trollock/Solar_LoRa_GPS/Hardware/STM32L0/2017-07-13T19-34-48.587Z-Grasshopper.pinmap.jpg

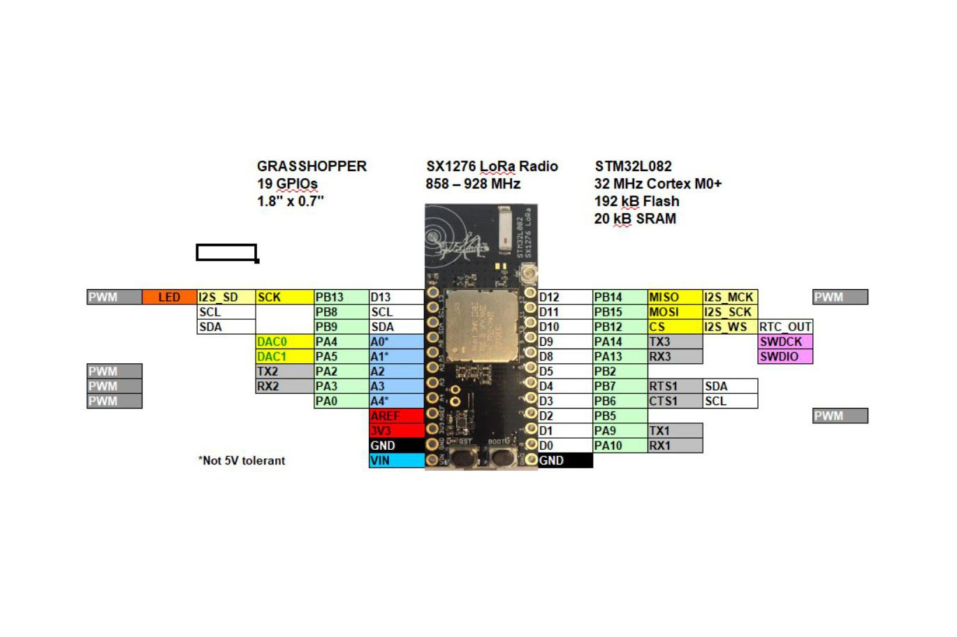
Hardware/STM32L0/2017-07-13T19-34-48.587Z-Grasshopper.pinmap.jpg
