trollock/Solar_LoRa_GPS/Images/IMG_4441.JPG

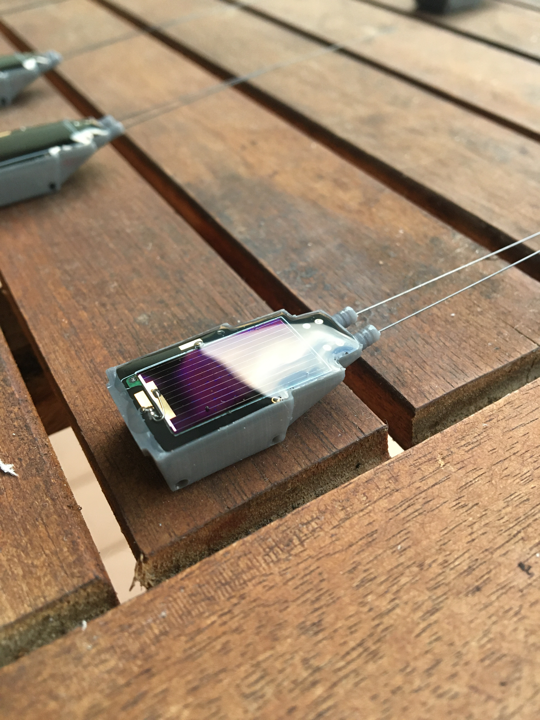
Images/IMG_4441.JPG
