trollock/Solar_LoRa_GPS/README.md

# Solar_LoRa_GPS
files related to the development of the Solar LoRa GPS radiotransceiver including information on the hardware and software
