trollock/Solar_LoRa_GPS/Hardware/duty_cycle_estimation_simple.xlsx

ephemeris update |  | 120
gps fix time |  | 3
current | time on | % on | uA | mA |  | mW power
18 | 7020 | 0.975 | 90.05 | 0.09005 | 2161.2 | 7.13196
2900 | 180 | 0.025
ephemeris update |  | 120
gps fix time |  | 3
current | time on | % on | uA | mA |  | mW power
3 | 7020 | 0.975 | 75.425 | 0.075425 | 1810.2 | 5.97366
2900 | 180 | 0.025
