trollock/Solar_LoRa_GPS/Power_Requirement_Estimates/bq25570SolarAppDesignExample_V1p3.xlsx

User Input
Computed/Fixed
 |  |  | VSTOR nominal | 3.00 | V |  |  |  |  | VBAT_UV < VSTOR nominal <= VBAT_OV
System Loads | VOUT (V) | IOUT (mA) | Est Buck Effcy per datasheet | ISTOR = (VOUTxIOUT) / (VSTORnom x Effcy) (mA) | Mode Duration (how long?) (s) | Mode Period (how often?) (s) | Mode Hours / Day = 24 hours x duration/ period | mAHr / Day = ISTOR X Mode Hrs / Day | mWHr / Day = VSTOR x mAHr / Day
Active Mode 1 - bq25570 VOUT | 3.700 | 29.000 | 0.900 | 39.741
Active Mode 1 - bq25570 VSTOR |  |  |  | 8.000 |  |  |  |  |  | Direct loading on VSTOR
Totals for Active Mode 1 |  |  |  | 47.741 | 8.000 | 3600.000 | 0.053 | 2.546 | 7.639
Active Mode 2 - bq25570 VOUT | 3.700 | 0.000 | 0.850 | 0.000 |  |  |  |  |  | If only one active mode, enter 0 for IOUT.
Active Mode 2 - bq25570 VSTOR |  |  |  | 0.000 |  |  |  |  |  | If only one active mode, enter 0 for ISTOR.
Totals for Active Mode 2 |  |  |  | 0.000 | 0.125 | 600.000 | 0.005 | 0.000 | 0.000
Sleep Mode - bq25570 VSTOR (1.8V rail off) |  |  |  | 0.100 |  |  | 23.942 | 2.394 | 7.182 | Idle mode hours / day = 24 minus active mode hours / day
bq25570 quiescent current + storage element leakage current |  |  |  | 0.001 |  |  | 24.000 | 0.024 | 0.072 | Storage element leaks all the time.
 | Total mAHr / day consumed |  |  |  |  |  |  | 4.964 | mAHr / day
 | Multiply by max consec dark days (e.g. not charging when overcast or raining) |  |  |  |  |  |  | 3.000 | days / week
 | Recommended minimum battery capacity |  |  |  |  |  |  | 14.893 | mAHr
 | -OR-
 | Mininum super capacitor voltage |  |  |  |  |  |  | 2.500 | V | VBAT_UV = 2.0V > Min super capacitor > VSTOR nominal
 | Maximum super capacitor voltage |  |  |  |  |  |  | 4.000 | V | VSTOR nominal < Max super capacitor voltage <= VBAT_OV
 | Recommended minimum super capacitance |  |  |  |  |  |  | 32.994 | F | Min Bat Capacity / 1000 x 3600s/hr x VSTORNOM = 1/2 x CSUPER x (Vmax2 - Vmin2)
 |  | Total mWHr / day consumed |  |  |  |  |  |  | 14.893 | mWHr / day
 |  | Multiply by operating days per week |  |  |  |  |  |  | 7.000 | days / week
 |  | Total mWHr /week required for system operation for the week |  |  |  |  |  |  | 104.251 | mWHr / week
 |  | Divide by charging days per week |  |  |  |  |  |  | 4.000 | days / week | Operating days minus max consecutive dark days
 |  | Total mWHr / day required to be collected by solar panel during charging days |  |  |  |  |  |  | 26.063 | mWHr / day | Total 7-day power must be collected during 5 charging days
 |  | Divide by charging hours / day |  |  |  |  |  |  | 8.000 | hours / day | i.e., includes excess energy for charging the battery
 |  | Instantaneous power required from the solar panel |  |  |  |  |  |  | 3.258 | mW
 |  |  | Divide by low estimate of bq25570 efficiency per datasheet |  |  |  |  |  | 0.800
 |  |  | Minimum input power required for system operation |  |  |  |  |  | 4.072 | mW
 |  |  |  | Divide by panel power per panel datasheet |  |  |  |  | 2.000 | mW/cm2 | Use power from lowest expected light level
 |  |  |  | Minimum solar panel area required |  |  |  |  | 2.036 | cm2
