trollock/Solar_LoRa_GPS/Hardware/ADP_5090_DC_DC_Solar_Controller/MPPT_ADP509X.xlsx

Setting Maximum Power Point Tracking ADP509X
Cell Type | Vmppt | Vin | Open Circuit | Roc1 | Roc2
Default (Alta SJT) | 0.7850220264 | 0.9 | 1.1 | 18 | 4.7
Azurspace 3G28C | 1.617621145 | 1.2 | 1.7 | 18 | 4.7
