trollock/Solar_LoRa_GPS/Hardware/FR4_PCB_Mass_vs_Thickness_Estimates.xlsx

 |  |  |  | FR4 Thickness
Length | Width | Volume | Density | 1.6 | 0.8 | 0.6 | 0.4 | 0.2
 |  |  | g/cc
23 | 36 | 1.3248 | 2 | 2.6496 | 1.3248 | 0.9936 | 0.6624 | 0.3312
16 | 28 |  | 2 | 1.4336 | 0.7168 | 0.5376 | 0.3584 | 0.1792
4 | 8 |  | 2 | 0.1024 | 0.0512 | 0.0384 | 0.0256 | 0.0128
v21_L70
17 | 32 |  | 2 | 1.7408 | 0.8704 | 0.6528 | 0.4352 | 0.2176
14 | 24 |  | 2 | 1.0752 | 0.5376 | 0.4032 | 0.2688 | 0.1344
 |  |  |  |  |  | 0.42 | 0.1664
 |  |  |  |  |  | 0.16
 |  |  |  |  |  | 0.26
