trollock/Solar_LoRa_GPS/API_Integration/Plots/example_1.gif

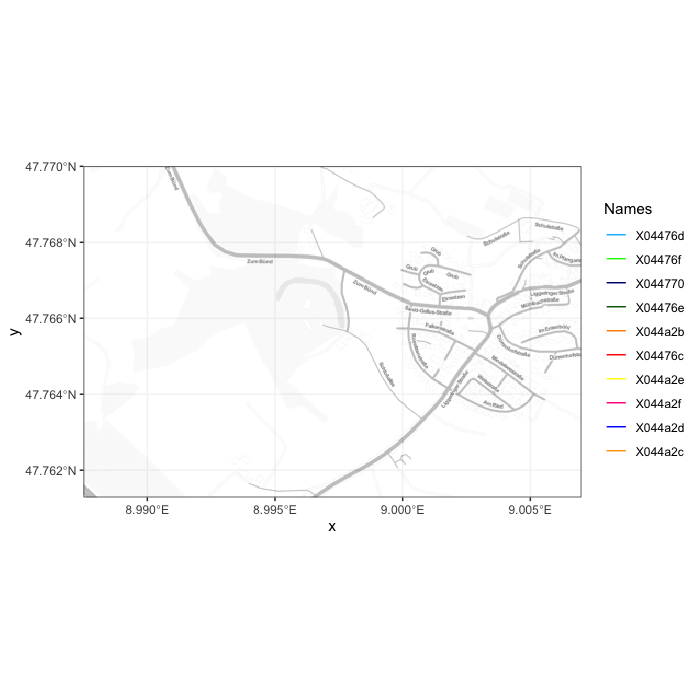
API_Integration/Plots/example_1.gif
