trollock/Solar_LoRa_GPS/API_Integration/Plots/example_2.gif

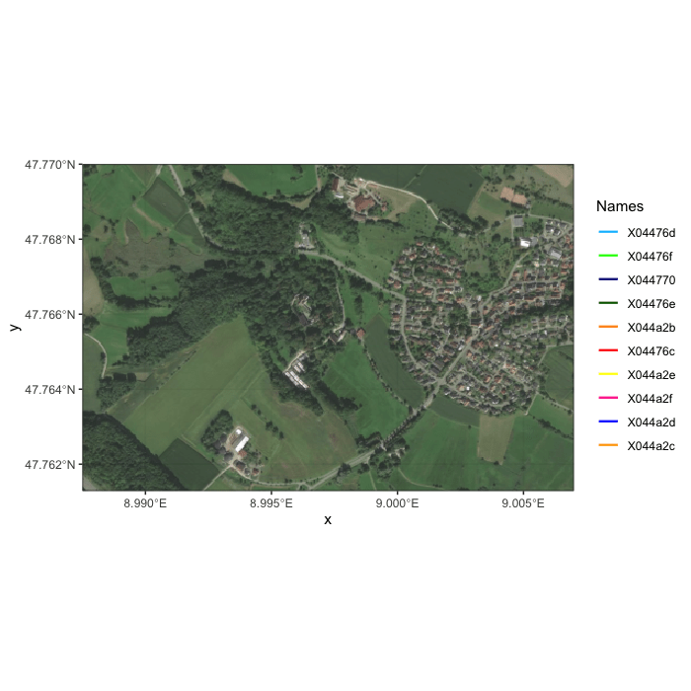
API_Integration/Plots/example_2.gif
