trollock/Solar_LoRa_GPS/API_Integration/Plots/last_10_days.gif

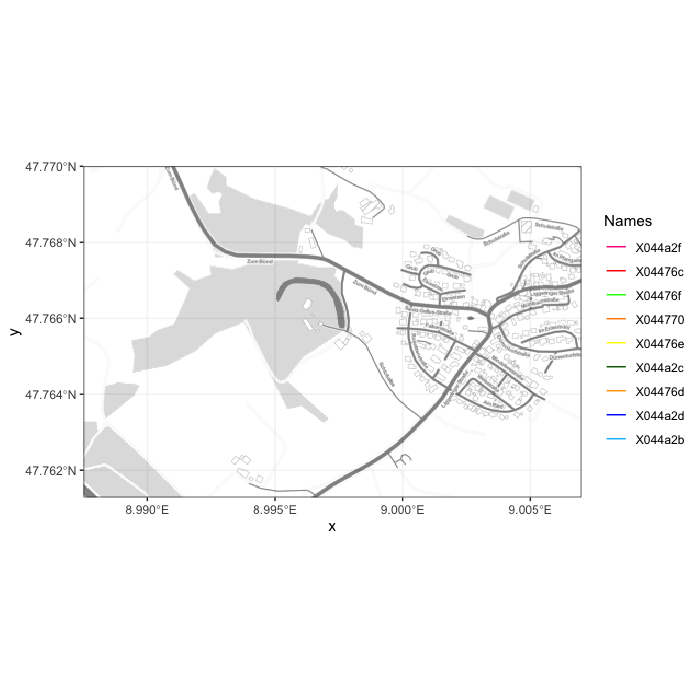
API_Integration/Plots/last_10_days.gif
