trollock/Solar_LoRa_GPS/API_Integration/Screen Shot 2019-12-16 at 12.39.08 PM.png

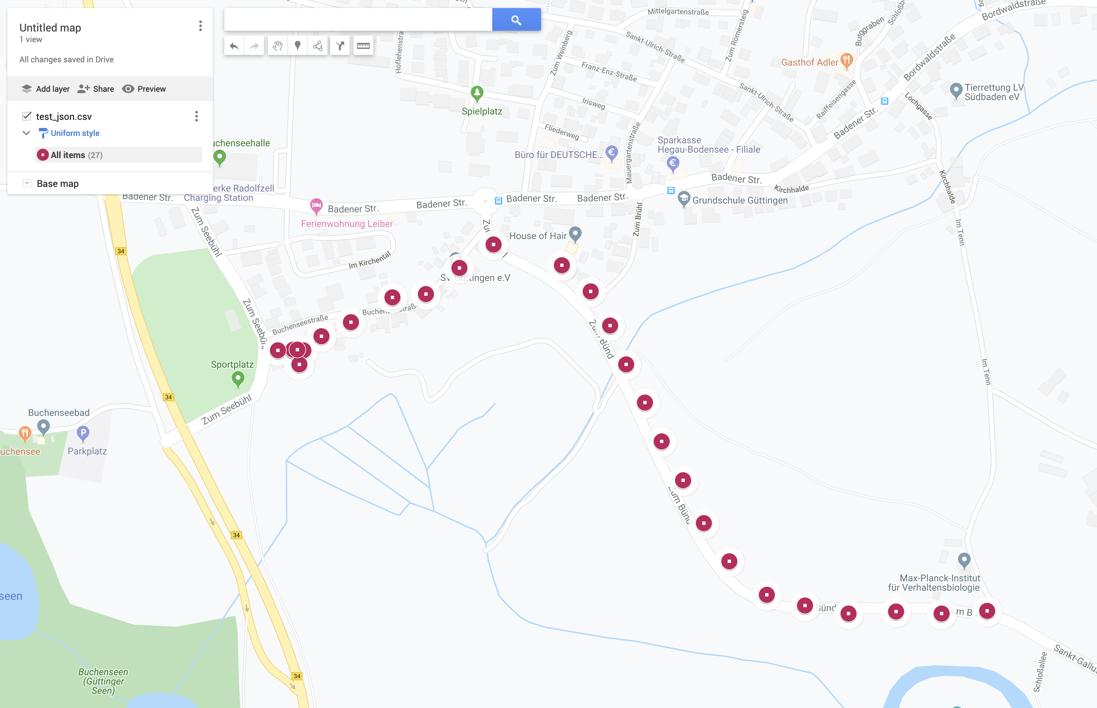
API_Integration/Screen Shot 2019-12-16 at 12.39.08 PM.png
