trollock/Solar_LoRa_GPS/Hardware/STM32L0/2017-09-04T02-27-59.959Z-Grasshopper.sch.jpg

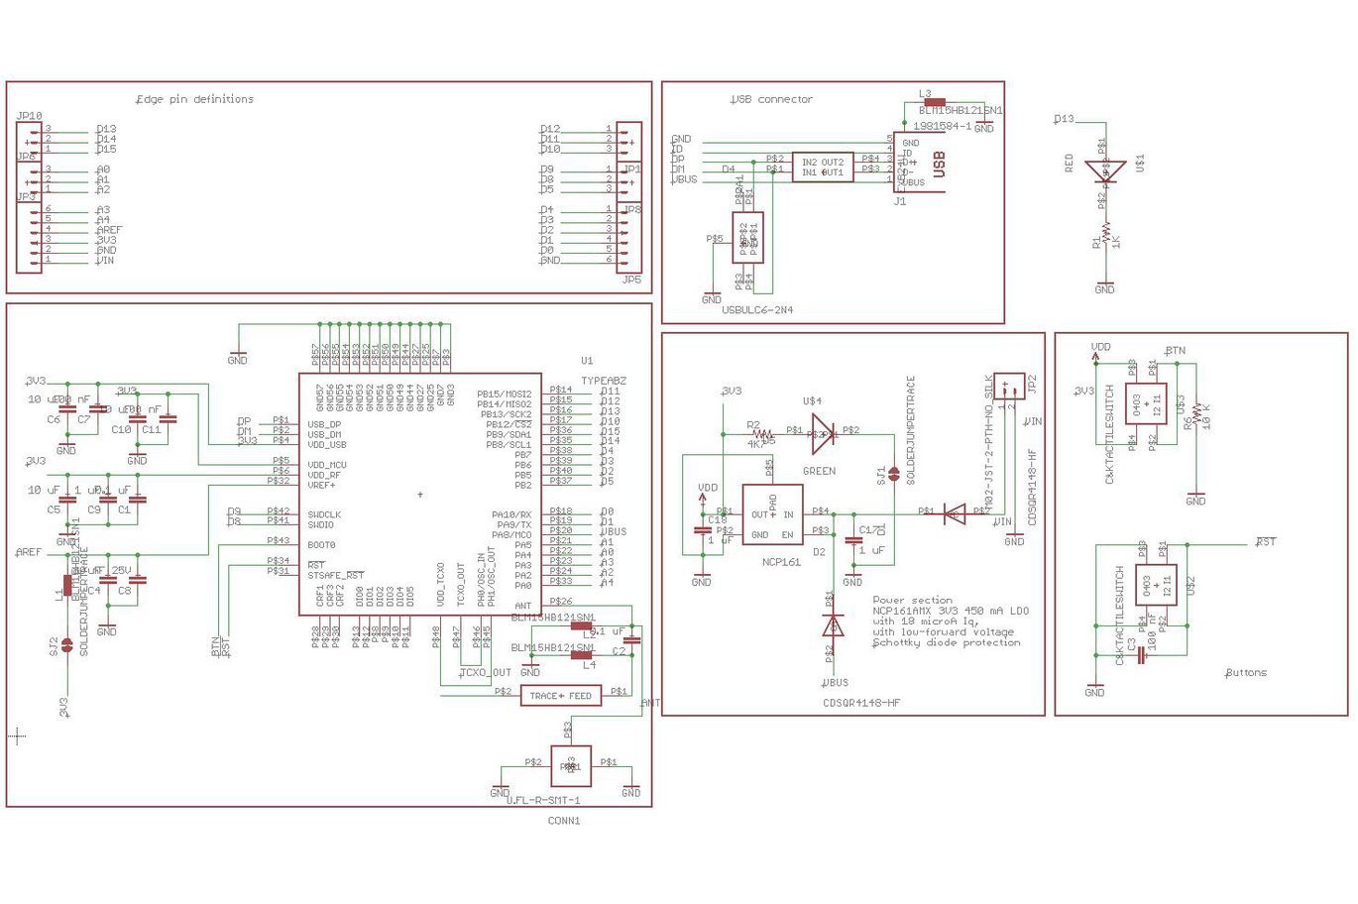
Hardware/STM32L0/2017-09-04T02-27-59.959Z-Grasshopper.sch.jpg
