trollock/Solar_LoRa_GPS/Hardware/STM32L0/2018-12-29T21-33-32.131Z-Gnat.sch.png

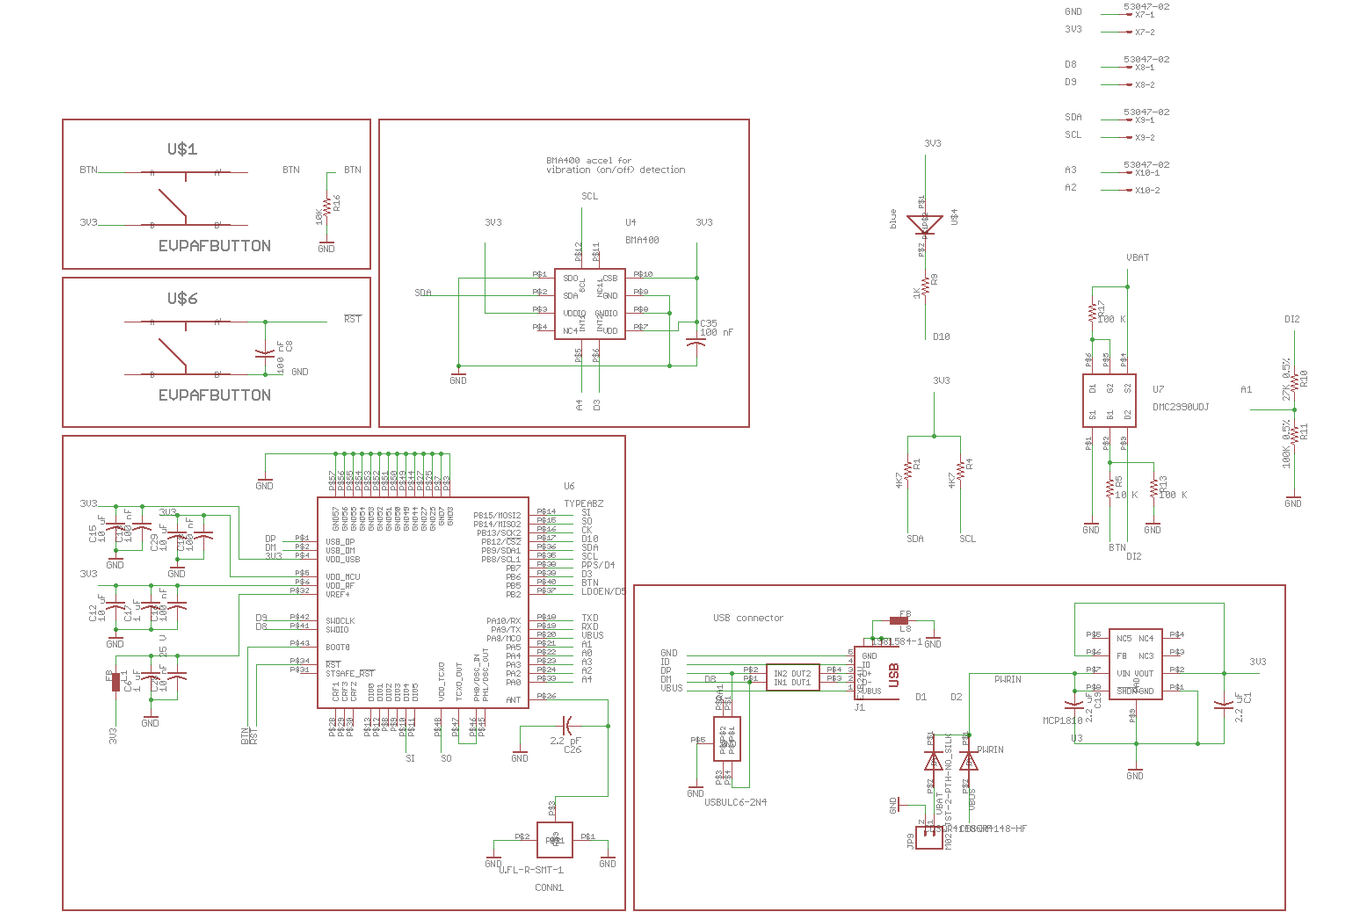
Hardware/STM32L0/2018-12-29T21-33-32.131Z-Gnat.sch.png
