trollock/Solar_LoRa_GPS/Images/Amsel_v5_LoRaWAN_tag.png

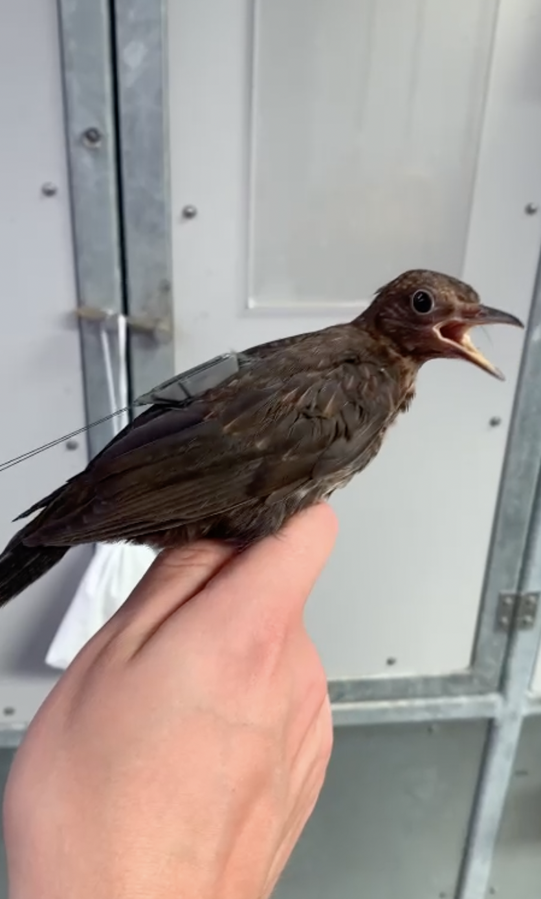
Images/Amsel_v5_LoRaWAN_tag.png
