trollock/Solar_LoRa_GPS/Parts_Lists/Parts_List_v22_July_28.xlsx

Partl | ist
Expor | ted | from GPS_radiologger_v | 22_L70_CMWX.brd at 7/28/21 12 | :17 PM
EAGLE | Ver | sion 9.6.2 Copyright ( | c) 1988-2020 Autodesk, Inc.
Assem | bly | variant:
Part |  | Value | Package | Library | Position (mm) | Orientation
C1 | X | 0.1 uF | C0201 | rcl | (1.41 3.545) | R180
C2 | X | 1 uF | C0201 | rcl | (24.05 2.55) | R90
C4 | X | 10nF | C0201 | rcl | (5.8 2.56) | R180
C7 | X | 0.1 uF | C0201 | rcl | (21.655 2.775) | R0
C9 | X | 1 uF | C0201 | rcl | (1.59738125 13.205) | R270
C10 | X | 0.1 uF | C0201 | rcl | (1.08 13.205) | R270
C13 | X | 47 uF | C0603 | rcl | (14.9 1.81) | R270
C14 | X | 4.7 uF | C0201 | rcl | (2.05 2.31) | R180
C17 | X | 1 uF | 0402-CAP | SparkFun-Capacitors | (19.45 2.5) | R270
C18 | X | 1 uF | 0402-CAP | SparkFun-Capacitors | (16.55 2.5) | R270
IC4 | X | CAT24M01HU5I-GT3 | SON50P300X200X55-9N | CAT24M01HU5I-GT3-CorrectedV2 | (4.048 2.5326) | R270
J1 | DNP |  | 1X01_SMALL | SparkFun-Connectors | (16.25 15.55) | R0
J3 | DNP |  | 1X01_SMALL | SparkFun-Connectors | (16.3 0.8) | R0
J4 | DNP |  | 1X03_1.27MM_NO_SILK | SparkFun-Connectors | (1.25 4.5) | R90
J6 | DNP |  | 1X04_1.27MM_NO_SILK | SparkFun-Connectors | (1.25 8.3) | R90
R1 | X | 4.7 k | R0201 | rcl | (2.05 1.1) | R180
R2 | X | 4.7 k | R0201 | rcl | (2.05 1.75) | R180
R3 | X | 10k | R0201 | rcl | (1.405 2.975) | R0
R6 | X | 10 M | R0201 | rcl | (21.655 2.18) | R180
R7 | X | 4.7 M | R0201 | rcl | (20.905 2.505) | R90
R8 | X | 3M | R0201 | rcl | (5.8 3.95) | R0
R9 | X | 9.1M | R0201 | rcl | (5.8 3.15) | R0
R10 | X | 6.2M | R0201 | rcl | (14.59 3.69) | R0
R11 | X | 1M | R0201 | rcl | (6.05 1) | R90
R12 | X | 3M | R0201 | rcl | (5.8 1.79) | R180
U$1 | X | LPS3015 | LPS_3015 | coilcraft_custom | (12.2 2.285) | R90
U$2 | DNP | NITINOL_ANTENNA_SHORT | ICARUS_NITINOL_ANTENNA_SHORT | Antenna_mounts | (27.8 5.7) | R0
U$3 | DNP | ICARUS_FULL | ICARUS_FULL | TrisolX_Solar_Cells | (14.35 8.2) | MR90
U$4 | DNP | NITINOL_ANTENNA_SHORT | ICARUS_NITINOL_ANTENNA_SHORT | Antenna_mounts | (27.8 10.7) | R180
U$6 | DNP | ICARUS_V4_FOOTPRINT | ICARUS_FULL_FOOTPRINT | TrisolX_Solar_Cells | (14.05 8.2) | MR270
U1 | X | TYPEABZ | TYPEABZ | Kris | (8.236734375 10.15) | R0
U2 | X | L70 | XCVR_L70 | L70 | (20.05 8.9) | R90
U3 | X | TPS22907 | TPS22916 | TPS22916V2 | (20.7 0.45) | R90
U4 | X | SPV1050 | SPV1050 | STM-SPV1050_V2 | (8.02 2.49) | R0
U5 | X | TPS7A03 | NCP161 | Kris | (18 2.6) | R270
U6 | X | TPS22907 | TPS22916 | TPS22916V2 | (23.1 2.5) | R270
