trollock/Solar_LoRa_GPS/Hardware/Component_Masses.xlsx

 | Component | part number | notes | Mass
ICARUS | pcb | n/a | without battery or housing | 2.05
ICARUS | pcb w/ battery | n/a | with 70 mAh battery | 3.7
ICARUS | battery |  |  | 1.65
LoRa | pcb | n/a | 0.4 mm 2-layer | 0.65 | 1.37 | 0.325
 | CCMWX1ZZABZ | CCMWX1ZZABZ | 78 | 0.48 |  | 0.48
 | uBlox GPS | ZOE-M8Q |  | 0.07 |  | 0.07
 | DC-DC | ADP-5090 |  | 0.01 |  | 0.01
 | Solar cell | ??? | 12x21mm | 0.16 |  | 0.16
 |  |  |  | 1.37 |  | 1.045
 | Lithium polymer battery | Italian eBay | 45 mAh | 1.1 |  | 2.47
 |  | Powerstream | GM30101H 14 mAh 140 mA C | 0.54 |  | 1.585
 |  | Powerstream | GM301016 25 mAh | 0.62 |  | 1.665
 |  | Powestream | 8 mAh | 0.33 |  | 1.375
