trollock/Solar_LoRa_GPS/Development Notes/PMIC_database.xlsx

 |  | Cold startup |  | MPPT voltage |  | Quiescent ON | Quiescent SLP | I2C Config. | Max LDO Current | LDO | Package | Package Dim | Passives | Rec. Inductor | Typical Price | Price Unit | Available | Distributor | Quantity | Date
Manufacturer | Device | mV | uW | min (mV) | max (V) | nA | nA | Y/N | mA |  |  | L x W | RCL | uH | € | per
Maxim Integrated | MAX20361 | 225 | 15 | 225 | 2.5 | 360 | 190 | Yes | 90-470 | No | WLP | 1.6 x 1.2mm | 2 C, 1 L | 4.7 | 5,00 € | per 500 | Factory | Maxim | 2070 | 2022-02-11
ePEAs | AEM10900 | 250 | 5 | 115 | 1.5 | 300 | 150 | Yes | n/a | No | WLCSP | 2 x 2mm | 2 C, 1 L | 4.7 | ? | ? | No |  |  | 2022-02-11
ePEAs | AEM10900 | 250 | 5 | 115 | 1.5 | 300 | 150 | Yes | n/a | No | QFN | 4 x 4mm | 2 C, 1 L | 4.7 | 3,87 € | per 25 | Yes | Tekmodul | ? | 2022-02-11
ePEAs | AEM10941 | 380 | 3 | 50 | 5 | ? | ? | No | 80 | Yes | QFN | 5 x 5mm | 5 C, 2 L | 10 | 4,55 € | per 500 | Yes | Mouser | 1697 | 2022-02-11
ePEAs | AEM10300 | 275 | 3 | 100 | 4.5 | ? | 5.9 | No | n/a | No | QFN | 4 x 4mm | 2 C, 1 L | 10 | ? | ? | No |  |  | 2022-02-11
ePEAs | AEM10330 | 275 | 3 | 100 | 4.5 | ? | 875 | No | 60 | Yes | QFN | 5 x 5mm | 3 C, 1 L | 10 | 5,06 € | per 500 | Yes | Tekmodul | ? | 2022-02-11
Analog Devices | ADP5090 | 380 | 16 | 80 | 3.3 | 320 | 260 | No | n/a | No | LFCSP | 3 x 3mm | 9 R, 2 C, 1 L | 22 | 4,63 € | per 500 | Yes | Digikey | 1448 | 2022-02-11
Analog Devices | ADP5091/92 | 380 | 6 | 80 | 3.3 | 510 | 390 | No | n/a | No | LFCSP | 3 x 3mm | 9 R, 2 C, 1 L | 22 | 5,27 € | per 500 | Yes | Digikey | 3042 | 2022-02-11
ST Microelectronics | SPV1050TTR | 550 | 16 | 150 | 4.3 | 1700 | 1 | No | n/a | Yes | QFN | 3 x 3mm | 6 R, 3 C, 1 L | 22 | 2,80 € | per 500 | No |  |  | 2022-02-11
Texas Instruments | BQ25504 | 600 | 15 | 130 | 3 | ? | 330 | No | n/a | No | QFN | 3 x 3mm | 9 R, 3 C, 1 L | 22 | 3,06 € | per 500 | Yes | Mouser | 1862 | 2022-02-11
