trollock/Solar_LoRa_GPS/EAGLE/v23_L70_CMWX/Shipment_to_PCBWay/Shipping_Contents.xlsx

Contents (total components per piece for prototype sample)
Qty | Mechnaical Value | Device | Group | Parts | Value (CHF)
2 | 0.1 uF | C-EUC0201 | 0201 Capacitor | C1, C7 | 0.045
2 | 1 uF | 0402CAP.KW | 0201 Capacitor | C17, C18 | 0.045
2 | 1 uF | C-EUC0201 | 0201 Capacitor | C2, C9 | 0.045
1 | 10k | R-EU_R0201 | 0201 Resistor | R3 | 0.045
1 | 10nF | C-EUC0201 | 0201 Capacitor | C4 | 0.045
1 | 150 K | R-EU_R0201 | 0201 Resistor | R7 | 0.03
1 | 1M | R-EU_R0201 | 0201 Resistor | R11 | 0.03
1 | 300 K | R-EU_R0201 | 0201 Resistor | R6 | 0.03
2 | 3M | R-EU_R0201 | 0201 Resistor | R8, R12 | 0.03
2 | 4.7 k | R-EU_R0201 | 0201 Resistor | R1, R2 | 0.03
1 | 4.7 uF | C-EUC0201 | 0201 Capacitor | C14 | 0.045
1 | 47 uF | C-EUC0603 | 0201 Capacitor | C13 | 0.045
1 | 6.2M | R-EU_R0201 | 0201 Resistor | R10 | 0.03
1 | 9.1M | R-EU_R0201 | 0201 Resistor | R9 | 0.03
1 | CAT24M01HU5I-GT3 | CAT24M01HU5I-GT3 | Transistor Switch | IC4 | 0.09
1 | L70 | L70 | GNSS / GPS Module | U2 | 1.51
1 | LPS3015 | LPS3015 | 22 uH Inductors | U$1 | 0.05
1 | NCP161 | NCP161 | Transistor Switch | U5 | 0.09
1 | SPV1050 | SPV1050 | Transistor Switch | U4 | 0.09
2 | TPS22907YZT | TPS22907YZT | Transistor Switch | U3, U6 | 0.09
1 | TYPEABZ | TYPEABZ | LoRaWAN Radio | U1 | 1.65
 |  |  | Total value per piece |  | 4.97
Sample components for assembly of 100 pieces are included in shipment, total value ~497 CHF (Swiss Francs)
