trollock/Solar_LoRa_GPS/Hardware/Approximate_Costs.xlsx

CMWX_v25
Component | Component | Vendor | Units | Inventory |  | Cost (ea) | Subtotal | Shipping | MWSt | Subtotal | Ordered
CMWX1ZZABZ-078 |  | multiple | 394 | 394 |  | 22.195
 | CMWX1ZZABZ-078 | SensiEdge | 39 |  | USD | 28 | 1092
 | CMWX1ZZABZ-078 | SensiEdge | 80 |  | USD | 28 | 2240
 | CMWX1ZZABZ-078 | Farnell | 200 |  | CHF | 16.39 | 3278 |  | 252.41
 | CMWX1ZZABZ-078 | Farnell | 75 |  | CHF | 16.39 | 1229.25 |  | 94.65 |  |  | 0
LG77LAMD |  | multiple | 224 | 224 |  | 4.415
 | LG77L-A | TekModule.de | 24 |  | EU | 4.86 | 116.64 | 0 | 0
 | LG77L-A | TekModule.de | 200 |  | EU | 3.97 | 794 | 0 | 0
BMP581 |  | Digikey | 0 | 0 | EU | 2.699 | 0 |  | 0 |  | 400
MAX20361 |  |  | 428 | 0 |  | 4.515 |  |  |  |  | 428
 | MAX20361 | Farnell | 328 | 0 | CHF | 4.07 | 1334.96 | 0 |  |  | 328
 | MAX20361 | Digikey | 100 | 0 | USD | 4.96 | 496 | 0 | 38.192 |  | 100
LC709203 |  | Rochester Electronics | 447 | 0 | EU | 0.6249 | 279.3303 |  |  | 319.47 | 447
TPS7A0333PYCHR (https://www.mouser.ch/ProductDetail/Texas-Instruments/TPS7A0333PYCHR?qs=DRkmTr78QASt%252BMCkG4QYQg%3D%3D) |  | Mouser | 400 | 0 | CHF | 0.6 | 240
TPSS22916? |  |  |  | 0 |  |  | 0
CAT24C512C8UTR (https://www.mouser.ch/ProductDetail/863-CAT24C512C8UTR) |  | Mouser | 400 | 0 |  | 0.794 | 317.6
ICARUS v2 |  | MPIAB / CESI | 22 | 0 | EU
GEB 401012 30 mah |  | GEB Battery | 400 | 0 | EU | 0.895 | 358 | 195 | ??? |  | 400
