trollock/Solar_LoRa_GPS/EAGLE/v23_L70_CMWX/v23_Shipley_BOM_PCBWay.xlsx

 |  |  | CMWX LoRaWAN Tag v23 Shipley 100 PCS BOM (Sample Bill of Materials)
Item # | *Designator | *Qty | Manufacturer | *Mfg Part # | Description / Value | *Package/Footprint | Position | Orientation | Type | Your Instructions / Notes
1 | C1 | 1 | Murata | GRT033R60J104KE01D | 0.1 uF | C0201 | (1.455 5.06) | R270 | SMD
2 | C2 | 1 | Murata | GRM033R60J105MEA2D | 1 uF | C0201 | (24.85 2.65) | R270 | SMD
3 | C4 | 1 | Murata | GRM033R71A103KA01D | 10nF | C0201 | (5.8 2.46) | R180 | SMD
4 | C7 | 1 | Murata | GRT033R60J104KE01D | 0.1 uF | C0201 | (20.125 2.345) | R270 | SMD
5 | C9 | 1 | Murata | GRM033R60J105MEA2D | 1 uF | C0201 | (1.49738125 12.455) | R270 | SMD
6 | C13 | 1 | Murata | GRM188R60J476ME01D | 47 uF | C0603 | (14.8 1.71) | R270 | SMD
7 | C14 | 1 | Murata | GRM035R60G475ME15D | 4.7 uF | C0201 | (2.05 2.31) | R180 | SMD
8 | C17 | 1 | Murata | GRT155R61C105KE01J | 1 uF | 0402-CAP | (19.35 2.5) | R270 | SMD
9 | C18 | 1 | Murata | GRT155R61C105KE01J | 1 uF | 0402-CAP | (16.55 2.5) | R270 | SMD
10 | IC4 | 1 | ON Semiconductor | CAT24M01HU5I-GT3 | CAT24M01HU5I-GT3 | SON50P300X200X55-9N | (4.048 2.4326) | R270 | SMD
11 | J1 | 1 | n/a | n/a | 1_PIN | 1X01_SMALL | (16.25 15.55) | R0 | DNP | Do not install
12 | J3 | 1 | n/a | n/a | 1_PIN | 1X01_SMALL | (16.25 0.8) | R0 | DNP | Do not install
13 | R1 | 1 | Vishay-Dale | CRCW02014K70FKED | 4.7 k | R0201 | (2.05 1) | R180 | SMD
14 | R2 | 1 | Vishay-Dale | CRCW02014K70FKED | 4.7 k | R0201 | (2.05 1.7) | R180 | SMD
15 | R3 | 1 | Vishay-Dale | CRCW020110K0FNED | 10k | R0201 | (1.425 6.555) | R90 | SMD
16 | R6 | 1 | Vishay-Dale | CRCW0201300KFNED | 300 K | R0201 | (20.78 2.345) | R90 | DNP | Do not install
17 | R7 | 1 | Vishay-Dale | CRCW0201150KFNED | 150 K | R0201 | (21.445 2.345) | R270 | DNP | Do not install
18 | R8 | 1 | Vishay-Dale | CRCW02013M00FNED | 3M | R0201 | (5.8 3.85) | R0 | SMD
19 | R9 | 1 | Vishay-Dale | CRCW02019M09FNED | 9.1M | R0201 | (5.8 3.05) | R0 | SMD
20 | R10 | 1 | Panasonic | ERJ-1GNJ625C | 6.2M | R0201 | (14.59 3.59) | R0 | SMD
21 | R11 | 1 | Vishay-Dale | CRCW02011M00FNED | 1M | R0201 | (6.05 0.9) | R90 | SMD
22 | R12 | 1 | Vishay-Dale | CRCW02013M00FNED | 3M | R0201 | (5.8 1.64) | R180 | SMD
23 | U$1 | 1 | Coilcraft | LPS3015-223MRC | LPS3015 | LPS_3015 | (12.2 2.185) | R90 | SMD
24 | U$2 | 1 | n/a | n/a | NITINOL_ANTENNA_SHORT | non-standard | (27.8 5.7) | R0 | DNP | Do not install
25 | U$3 | 1 | n/a | n/a | ICARUS_FULL_RAW (CESI) | non-standard | (14.35 8.2) | MR90 | DNP | Do not install
26 | U$4 | 1 | n/a | n/a | NITINOL_ANTENNA_SHORT | non-standard | (27.8 10.7) | R180 | DNP | Do not install
27 | U$5 | 1 | n/a | n/a | CASTELLATED_7_PIN | CASTELLATED_7_PIN | (0.4 3.8) | R0 | DNP | Do not install
28 | U$6 | 1 | n/a | n/a | ICARUS_V4_FOOTPRINT (CESI) | non-standard | (14.05 8.2) | MR270 | DNP | Do not install
29 | U1 | 1 | Murata | CMWX1ZZABZ | Murata CMWX LoRaWAN STM32 based radio | TYPEABZ | (8.236734375 10.15) | R0 | SMD
30 | U2 | 1 | Quectel | L70B-M39 | Low-power GNSS/GPS Receiver | XCVR_L70 | (20.05 8.9) | R90 | SMD
31 | U3 | 1 | Texas Instruments | TPS22907YZTR | TPS22907YZT | YFP0004-DSBGA | (22.25 2.6) | R270 | SMD
32 | U4 | 1 | STMicroelectronics | SPV1050TTR | SPV1050 | SPV1050 | (8.02 2.39) | R0 | SMD
33 | U5 | 1 | Texas Instruments | TPS7A0333DQNR | TPS7A0333DQNR | TPS7A0333DQNR | (17.95 2.6) | R270 | SMD
34 | U6 | 1 | Texas Instruments | TPS22907YZTR / YZTT | TPS22907YZT / YSTT | YFP0004-DSBGA | (23.4 2.6) | R180 | SMD
