trollock/Solar_LoRa_GPS/EAGLE/v22_CMWX_L70/Gerbers/CMWX_V22_BOM.xlsx

 |  |  | Peltier_controller_v2_1 25PCS BOM (Sample Bill of Materials)
Item # | *Designator | *Qty | Manufacturer | *Mfg Part # |  | Description / Value | *Package/Footprint | Type | Your Instructions / Notes
1 | J1, J3 | 2 | N/A | N/A |  | N/A | 1X01_SMALL | N/A | Via Array
2 | J5 | 1 | N/A | N/A |  | N/A | 1X03_1.27MM_NO_SILK | N/A | Via Array
3 | J2 | 1 | N/A | N/A |  | N/A | 1X06_1.27MM | N/A | Via Array
4 | C1, C7, C10 | 3 | Murata | GRT033R60J104KE01D | X | 0.1 uF | C0201 | SMD | Will provide parts
5 | C17, C18 | 2 | Murata | GRT155R61C105KE01J | X | 1 uF | 0402-CAP | SMD | Will provide parts
6 | C2, C9 | 2 | Murata | GRM033R60J105MEA2D | X | 1 uF | C0201 | SMD | Will provide parts
7 | R6 | 1 | Vishay Dale | CRCW020110M0FNED | X | 10 M | R0201 | SMD | Will provide parts
8 | R3 | 1 | Vishay Dale | CRCW020110K0FNED | X | 10k | R0201 | SMD | Will provide parts
9 | C4 | 1 | Murata | GRM033R71A103KA01D | X | 10nF | C0201 | SMD | Will provide parts
10 | R11 | 1 | Vishay Dale | CRCW02011M00FNED | X | 1M | R0201 | SMD | Will provide parts
11 | R8, R12 | 2 | Vishay Dale | CRCW02013M00FNED | X | 3M | R0201 | SMD | Will provide parts
12 | R7 | 1 | Vishay Dale | CRCW02014M70FNED | X | 4.7 M | R0201 | SMD | Will provide parts
13 | R1, R2 | 2 | Vishay Dale | CRCW02014K70FKED | X | 4.7 k | R0201 | SMD | Will provide parts
14 | C14 | 1 | Murata | GRM035R60G475ME15D | X | 4.7 uF | C0201 | SMD | Will provide parts
15 | C13 | 1 | Murata | GRM188R60J476ME01D | X | 47 uF | C0603 | SMD | Will provide parts
16 | R10 | 1 | Panasonic | ERJ-1GNJ625C | X | 6.2M | R0201 | SMD | Will provide parts
17 | R9 | 1 | Vishay Dale | CRCW02019M09FNED | X | 9.1M | R0201 | SMD | Will provide parts
18 | IC4 | 1 | ON Semiconductor | CAT24M01HU5I-GT3 | X | CAT24M01HU5I-GT3 | SON50P300X200X55-9N | SMD | Will provide parts
19 | D2 | 1 | Comchip | CDSQR4148-HF | X | CDSQR4148-HF | CDSQR4148-HF | SMD | Will provide parts
20 | U$3 | 1 | CESI | N/A |  | ICARUS_FULL | ICARUS_FULL | N/A | DO NOT INSTALL
21 | U$6 | 1 | CESI | N/A |  | ICARUS_V4_FOOTPRINT | ICARUS_FULL_FOOTPRINT | N/A | DO NOT INSTALL
22 | U2 | 1 | Quectel | L70-M39 |  | L70 | XCVR_L70 | SMD | Will provide parts
23 | U$1 | 1 | Coilcraft | LPS3015-222MRB |  | LPS3015 | LPS_3015 | SMD | Will provide parts
23 | U5 | 1 | Texas Instruments | TPS7A03 | X | TPS7A03 | NCP161 | SMD | Will provide parts
24 | U$2, U$4 | 2 | N/A | N/A |  | NITINOL_ANTENNA_SHORT | ICARUS_NITINOL_ANTENNA_SHORT | N/A | DO NOT INSTALL
25 | U4 | 1 | STMicroelectronics | SPV1050TTR | X | SPV1050 | SPV1050 | SMD | Will provide parts
26 | U6 | 1 | Texas Instruments | TPS22907YZTR | X | 296-39359-1-ND | TPS22916 | SMD | Will provide parts
27 | U1 | 1 | Murata | N/A |  | TYPEABZ | TYPEABZ | SMD | Will provide parts
