trollock/Solar_LoRa_GPS/EAGLE/v27_LG77L_CMWX/BOM/v27_Shipley_BOM_PCBWay.xlsx

Item # | *Designator | *Qty | Chk | Sent | Qty | Manufacturer | Part # | Manufacture Part # | Vendor | Description / Value | *Package/Footprint | Position X | Position Y | Orientation | Type | Notes
1 | ANT_GPS | 1 |  |  |  | N/A | NITINOL_ANTENNA_SHORT | N/A |  | NITINOL_ANTENNA_SHORT | N/A | 22.45 | 7.96 | 180 | DNP | Do not install
2 | ANT_LORA | 1 |  |  |  | N/A | NITINOL_ANTENNA_SHORT | N/A |  | NITINOL_ANTENNA_SHORT | N/A | 22.45 | 5.21 | 0 | DNP | Do not install
3 | C3 | 1 | X | X | 30 | Generic | 10 uF | GRM188R6YA106MA73J (https://www.mouser.ch/ProductDetail/Murata-Electronics/GRM188R6YA106MA73J?qs=5aG0NVq1C4xLSwNPdfnaYg%3D%3D) | Mouser | 10 uF | 0603 | 22.71 | 2.63 | 270 | SMD
4 | C4 | 1 | X | X | 30 | Generic | 1 uF | GRM155R61E105MA12D (https://www.mouser.ch/ProductDetail/Murata-Electronics/GRM155R61E105MA12D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) | Mouser | 1 uF | 0402 | 19.37 | 3.85 | 270 | SMD
5 | C5 | 1 | X | X | 30 | Generic | 1 uF | GRM155R61E105MA12D | Mouser | 1 uF | 0402 | 18.39 | 3.85 | 270 | SMD
6 | C6 | 1 | X | X | 30 | Generic | 0.1 uF | GRM152R61A104KE19D (https://www.mouser.ch/ProductDetail/Murata-Electronics/GRM152R61A104KE19D?qs=IPQhFcwEUOjgOs7G%2Fz457g%3D%3D) | Mouser | 0.1 uF | 0402 | 17.18 | 4.5 | 270 | SMD
7 | C7 | 1 | X | X | 30 | Generic | 1 uF | GRM033R61C105ME15D (https://www.mouser.ch/ProductDetail/Murata-Electronics/GRM033R61C105ME15D?qs=u16ybLDytRZR0II5ummfwQ%3D%3D) | Mouser | 1 uF | 0201 | 22.7 | 9.24 | 0 | SMD
8 | C8 | 1 | X | X | 30 | Generic | 1 uF | GRM155R61E105MA12D | Mouser | 1 uF | 0402 | 15.98 | 4.5 | 90 | SMD
9 | L1 | 1 | X | X | 30 | Generic | IND_2016 | DFE201612E-4R7M=P2 (http://d.digikey.com/dc/mn-w0iJh4uEE_bUitNCuXoeYCNqWjdFJOsEcI8P3zDcZzOqW_iasKJiGfNmrrTll8T7knO_YFXMTrQ88nCrHN4RU2joFqNz155VCzsN_fPqf-AcK-Sq-HRaRQFTFBI-JVvVK6R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) | Mouser | IND_2016 | 2016 | 20.97 | 2.63 | 90 | SMD
10 | R1 | 1 | X | X | 30 | Generic | 4.7 k | ERA-1AEB472C (https://www.mouser.ch/ProductDetail/Panasonic/ERA-1AEB472C) | Mouser | 4.7 k | 0201 | 22.68 | 10.35 | 180 | SMD
11 | R2 | 1 | X | X | 30 | Generic | 4.7 k | ERA-1AEB472C (https://www.mouser.ch/ProductDetail/Panasonic/ERA-1AEB472C) | Mouser | 4.7 k | 0201 | 22.7 | 10.98 | 180 | SMD
12 | R3 | 1 | X | X | 30 | Generic | 10k | ERA-1AEB103C (https://www.mouser.ch/ProductDetail/Panasonic/ERA-1AEB103C) | Mouser | 10k | 0201 | 22.69 | 9.8 | 180 | SMD
13 | U1 | 1 |  | X | 25 | Murata | TYPEABZ | CMWX1ZZABZ-078 |  | TYPEABZ | TYPEABZ | 6.74 | 7.8 | 0 | SMD
14 | U2 | 1 | X | X | 25 | Quectel | LG77 | LG77LICMD (https://www.mouser.ch/ProductDetail/Quectel/LG77LICMD?qs=iLbezkQI%252Bsh18CGKAByfRA%3D%3D) | Mouser | LG77 | L70 | 16.77 | 10.14 | 180 | SMD
15 | U3 | 1 | X | X | 30 | Bosch Sensortec | BMP581 | BMP581 (https://www.mouser.ch/ProductDetail/Bosch-Sensortec/BMP581?qs=Li%252BoUPsLEntPL9tlFmcgXg%3D%3D) | Mouser | BMP581 | 2x2mm LGA | 21.72 | 12.6 | 180 | SMD
16 | U4 | 1 | X | X | 30 | Texas Instruments | TPS7A03-DSBGA | TPS7A0333PYCHR (https://www.mouser.ch/ProductDetail/Texas-Instruments/TPS7A0333PYCHR?qs=DRkmTr78QASt%252BMCkG4QYQg%3D%3D) | Mouser | TPS7A03-DSBGA | DSBGA(4) | 14.25 | 2 | 90 | SMD
17 | U5 | 1 | X | X | 25 | ON Seminconductor | MAX17048 | MAX17048G+T10 (https://www.mouser.ch/ProductDetail/Maxim-Integrated/MAX17048G%2bT10?qs=D7PJwyCwLAoGnnn8jEPRBQ%3D%3D) | Mouser | MAX17048 | WSON | 16.59 | 2.54 | 0 | SMD
18 | U6 | 1 | X | X | 30 | Texas Instruments | TPS22902YFPR | TPS22902YFPR (https://www.mouser.ch/ProductDetail/Texas-Instruments/TPS22902YFPR?qs=drm0CCHqiV6zET1B8r6XMg%3D%3D) | Mouser | TPS22902YFPR | DSBGA(4) | 14.25 | 3.4 | 90 | SMD
19 | U7 | 1 | X | X | 30 | ON Seminconductor | CAT24_WLCSP8 | CAT24C512C8UTR (https://www.mouser.ch/ProductDetail/onsemi/CAT24C512C8UTR?qs=PqoDHHvF648jdbo5mulY3g%3D%3D) | Mouser | CAT24_WLCSP8 | WLCSP | 21.39 | 10.35 | 270 | SMD
20 | U8 | 1 |  | X | 25 | Maxim Integrated | MAX20361 | MAX20361 |  | MAX20361 | DSBGA(12) | 18.87 | 2.2 | 180 | SMD
