trollock/Solar_LoRa_GPS/EAGLE/v19_LoRa_only/CAMOutputs/Assembly/Parts_Cost.xlsx

 |  |  |  |  |  | cost
C1 | 24.74 | 15.26 | 0 | 0.1 uF | C0201 | 0.25
C10 | 14.65 | 10.73 | 0 | 0.1 uF | C0201 | 0.25
C13 | 6.88 | 11.69 | 90 | 47 uF | C0805K | 0.25
C14 | 13.72 | 8.29 | 0 | 4.7 uF | C0201 | 0.25
C2 | 16.8 | 2.5 | 90 | 1 uF | C0201 | 0.25
C4 | 13.77 | 10.74 | 0 | 10nF | C0201 | 0.25
C5 | 6.13 | 2.44 | 90 | 4.7 uF | C0201 | 0.25
C6 | 9.73 | 3.62 | 270 | 0.1 uF | C0201 | 0.25
C7 | 8.13 | 12.13 | 270 | 0.1 uF | C0201 | 0.25
C9 | 14.65 | 9.95 | 0 | 1 uF | C0201 | 0.25
IC4 | 12.32 | 2.4 | 0 | CAT24M01HU5I-GT3 | SON50P300X200X55-9N | 1.74
L2 | 8.06 | 2.43 | 0 | 2.2uH | 806 | 0.25
R1 | 15.6 | 1.35 | 0 | 4.7 k | R0201 | 0.25
R10 | 10.26 | 12.33 | 180 | 6.2M | R0201 | 0.25
R11 | 11.39 | 13 | 180 | 1M | R0201 | 0.25
R12 | 12.9 | 12.19 | 180 | 3M | R0201 | 0.25
R2 | 15.6 | 2.05 | 0 | 4.7 k | R0201 | 0.25
R3 | 15.51 | 15.28 | 0 | 10k | R0201 | 0.25
R6 | 8.73 | 12.13 | 90 | 10 M | R0201 | 0.25
R7 | 8.76 | 13.16 | 90 | 4.7 M | R0201 | 0.25
R8 | 13.74 | 9.31 | 0 | 3M | R0201 | 0.25
R9 | 13.75 | 9.96 | 180 | 9.1M | R0201 | 0.25
U$1 | 13.03 | 5.87 | 180 | LPS3015 | LPS_3015 | 0.25
U$2 | 31.21 | 6.66 | 0 | NITINOL_ANTENNA_SHORT | ICARUS_NITINOL_ANTENNA_SHORT | 0.25
U1 | 21.39 | 9.05 | 0 | TYPEABZ | TYPEABZ | 12.07
U2 | 6.84 | 5.85 | 90 | UBLOX_ZOE_M8-0-10 | UBLOX_ZOE_M8-0-10 | 24.58
U4 | 11.34 | 10.28 | 180 | SPV1050 | SPV1050 | 2.57
U6 | 17.64 | 1.95 | 90 | TPS22916 | TPS22916 | 0.48
Y1 | 10.21 | 6.21 | 90 | 32.768kHz | CRYSTAL-SMD-3.2X1.5MM
Y2 | 1.25 | 8.25 | 270 | GPS_CHIP_ANTENNAW3011 | W3011 | 1.3
 |  |  |  |  |  | 48.49
