trollock/Solar_LoRa_GPS/Hardware/MAX20361/MAX20361_Inductor_Comparisons.xlsx

Inductors for the MAX201361
Recommended
Manufacturer | Part Number | Inductance | V | I | Isat | DCR | Resonance | Dimensions
Murata | DFE201612E-4R7M=P2 | 4.7 | 20 | 1.2 | 1.8 | 0.252 | 1 MHz | 2 x 1.6 x 2
Murata | DFE252010F-4R7M=P2 | 4.7 | 20 | 1.4 | 1.9 | 0.24 | 1 MHz | 2.5 x 2 x 1
Wurth | 744043004 | 4.7 |  | 1.55 | 1.7 | 0.05 | 60 MHz | 4.8 x 4.8 x 3
Wurth | 744031150 | 15 |  | 0.45 | 0.62 | 0.255 | 30 MHz | 3.8 x 3.8 x 1.8
Wurth | 7447779122 | 22 | 120 | 1.41 | 1.7 | 0.09 | 17 MHz | 7.3 x 7.3 x 4.5
Coildcraft | XFL2010-223MR | 22 |  | 0.16 | 0.31 | 1.3 |  | 2.0 x 1.0
Coilcraft | LPS3015-223MR | 22 |  | 0.42 | 0.5 | 0.83 |  | 3.13 x 3.13 x 1.5
Coilcraft | LPS3030-223 | 22 |  | 0.42 | 0.48 | 0.31 |  | 3.15 x 3.15 x 3
Murata | LQH44PN220MPR# (https://www.murata.com/en-global/products/productdetail?partno=LQH44PN220MPR%23) | 22 |  | 0.9 | 1.05 | 0.348 |  | 4 x 4 x 1.65
Wurth | 744031220 | 22 |  | 0.36 | 0.51 | 0.41 |  | 3.8 x 3.8 x 1.8
Wurth | 744025220 | 22 |  | 0.5 | 0.75 | 0.525 |  | 2.8 x 2.8 x 2.8
Wurth | 744043220 | 22 |  | 0.7 | 0.925 | 0.16 |  | 4.8 x 4.8
