trollock/Solar_LoRa_GPS/Housings/v19_LoRa_only/version_1_open_bottom.stl

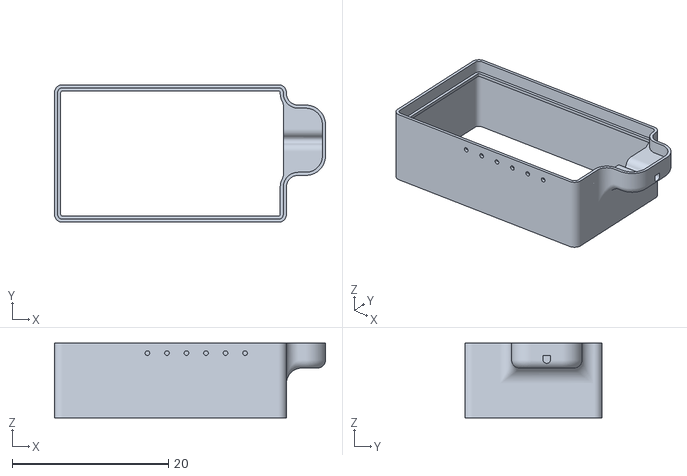
[picture p13: CAD file, 2020-12-24]
Housings/v19_LoRa_only/version_1_open_bottom.stl
34.7 x 17.6 x 9.60
