trollock/Solar_LoRa_GPS/Housings/v19_LoRa_only/version_1_programmer.stl

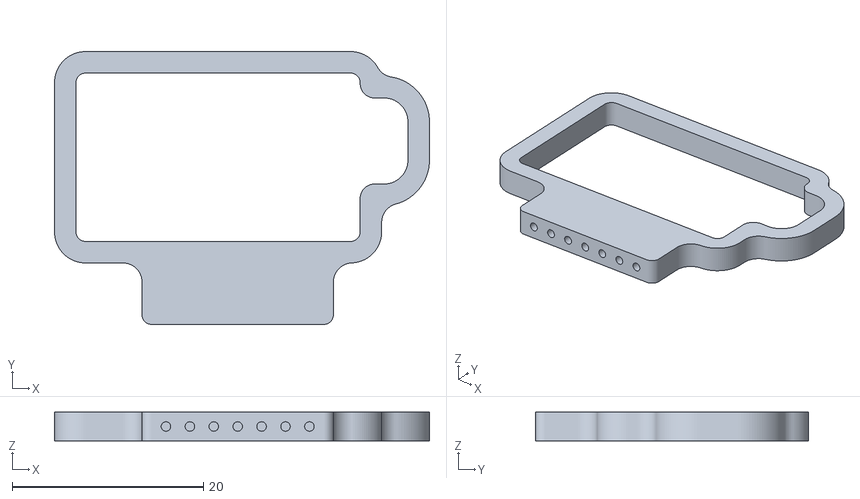
[picture p14: CAD file, 2020-12-24]
Housings/v19_LoRa_only/version_1_programmer.stl
39.2 x 28.5 x 3.00
