trollock/Solar_LoRa_GPS/(list of files, cad)

Other CAD files:
Hardware/TrisolX/TrisolX_cell.dwg
Housings/v19_LoRa_only/version_1 3.dwg
EAGLE/v27_LG77L_CMWX/GPS_radiologger_v24_L70_CMWX_MAX v2.f3z
Housings/v19_LoRa_only/version_1.dwg
