trollock/Solar_LoRa_GPS/Development Notes/GPS_QC_Jan_26_2021/GPS_test.txt

[
  {
    "device_id": "murata_test_module",
    "hdop": 2.39,
    "latitude": 47.7705015,
    "longitude": 8.9855949,
    "raw": "BVsXzRx5MzcA7wg=",
    "siv": 8,
    "time": "2021-01-25T08:23:02.060769232Z"
  },
  {
    "device_id": "murata_test_module",
    "hdop": 2.63,
    "latitude": 47.7705198,
    "longitude": 8.9855832,
    "raw": "BVsXWBx5M+4BBwc=",
    "siv": 7,
    "time": "2021-01-25T08:28:07.073191192Z"
  },
  {
    "device_id": "murata_test_module",
    "hdop": 2.56,
    "latitude": 47.7705274,
    "longitude": 8.9856088,
    "raw": "BVsYWBx5NDoBAAc=",
    "siv": 7,
    "time": "2021-01-25T08:33:12.086063853Z"
  },
  {
    "device_id": "murata_test_module",
    "hdop": 3.59,
    "latitude": 47.7704342,
    "longitude": 8.9855854,
    "raw": "BVsXbhx5MJYBZwc=",
    "siv": 7,
    "time": "2021-01-25T08:38:17.070773911Z"
  },
  {
    "device_id": "murata_test_module",
    "hdop": 2.65,
    "latitude": 47.7704691,
    "longitude": 8.9855918,
    "raw": "BVsXrhx5MfMBCQc=",
    "siv": 7,
    "time": "2021-01-25T08:43:22.068250174Z"
  },
  {
    "device_id": "murata_test_module",
    "hdop": 3.17,
    "latitude": 47.7704375,
    "longitude": 8.9856408,
    "raw": "BVsZmBx5MLcBPQc=",
    "siv": 7,
    "time": "2021-01-25T08:48:27.041974848Z"
  },
  {
    "device_id": "murata_test_module",
    "hdop": 4.62,
    "latitude": 47.7703273,
    "longitude": 8.9857387,
    "raw": "BVsdaxx5LGkBzgY=",
    "siv": 6,
    "time": "2021-01-25T08:53:32.049269046Z"
  },
  {
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
    "longitude": 8.9856252,
    "raw": "BVsY/Bx5MYYA3gk=",
    "siv": 9,
    "time": "2021-01-26T05:38:16.047244029Z"
  },
  {
    "device_id": "murata_test_module",
    "hdop": 2.28,
    "latitude": 47.7704348,
    "longitude": 8.9856179,
    "raw": "BVsYsxx5MJwA5Ak=",
    "siv": 9,
    "time": "2021-01-26T05:43:21.010497574Z"
  },
  {
    "device_id": "murata_test_module",
    "hdop": 3.15,
    "latitude": 47.7704699,
    "longitude": 8.9856161,
    "raw": "BVsYoRx5MfsBOwc=",
    "siv": 7,
    "time": "2021-01-26T05:48:26.091151164Z"
  },
  {
    "device_id": "murata_test_module",
    "hdop": 3.12,
    "latitude": 47.7704146,
    "longitude": 8.9856289,
    "raw": "BVsZIRx5L9IBOAc=",
    "siv": 7,
    "time": "2021-01-26T05:53:31.062152738Z"
  },
  {
    "device_id": "murata_test_module",
    "hdop": 1.97,
    "latitude": 47.7705068,
    "longitude": 8.9856193,
    "raw": "BVsYwRx5M2wAxQk=",
    "siv": 9,
    "time": "2021-01-26T05:58:36.025330966Z"
  },
  {
    "device_id": "murata_test_module",
    "hdop": 2.99,
    "latitude": 47.7703814,
    "longitude": 8.9856387,
    "raw": "BVsZgxx5LoYBKwY=",
    "siv": 6,
    "time": "2021-01-26T06:03:41.013134444Z"
  },
  {
    "device_id": "murata_test_module",
    "hdop": 2.22,
    "latitude": 47.7704939,
    "longitude": 8.9855948,
    "raw": "BVsXzBx5MusA3gg=",
    "siv": 8,
    "time": "2021-01-26T06:08:46.01630458Z"
  }
]
