trollock/Solar_LoRa_GPS/RF_Range_Test_Data/fifth_test.txt

SparkFun Ublox Example
Lat: 0 Long: 0 Alt: 0 (mm) SIV: 0 Timestamp: 2015:10:18:0:0:5
Lat: 0 Long: 0 Alt: 0 (mm) SIV: 0 Timestamp: 2015:10:18:0:0:7
Lat: 0 Long: 0 Alt: 0 (mm) SIV: 0 Timestamp: 2015:10:19:13:33:14
Lat: 0 Long: 0 Alt: 0 (mm) SIV: 0 Timestamp: 2015:10:19:13:33:17
Lat: 0 Long: 0 Alt: 0 (mm) SIV: 0 Timestamp: 2015:10:19:13:33:18
Lat: 0 Long: 0 Alt: 0 (mm) SIV: 0 Timestamp: 2019:7:1:13:33:21
Lat: 0 Long: 0 Alt: 0 (mm) SIV: 0 Timestamp: 2019:7:1:13:33:22
Lat: 0 Long: 0 Alt: 0 (mm) SIV: 0 Timestamp: 2019:7:1:13:33:25
Lat: 0 Long: 0 Alt: 0 (mm) SIV: 0 Timestamp: 2019:7:1:13:33:26
Lat: 0 Long: 0 Alt: 0 (mm) SIV: 0 Timestamp: 2019:7:1:13:33:29
Lat: 0 Long: 0 Alt: 0 (mm) SIV: 0 Timestamp: 2019:7:1:13:33:30
Lat: 0 Long: 0 Alt: 0 (mm) SIV: 0 Timestamp: 2019:7:1:13:33:33
Lat: 0 Long: 0 Alt: 0 (mm) SIV: 0 Timestamp: 2019:7:1:13:33:34
Lat: 0 Long: 0 Alt: 0 (mm) SIV: 0 Timestamp: 2019:7:1:13:33:37
Lat: 0 Long: 0 Alt: 0 (mm) SIV: 0 Timestamp: 2019:7:1:13:33:38
Lat: 0 Long: 0 Alt: 0 (mm) SIV: 0 Timestamp: 2019:7:1:13:33:39
Lat: 0 Long: 0 Alt: 0 (mm) SIV: 0 Timestamp: 2019:7:1:13:33:41
Lat: 0 Long: 0 Alt: 0 (mm) SIV: 0 Timestamp: 2019:7:1:13:33:43
Lat: 0 Long: 0 Alt: 0 (mm) SIV: 0 Timestamp: 2019:7:1:13:33:45
Lat: 0 Long: 0 Alt: 0 (mm) SIV: 0 Timestamp: 2019:7:1:13:33:47
Lat: 0 Long: 0 Alt: 0 (mm) SIV: 0 Timestamp: 2019:7:1:13:33:49
Lat: 0 Long: 0 Alt: 0 (mm) SIV: 0 Timestamp: 2019:7:1:13:33:51
Lat: 0 Long: 0 Alt: 0 (mm) SIV: 0 Timestamp: 2019:7:1:13:33:53
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
Lat: 477708857 Long: 89851446 Alt: 514556 (mm) SIV: 6 Timestamp: 2019:7:1:14:54:1
Lat: 477709061 Long: 89851074 Alt: 514439 (mm) SIV: 6 Timestamp: 2019:7:1:14:54:3
Lat: 477709073 Long: 89851062 Alt: 514702 (mm) SIV: 6 Timestamp: 2019:7:1:14:54:5
Lat: 477709060 Long: 89851028 Alt: 515008 (mm) SIV: 6 Timestamp: 2019:7:1:14:54:7
Lat: 477708880 Long: 89851262 Alt: 514569 (mm) SIV: 6 Timestamp: 2019:7:1:14:54:9
Lat: 477708667 Long: 89851603 Alt: 514489 (mm) SIV: 6 Timestamp: 2019:7:1:14:54:11
Lat: 477708599 Long: 89851639 Alt: 513646 (mm) SIV: 6 Timestamp: 2019:7:1:14:54:13
Lat: 477708609 Long: 89851730 Alt: 513289 (mm) SIV: 6 Timestamp: 2019:7:1:14:54:15
Lat: 477708473 Long: 89851815 Alt: 513419 (mm) SIV: 6 Timestamp: 2019:7:1:14:54:17
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
