trollock/Solar_LoRa_GPS/RF_Range_Test_Data/fist_test.txt

Latitude (deg): 47.770420
Longitude (deg): 8.985527
Latitude (deg): 47.770420
Longitude (deg): 8.985527
Latitude (deg): 47.770420
Longitude (deg): 8.985527
Latitude (deg): 47.770420
Longitude (deg): 8.985527
Latitude (deg): 47.770424
Longitude (deg): 8.985530
Latitude (deg): 47.770424
Longitude (deg): 8.985530
Latitude (deg): 47.770424
Longitude (deg): 8.985530
Latitude (deg): 47.770424
Longitude (deg): 8.985530
Latitude (deg): 47.770441
Longitude (deg): 8.985546
Latitude (deg): 47.770441
Longitude (deg): 8.985546
Latitude (deg): 47.770441
Longitude (deg): 8.985546
Latitude (deg): 47.770455
Longitude (deg): 8.985540
Latitude (deg): 47.770455
Longitude (deg): 8.985540
Latitude (deg): 47.770455
Longitude (deg): 8.985540
Latitude (deg): 47.770455
Longitude (deg): 8.985540
Latitude (deg): 47.770456
Longitude (deg): 8.985558
Latitude (deg): 47.770456
Longitude (deg): 8.985558
Latitude (deg): 47.770456
Longitude (deg): 8.985558
Latitude (deg): 47.770456
Longitude (deg): 8.985558
Latitude (deg): 47.770455
Longitude (deg): 8.985575
Latitude (deg): 47.770455
Longitude (deg): 8.985575
Latitude (deg): 47.770455
Longitude (deg): 8.985575
Latitude (deg): 47.770455
Longitude (deg): 8.985575
Latitude (deg): 47.770461
Longitude (deg): 8.985599
Latitude (deg): 47.770461
Longitude (deg): 8.985599
Latitude (deg): 47.770461
Longitude (deg): 8.985599
Latitude (deg): 47.770461
Longitude (deg): 8.985599
Latitude (deg): 47.770463
Longitude (deg): 8.985624
Latitude (deg): 47.770463
Longitude (deg): 8.985624
Latitude (deg): 47.770463
Longitude (deg): 8.985624
Latitude (deg): 47.770467
Longitude (deg): 8.985656
Latitude (deg): 47.770467
Longitude (deg): 8.985656
Latitude (deg): 47.770467
Longitude (deg): 8.985656
Latitude (deg): 47.770467
Longitude (deg): 8.985656
Latitude (deg): 47.770468
Longitude (deg): 8.985681
Latitude (deg): 47.770468
Longitude (deg): 8.985681
Latitude (deg): 47.770468
Longitude (deg): 8.985681
Latitude (deg): 47.770468
Longitude (deg): 8.985681
Latitude (deg): 47.770474
Longitude (deg): 8.985700
Latitude (deg): 47.770474
Longitude (deg): 8.985700
Latitude (deg): 47.770474
Longitude (deg): 8.985700
Latitude (deg): 47.770474
Longitude (deg): 8.985700
Latitude (deg): 47.770454
Longitude (deg): 8.985725
Latitude (deg): 47.770454
Longitude (deg): 8.985725
Latitude (deg): 47.770454
Longitude (deg): 8.985725
Latitude (deg): 47.770443
Longitude (deg): 8.985743
Latitude (deg): 47.770443
Longitude (deg): 8.985743
Latitude (deg): 47.770443
Longitude (deg): 8.985743
Latitude (deg): 47.770443
Longitude (deg): 8.985743
Latitude (deg): 47.770432
Longitude (deg): 8.985762
Latitude (deg): 47.770432
Longitude (deg): 8.985762
Latitude (deg): 47.770432
Longitude (deg): 8.985762
Latitude (deg): 47.770432
Longitude (deg): 8.985762
Latitude (deg): 47.770431
Longitude (deg): 8.985767
Latitude (deg): 47.770431
Longitude (deg): 8.985767
