trollock/Solar_LoRa_GPS/RF_Range_Test_Data/fourth_test.txt

SparkFun Ublox Example
Lat: 477707787 Long: 89853921 Alt: 475872 (mm) SIV: 0 Timestamp: 2019:7:1:10:20:52
Lat: 477707787 Long: 89853921 Alt: 475872 (mm) SIV: 0 Timestamp: 2019:7:1:10:20:53
Lat: 477707787 Long: 89853921 Alt: 475872 (mm) SIV: 0 Timestamp: 2019:7:1:10:20:54
Lat: 477707787 Long: 89853921 Alt: 475872 (mm) SIV: 0 Timestamp: 2019:7:1:10:20:55
Lat: 477707787 Long: 89853921 Alt: 475872 (mm) SIV: 0 Timestamp: 2019:7:1:10:20:56
Lat: 477707787 Long: 89853921 Alt: 475872 (mm) SIV: 0 Timestamp: 2019:7:1:10:20:57
Lat: 477707787 Long: 89853921 Alt: 475872 (mm) SIV: 0 Timestamp: 2019:7:1:10:20:58
Lat: 477707787 Long: 89853921 Alt: 475872 (mm) SIV: 0 Timestamp: 2019:7:1:10:20:59
Lat: 477707787 Long: 89853921 Alt: 475872 (mm) SIV: 0 Timestamp: 2019:7:1:10:21:0
Lat: 477707787 Long: 89853921 Alt: 475872 (mm) SIV: 0 Timestamp: 2019:7:1:10:21:1
Lat: 477707787 Long: 89853921 Alt: 475872 (mm) SIV: 0 Timestamp: 2019:7:1:10:21:2
Lat: 477707787 Long: 89853921 Alt: 475872 (mm) SIV: 0 Timestamp: 2019:7:1:10:21:3
Lat: 477707787 Long: 89853921 Alt: 475872 (mm) SIV: 0 Timestamp: 2019:7:1:10:21:4
Lat: 477707787 Long: 89853921 Alt: 475872 (mm) SIV: 0 Timestamp: 2019:7:1:10:21:5
Lat: 477707787 Long: 89853921 Alt: 475872 (mm) SIV: 0 Timestamp: 2019:7:1:10:21:6
Lat: 477707787 Long: 89853921 Alt: 475872 (mm) SIV: 0 Timestamp: 2019:7:1:10:21:7
Lat: 477707787 Long: 89853921 Alt: 475872 (mm) SIV: 0 Timestamp: 2019:7:1:10:21:8
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
Lat: 477703703 Long: 89854033 Alt: 437842 (mm) SIV: 5 Timestamp: 2019:7:1:10:29:13
Lat: 477703454 Long: 89853796 Alt: 438883 (mm) SIV: 5 Timestamp: 2019:7:1:10:29:14
Lat: 477703491 Long: 89853797 Alt: 439193 (mm) SIV: 5 Timestamp: 2019:7:1:10:29:15
Lat: 477703486 Long: 89853874 Alt: 439705 (mm) SIV: 5 Timestamp: 2019:7:1:10:29:16
Lat: 477703306 Long: 89853868 Alt: 439950 (mm) SIV: 5 Timestamp: 2019:7:1:10:29:17
Lat: 477703225 Long: 89853887 Alt: 440137 (mm) SIV: 5 Timestamp: 2019:7:1:10:29:18
Lat: 477703163 Long: 89853920 Alt: 441175 (mm) SIV: 5 Timestamp: 2019:7:1:10:29:19
Lat: 477703183 Long: 89853947 Alt: 441807 (mm) SIV: 5 Timestamp: 2019:7:1:10:29:20
Lat: 477703136 Long: 89853948 Alt: 442567 (mm) SIV: 5 Timestamp: 2019:7:1:10:29:21
Lat: 477703018 Long: 89853869 Alt: 443156 (mm) SIV: 5 Timestamp: 2019:7:1:10:29:22
Lat: 477702987 Long: 89853826 Alt: 443018 (mm) SIV: 5 Timestamp: 2019:7:1:10:29:23
Lat: 477702970 Long: 89853870 Alt: 443021 (mm) SIV: 5 Timestamp: 2019:7:1:10:29:24
Lat: 477703084 Long: 89853893 Alt: 442604 (mm) SIV: 6 Timestamp: 2019:7:1:10:29:25
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
