trollock/Solar_LoRa_GPS/Development Notes/Initial_CC1350_Launchpad_Energia_changes.docx

Modifications to Energia Files to compile 433 MhZ CC1350 Launchpad

Initialize the RF switch in the Board.h and Board_init.h files located at

- ‎Macintosh_HD/Users/ryanshipley/Library/Energia15/packages/energia/hardware/cc13xx/4.9.1/variants/LAUNCHXL_CC1350

CC1350 (http://www.ti.com/product/CC1350)_LAUNCHXL_DIO1_RFSW | PIN_GPIO_OUTPUT_EN | PIN_GPIO_HIGH | PIN_PUSHPULL | PIN_DRVSTR_MAX, /* RF SW Switch defaults to sub-1GHz path*/
CC1350 (http://www.ti.com/product/CC1350)_LAUNCHXL_DIO30_SWPWR | PIN_GPIO_OUTPUT_EN | PIN_GPIO_HIGH | PIN_PUSHPULL | PIN_DRVSTR_MAX, /* External RF Switch is powered on by default */

by adding the following to the Boards_init.c file (in green)

const PIN_Config BoardGpioInitTable[] = {

Board_RLED | PIN_GPIO_OUTPUT_EN | PIN_GPIO_LOW | PIN_PUSHPULL | PIN_DRVSTR_MAX, /* LED initially off */

Board_GLED | PIN_GPIO_OUTPUT_EN | PIN_GPIO_LOW | PIN_PUSHPULL | PIN_DRVSTR_MAX, /* LED initially off */

Board_BTN1 | PIN_INPUT_EN | PIN_PULLUP | PIN_IRQ_BOTHEDGES | PIN_HYSTERESIS, /* Button is active low */

Board_BTN2 | PIN_INPUT_EN | PIN_PULLUP | PIN_IRQ_BOTHEDGES | PIN_HYSTERESIS, /* Button is active low */

Board_UART_RX | PIN_INPUT_EN | PIN_PULLDOWN, /* UART RX via debugger back channel */

Board_UART_TX | PIN_GPIO_OUTPUT_EN | PIN_GPIO_HIGH | PIN_PUSHPULL, /* UART TX via debugger back channel */

Board_SPI0_MOSI | PIN_INPUT_EN | PIN_PULLDOWN, /* SPI master out - slave in */

Board_SPI0_MISO | PIN_INPUT_EN | PIN_PULLDOWN, /* SPI master in - slave out */

Board_SPI0_CLK | PIN_INPUT_EN | PIN_PULLDOWN,

CC1350_LAUNCHXL_DIO1_ANALOG | PIN_GPIO_OUTPUT_EN | PIN_GPIO_HIGH | PIN_PUSHPULL | PIN_DRVSTR_MAX, /* RF SW Switch defaults to sub-1GHz path*/

CC1350_LAUNCHXL_DIO30_ANALOG | PIN_GPIO_OUTPUT_EN | PIN_GPIO_HIGH | PIN_PUSHPULL | PIN_DRVSTR_MAX, /* External RF Switch is powered on by default */ /* SPI clock */

PIN_TERMINATE

}

and the following to the Board.h file under the pin mapping –

/* Radio Switch Pins */

#define CC1350_LAUNCHXL_DIO1_ANALOG IOID_1

I also modified the EasyLink files in the ‘EasyLink’ library for 433 MhZ.

Describe those changes here.

Also need to add

CCFG_FORCE_VDDR_HH = 1 in the ccfg.c file.

to program for 14 dB output power
