trollock/Solar_LoRa_GPS/Hardware/MCUs/Atmel_SAMD21G18E/SparkFun_Qwiic_Micro-SAMD21_Schematic.pdf

## ATSAMD21E18A-U ¹²³⁴

# SHIELD*10 1234567 12

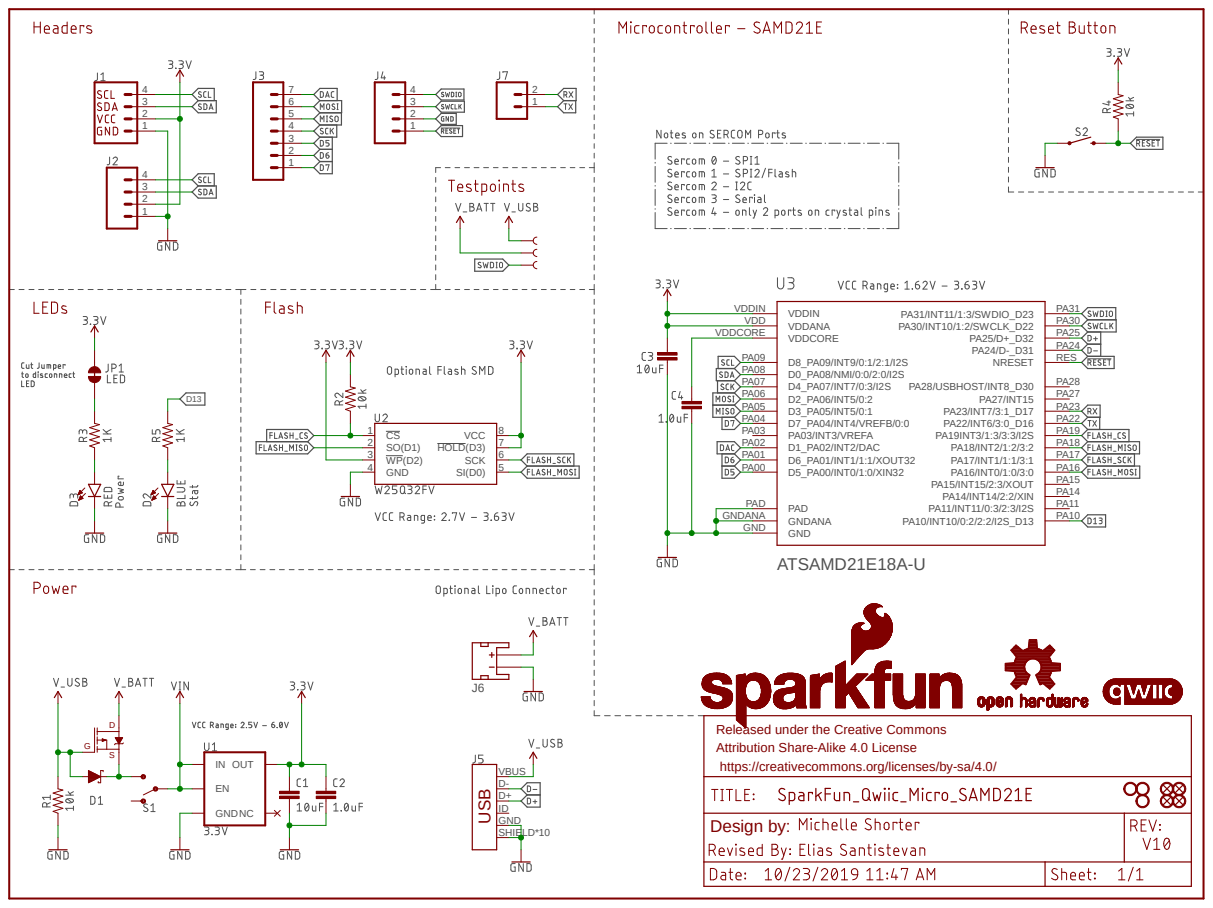
[picture p15: page 1]
D+D- VBUS GND; INGNDOUT EN; HOLD(D3) 7 WP(D2) 3 GND 4; SCK 6 SI(D0) 5 SO(D1) 2; VCC 8 1234; D5_PA00/INT0/1:0/XIN32 PA00; D6_PA01/INT1/1:1/XOUT32 PA01; D1_PA02/INT2/DAC PA02; PA03/INT3/VREFA PA03; D7_PA04/INT4/VREFB/0:0 PA04; D3_PA05/INT5/0:1 PA05; D2_PA06/INT5/0:2 PA06; D4_PA07/INT7/0:3/I2S PA07; D0_PA08/NMI/0:0/2:0/I2S PA08; D8_PA09/INT9/0:1/2:1/I2S PA09; NRESET; RES GNDANA GNDANA; GND GND; VDDANA VDD; VDDIN VDDIN; VDDCORE VDDCORE; PA10/INT10/0:2/2:2/I2S_D13; PA10 PA11/INT11/0:3/2:3/I2S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

Design by: DS G

Released under the Creative Commons
Attribution Share-Alike 4.0 License
https://creativecommons.org/licenses/by-sa/4.0/
