trollock/Solar_LoRa_GPS/Hardware/MCUs/Texas_Instruments_cc1310/swrc320a/LAUNCHXL-CC1350_1_3_Assy.pdf

## ART FILM - assembly_top

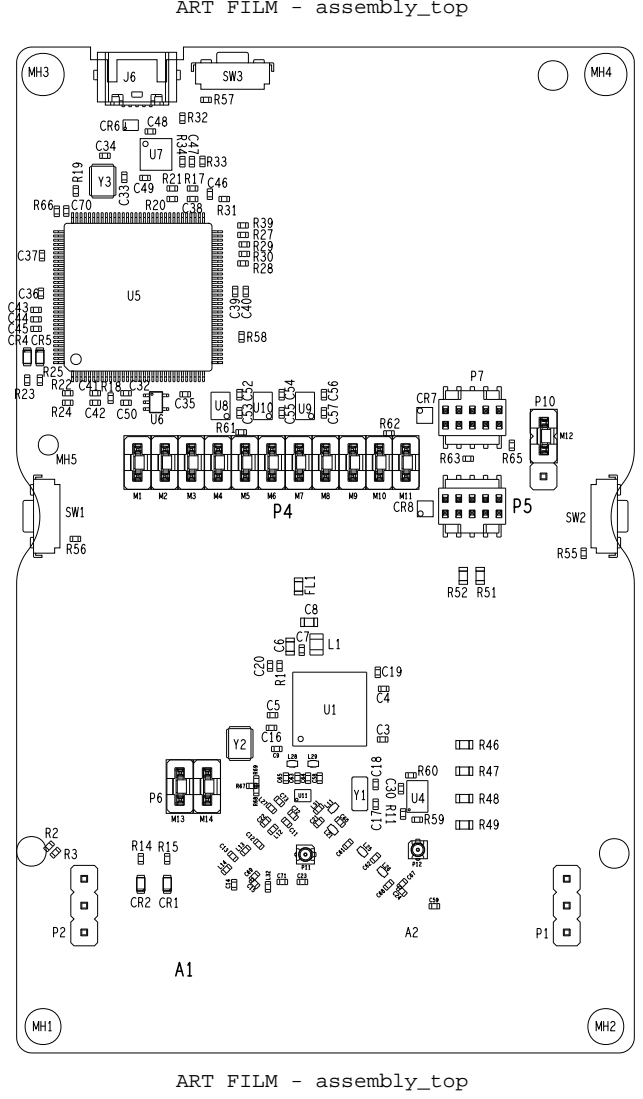
[picture p16: page 1]

## ART FILM - assembly_bottom_mirrored

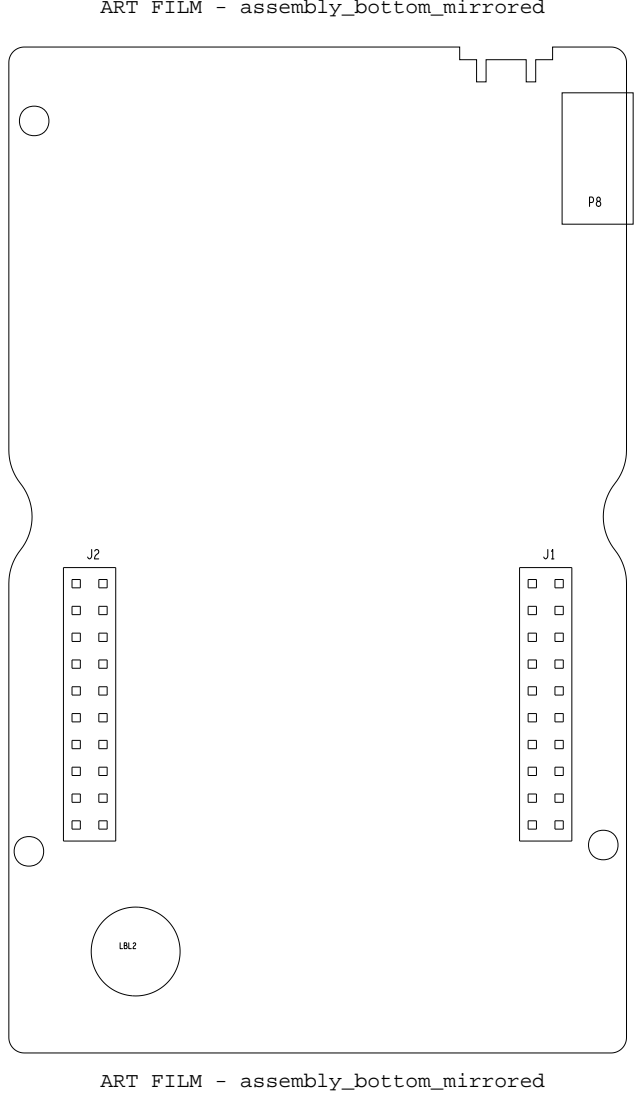
[picture p17: page 2]
ART FILM - assembly_bottom_mirrored; LBL2
