trollock/Solar_LoRa_GPS/Hardware/MCUs/Texas_Instruments_cc1310/swrc320a/PCB/LAUNCHXL-CC1350_1_3_Mech.pdf

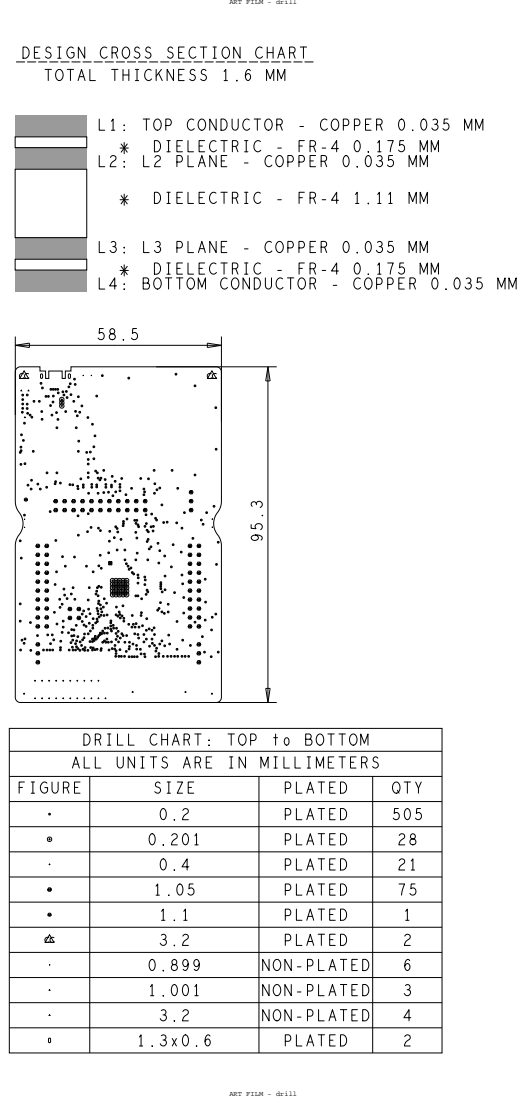
[picture p18: page 1]
QTY; PLATED; NON-PLATED; SIZE; ALL UNITS ARE IN MILLIMETERS; DRILL CHART: TOP to BOTTOM; FIGURE

ART FILM - drill

___________________________ DESIGN CROSS SECTION CHART
TOTAL THICKNESS 1.6 MM
L1: TOP CONDUCTOR - COPPER 0.035 MM
* DIELECTRIC - FR-4 0.175 MM
L2: L2 PLANE - COPPER 0.035 MM
* DIELECTRIC - FR-4 1.11 MM
L3: L3 PLANE - COPPER 0.035 MM
L4: BOTTOM CONDUCTOR - COPPER 0.035 MM
