trollock/Solar_LoRa_GPS/Hardware/RF/Semtech_SX1276/inair9_r1_sch.pdf

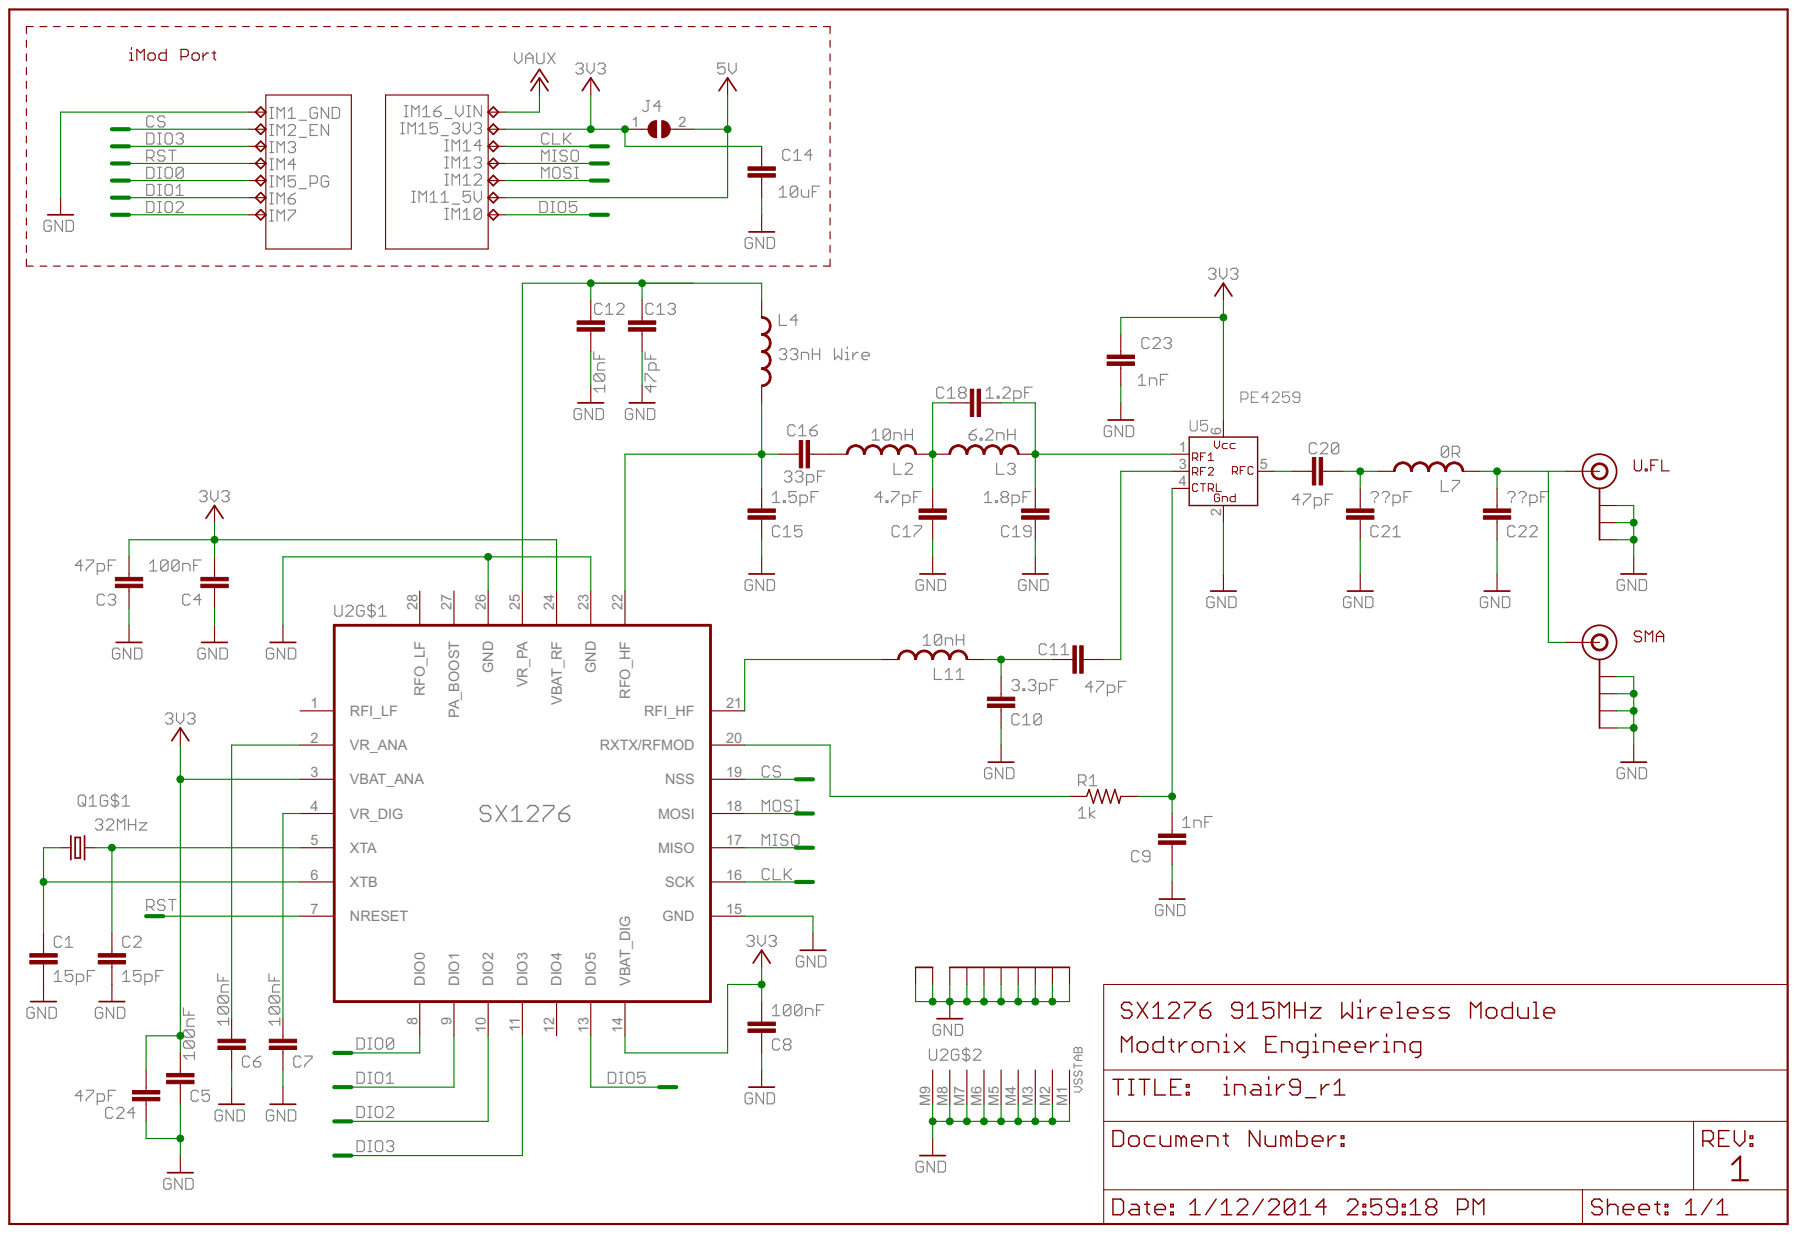
[picture p19: page 1]
