trollock/Solar_LoRa_GPS/(list of files, drawings)

Other design files:
Hardware/MCUs/Texas_Instruments_cc1310/swrc320a/Cadence/LAUNCHXL-CC1350.DSN
Hardware/MCUs/Texas_Instruments_cc1310/swrc320a/Cadence/launchxl-cc1350.opj
