trollock/Solar_LoRa_GPS/EAGLE/v24_2_CMWX_L70_MAX/GPS_radiologger_v24_L70_CMWX_MAX.brd

## EAGLE design EAGLE/v24_2_CMWX_L70_MAX/GPS_radiologger_v24_L70_CMWX_MAX.brd (2023-01-23)

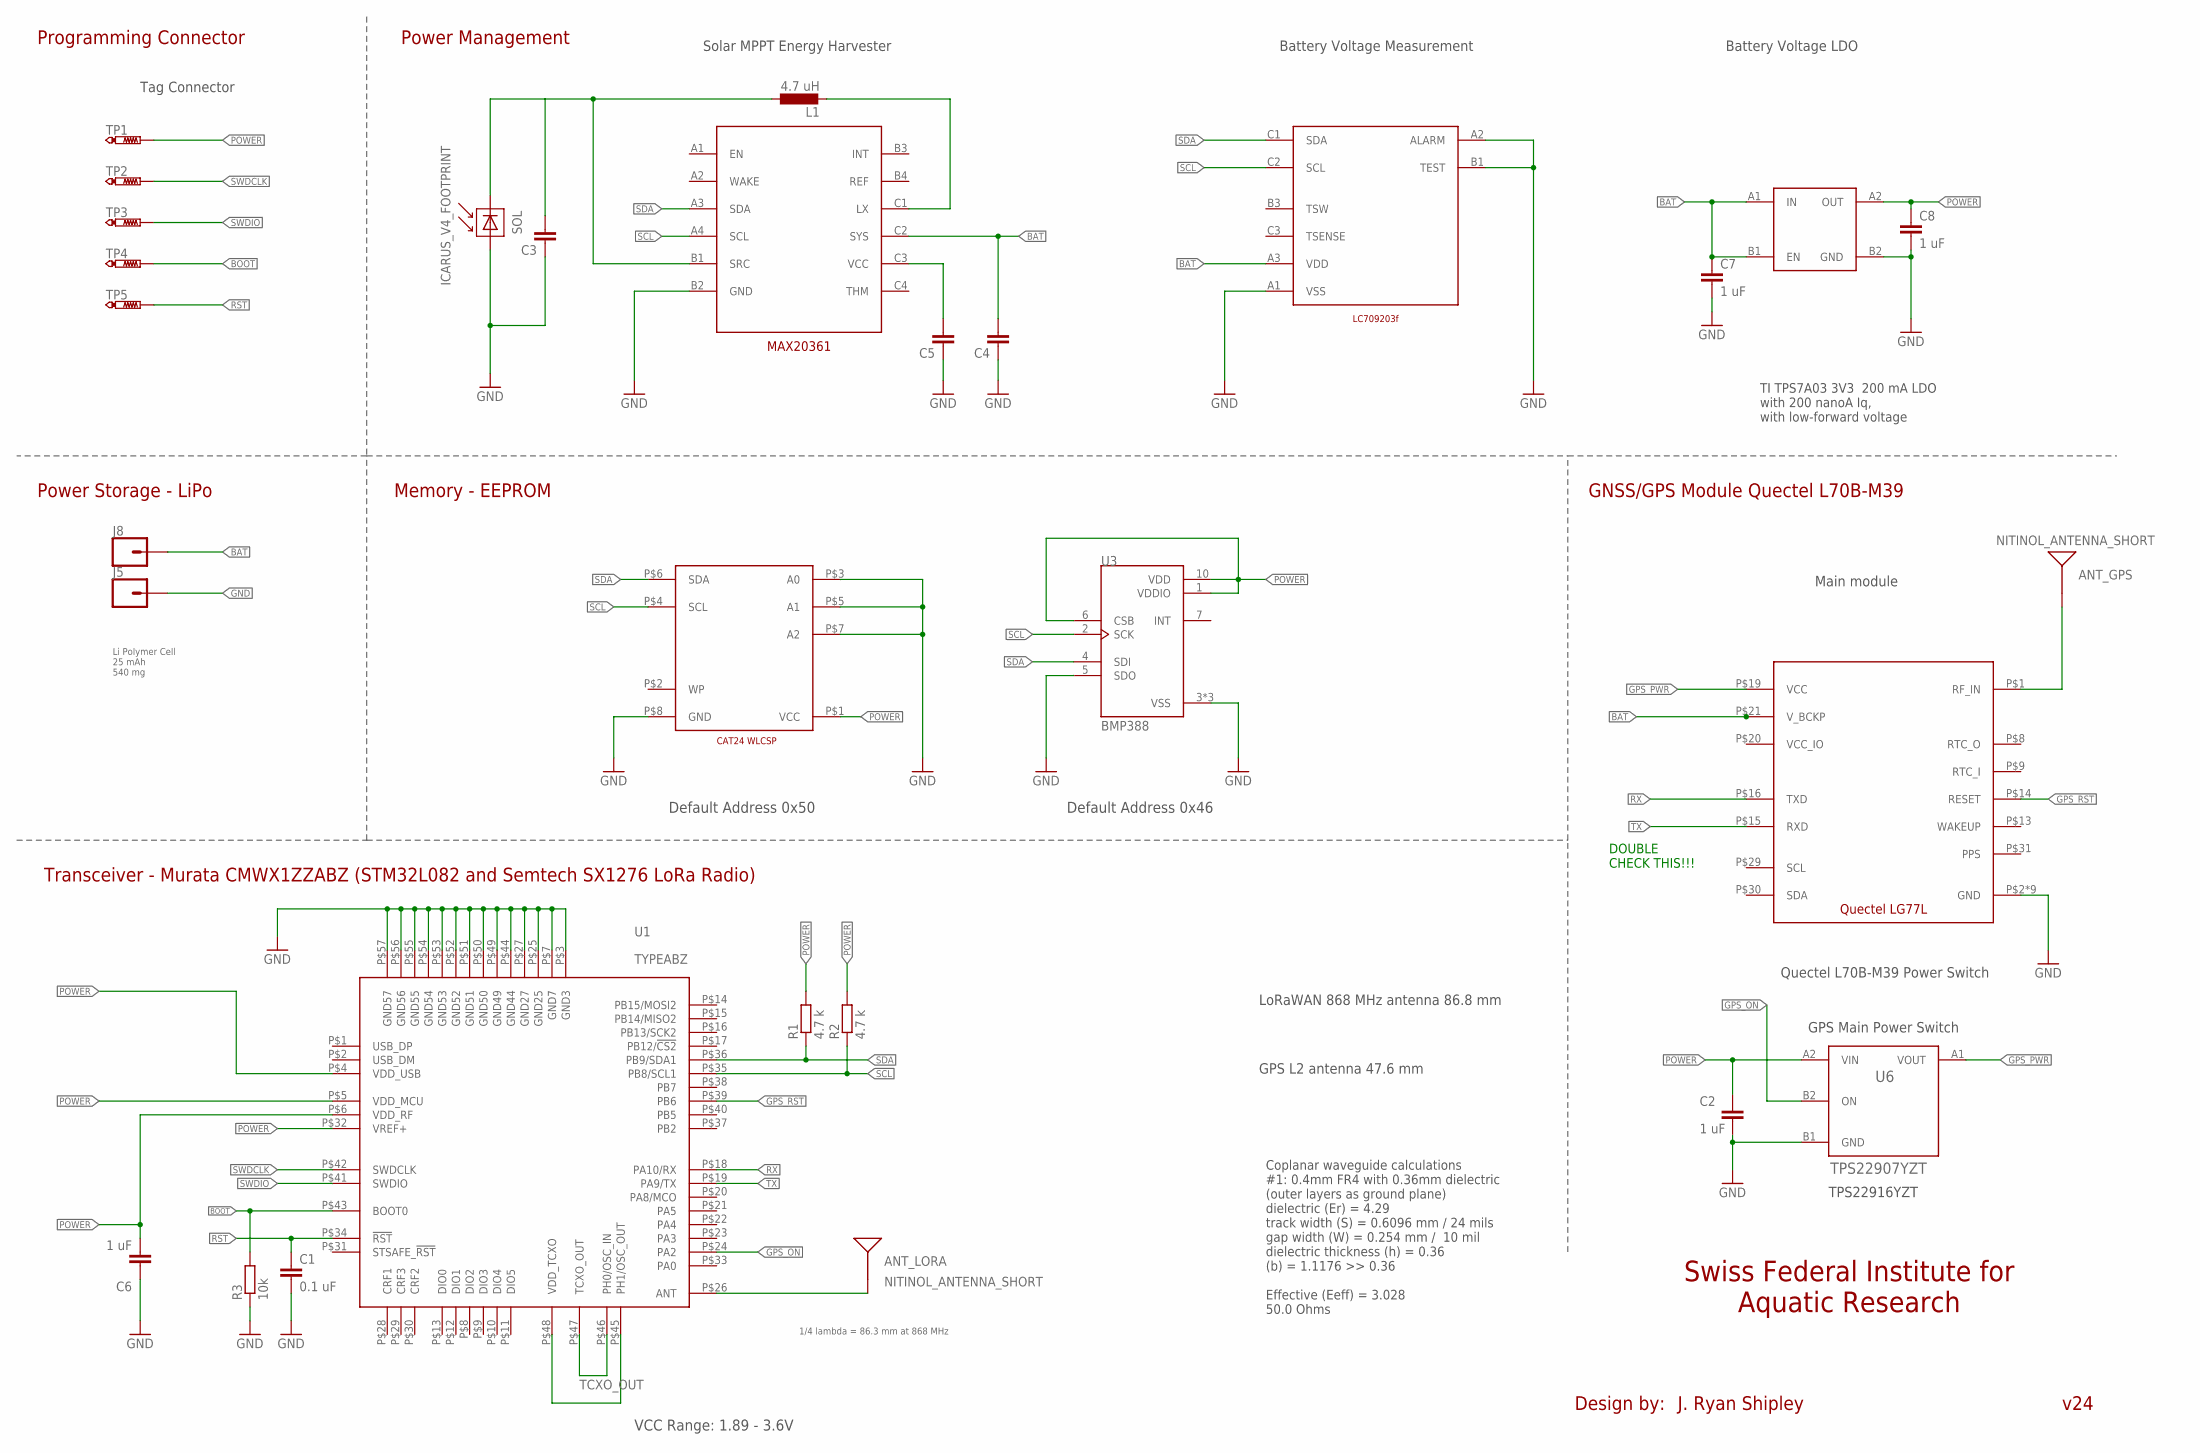
[picture p20: schematic GPS_radiologger_v24_L70_CMWX_MAX.sch]

Parts:
ANT_GPS: NITINOL_ANTENNA_SHORT; ICARUS_NITINOL_ANTENNA_SHORT
ANT_LORA: NITINOL_ANTENNA_SHORT; ICARUS_NITINOL_ANTENNA_SHORT
C1: 0.1 uF; C0201
C2, C6: 1 uF; C0201
C3: 10UF; 0603-TIGHT
C4, C5: 1.0UF; 0402-TIGHTER
C7, C8: 1 uF; 0402-CAP
J5, J8: CONN_01PTH_NO_SILK_SMALL; 1X01_SMALL
L1: 4.7 uH; INDC2016X120L
R1, R2: 4.7 k; R0201
R3: 10k; R0201
SOL: ICARUS_V4_FOOTPRINT; ICARUS_FULL_FOOTPRINT
TP1, TP2, TP3, TP4, TP5: PTR1TP08SQ; TP08SQ
U1: TYPEABZ
U3: BMP388; PQFN50P200X200X80-10N
U4: TPS7A03-DSBGA; BGA4N35P2X2_70X70X40N
U5: LC709203F; BGA9N50P3X3_160X175X50N
U6: TPS22907YZT; YFP0004-DSBGA
U7: CAT24_WLCSP8; WLCSP8
U8: MAX20361; BGA12N40P4X3_123X163X64N
U$1: LG77L

Connections:
BAT: C4.P$2 (2), C7.1, J8.P$1, U4.A1 (IN), U4.B1 (EN), U5.A3 (VDD), U8.C2 (SYS), U$1.P$21 (V_BCKP)
BOOT: R3.2, TP4.TP, U1.P$43 (BOOT0)
GND: C1.2, C2.2, C3.P$1 (1), C4.P$1 (1), C5.P$1 (1), C6.1, C7.2, C8.2, J5.P$1, R3.1, SOL.P$2 (MINUS), U1.P$3 (GND3), U1.P$7 (GND7), U1.P$25 (GND25), U1.P$27 (GND27), U1.P$44 (GND44), U1.P$49 (GND49), U1.P$50 (GND50), U1.P$51 (GND51), U1.P$52 (GND52), U1.P$53 (GND53), U1.P$54 (GND54), U1.P$55 (GND55), U1.P$56 (GND56), U1.P$57 (GND57), U3.3 (VSS), U3.5 (SDO), U3.8 (VSS), U3.9 (VSS), U4.B2 (GND), U5.A1 (VSS), U5.A2 (ALARM), U5.B1 (TEST), U6.B1 (GND), U7.P$3 (A0), U7.P$5 (A1), U7.P$7 (A2), U7.P$8 (GND), U8.B2 (GND), U$1.P$2 (GND), U$1.P$18 (GND), U$1.P$37 (GND), U$1.P$38 (GND), U$1.P$39 (GND), U$1.P$40 (GND), U$1.P$41 (GND), U$1.P$42 (GND), U$1.P$43 (GND)
GPS_ON: U1.P$24 (PA2), U6.B2 (ON)
GPS_PWR: U6.A1 (VOUT), U$1.P$19 (VCC)
GPS_RST: U1.P$39 (PB6), U$1.P$14 (RESET)
unnamed: U1.P$45 (PH1/OSC_OUT), U1.P$48 (VDD_TCXO)
unnamed: ANT_GPS.1, ANT_GPS.2, ANT_GPS.3, U$1.P$1 (RF_IN)
unnamed: L1.2, U8.C1 (LX)
unnamed: C5.P$2 (2), U8.C3 (VCC)
unnamed: ANT_LORA.1, ANT_LORA.2, ANT_LORA.3, U1.P$26 (ANT)
unnamed: C3.P$2 (2), L1.1, SOL.P$1 (PLUS), U8.B1 (SRC)
POWER: C2.1, C6.2, C8.1, R1.2, R2.2, TP1.TP, U1.P$4 (VDD_USB), U1.P$5 (VDD_MCU), U1.P$6 (VDD_RF), U1.P$32 (VREF+), U3.1 (VDDIO), U3.6 (CSB), U3.10 (VDD), U4.A2 (OUT), U6.A2 (VIN), U7.P$1 (VCC)
RST: C1.1, TP5.TP, U1.P$34 (!RST)
RX: U1.P$18 (PA10/RX), U$1.P$16 (TXD)
SCL: R2.1, U1.P$35 (PB8/SCL1), U3.2 (SCK), U5.C2 (SCL), U7.P$4 (SCL), U8.A4 (SCL)
SDA: R1.1, U1.P$36 (PB9/SDA1), U3.4 (SDI), U5.C1 (SDA), U7.P$6 (SDA), U8.A3 (SDA)
SWDCLK: TP2.TP, U1.P$42 (SWDCLK)
SWDIO: TP3.TP, U1.P$41 (SWDIO)
TCXO_OUT: U1.P$46 (PH0/OSC_IN), U1.P$47 (TCXO_OUT)
TX: U1.P$19 (PA9/TX), U$1.P$15 (RXD)

Notes on the sheet:
GNSS/GPS Module Quectel L70B-M39
VCC Range: 1.89 - 3.6V
Swiss Federal Institute for Aquatic Research
Transceiver - Murata CMWX1ZZABZ (STM32L082 and Semtech SX1276 LoRa Radio)
Programming Connector
Power Storage - LiPo
Design by:
J. Ryan Shipley
v24
Li Polymer Cell 25 mAh 540 mg
Power Management
Solar MPPT Energy Harvester
Memory - EEPROM
Main module
Coplanar waveguide calculations #1: 0.4mm FR4 with 0.36mm dielectric (outer layers as ground plane) dielectric (Er) = 4.29 track width (S) = 0.6096 mm / 24 mils gap width (W) = 0.254 mm / 10 mil dielectric thickness (h) = 0.36 (b) = 1.1176 >> 0.36 Effective (Eeff) = 3.028 50.0 Ohms
Tag Connector
Default Address 0x50
1/4 lambda = 86.3 mm at 868 MHz
GPS Main Power Switch
TI TPS7A03 3V3 200 mA LDO with 200 nanoA Iq, with low-forward voltage
Quectel L70B-M39 Power Switch
Battery Voltage Measurement
Battery Voltage LDO
Default Address 0x46
TPS22916YZT
GPS L2 antenna 47.6 mm
LoRaWAN 868 MHz antenna 86.8 mm
DOUBLE CHECK THIS!!!

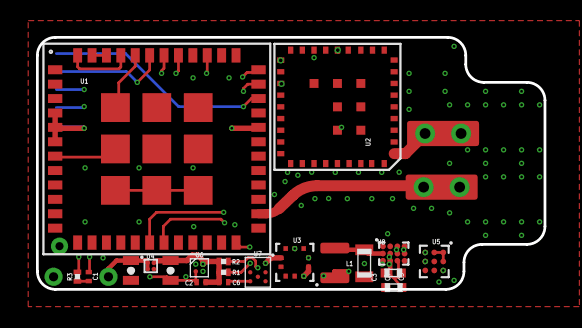
[picture p21: board GPS_radiologger_v24_L70_CMWX_MAX.brd from above]

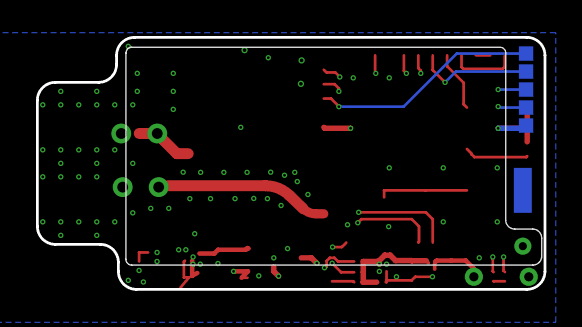
[picture p22: board GPS_radiologger_v24_L70_CMWX_MAX.brd from below]

Board: 4 copper layers, 28.2 x 14.0 mm, 30 parts (7 on the bottom side), 21 nets.
