trollock/Solar_LoRa_GPS/EAGLE/v20_CAM_M8Q/GPS_radiologger_v20_CAM_M8Q_Programmer.brd

## EAGLE design EAGLE/v20_CAM_M8Q/GPS_radiologger_v20_CAM_M8Q_Programmer.brd (2023-01-23)

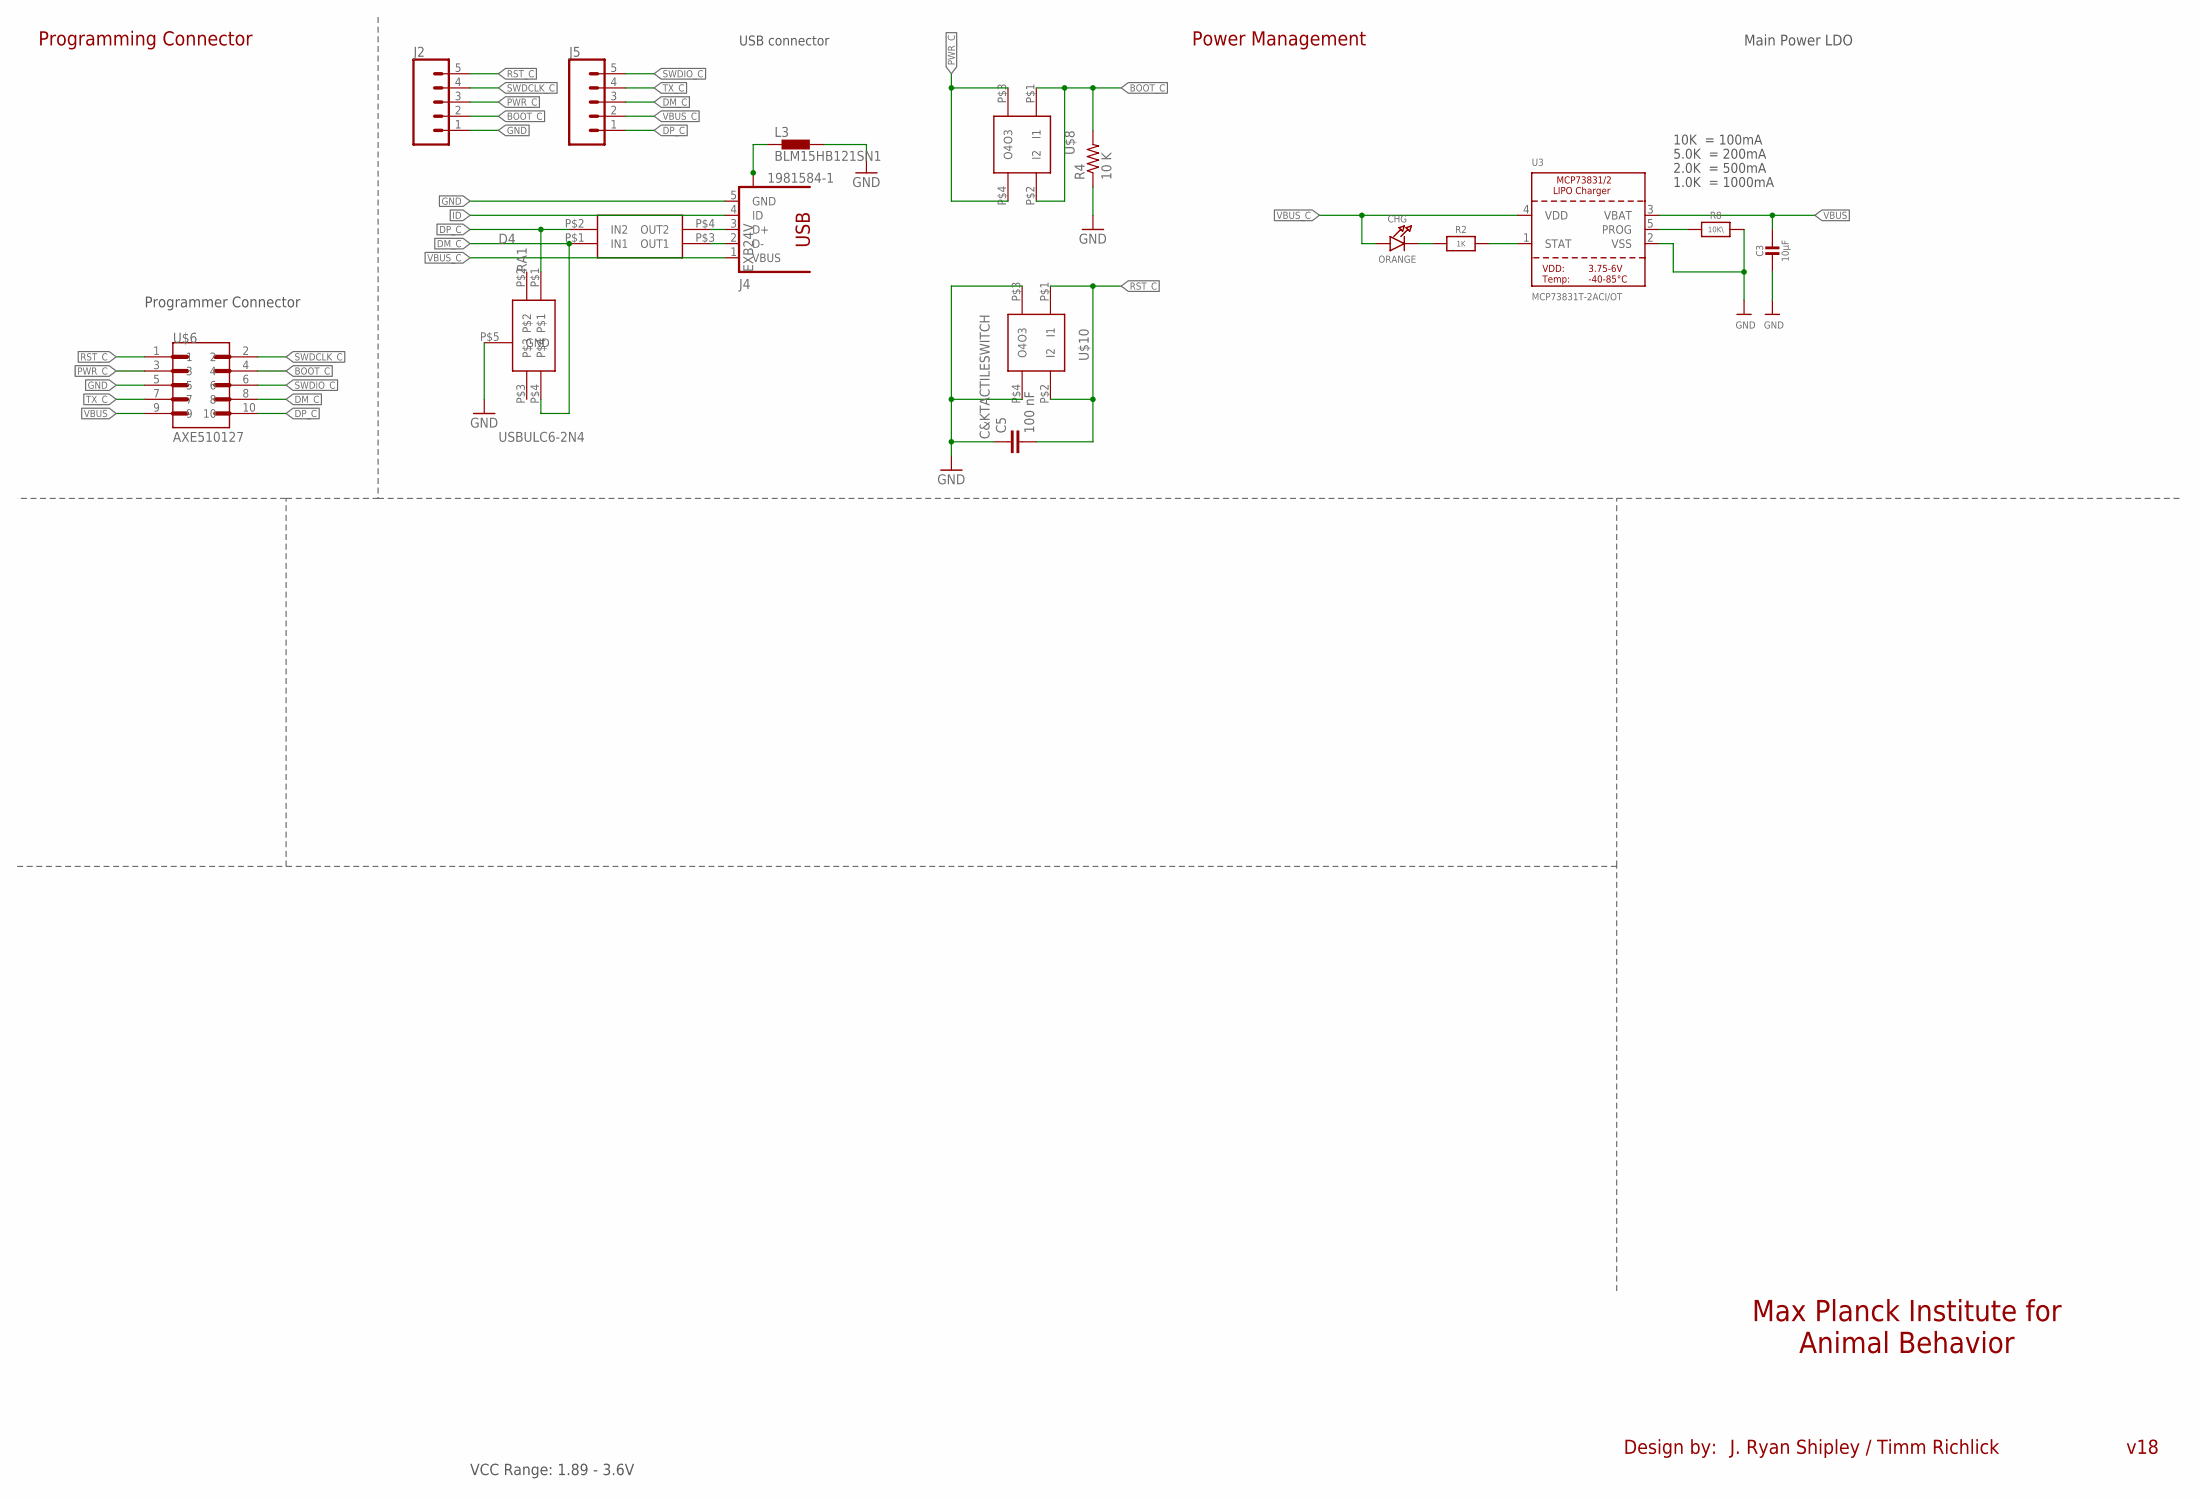
[picture p23: schematic GPS_radiologger_v20_CAM_M8Q_Programmer.sch]

Parts:
C3: 10µF; 0805-NO
C5: 100 nF; 0402-CAP
CHG: ORANGE; CHIPLED_0805_NOOUTLINE
D4: USBULC6-2N4
J2, J5: CONN_05; 1X05
J4: 1981584-1; MPN ZX62-AB-5PA(11)
L3: BLM15HB121SN1; 0402
R2: 1K; 0603-NO
R4: 10 K; 0402-RES
R8: 10K\; 0603-NO
RA1: EXB24V
U3: MCP73831T-2ACI/OT; SOT23-5
U$6: AXE510127
U$8, U$10: C&KTACTILESWITCH

Connections:
BOOT_C: J2.2, R4.2, U$6.4, U$8.P$1 (I1), U$8.P$2 (I2)
DM_C: D4.P$4, J5.3, RA1.P$1 (IN1), U$6.8
DP_C: D4.P$1, J5.1, RA1.P$2 (IN2), U$6.10
GND: C3.2, C5.1, D4.P$5 (GND), J2.1, J4.5 (GND), L3.2, R4.1, R8.2, U3.2 (VSS), U$6.5, U$10.P$3 (O3), U$10.P$4 (O4)
ID: J4.4 (ID)
unnamed: CHG.C, R2.1
unnamed: R2.2, U3.1 (STAT)
unnamed: R8.1, U3.5 (PROG)
unnamed: J4.3 (D+), RA1.P$4 (OUT2)
unnamed: J4.2 (D-), RA1.P$3 (OUT1)
PWR_C: J2.3, U$6.3, U$8.P$3 (O3), U$8.P$4 (O4)
RST_C: C5.2, J2.5, U$6.1, U$10.P$1 (I1), U$10.P$2 (I2)
SWDCLK_C: J2.4, U$6.2
SWDIO_C: J5.5, U$6.6
TX_C: J5.4, U$6.7
USB_SHIELD: J4.S1, J4.S2, J4.S3, J4.S4, L3.1
VBUS: C3.1, U3.3 (VBAT), U$6.9
VBUS_C: CHG.A, J4.1 (VBUS), J5.2, U3.4 (VDD)

Notes on the sheet:
VCC Range: 1.89 - 3.6V
Max Planck Institute for Animal Behavior
Programming Connector
Design by:
J. Ryan Shipley / Timm Richlick
v18
Power Management
Main Power LDO
USB connector
Programmer Connector
10K = 100mA
5.0K = 200mA
2.0K = 500mA
1.0K = 1000mA

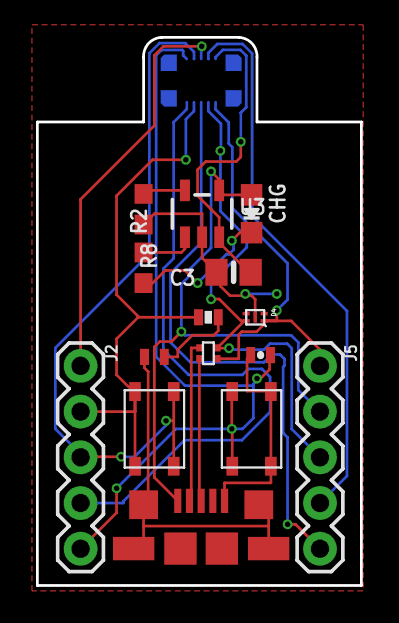
[picture p24: board GPS_radiologger_v20_CAM_M8Q_Programmer.brd from above]

Board: 2 copper layers, 18.0 x 30.4 mm, 16 parts (1 on the bottom side), 17 nets.
