trollock/Solar_LoRa_GPS/EAGLE/v21_L70_CMWX/cat24.brd

## EAGLE design EAGLE/v21_L70_CMWX/cat24.brd (2023-01-23, an earlier design)

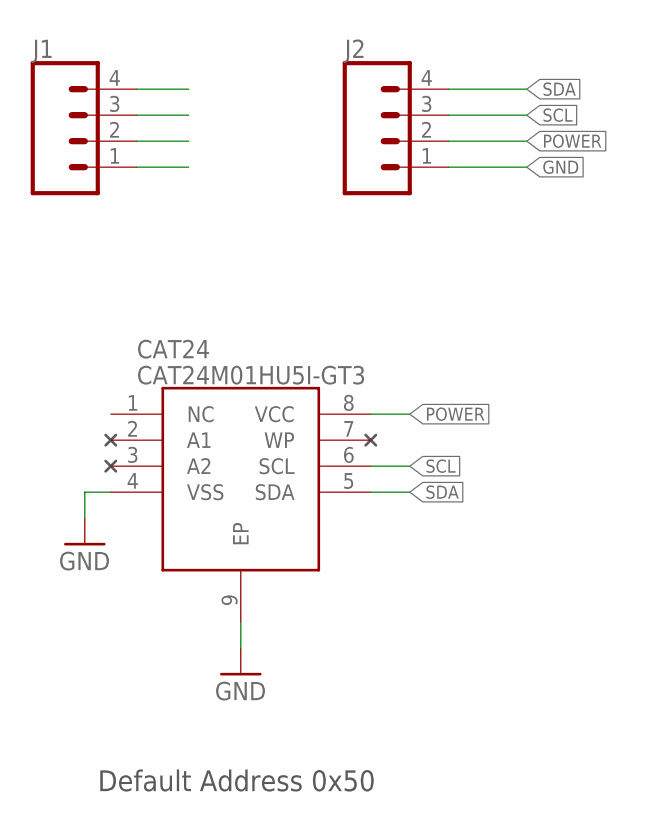
[picture p25: schematic cat24.sch]

Parts:
CAT24: CAT24M01HU5I-GT3; SON50P300X200X55-9N
J1, J2: CONN_041X04_NO_SILK; 1X04_NO_SILK

Connections:
GND: CAT24.4 (VSS), CAT24.9 (EP), J2.1
POWER: CAT24.8 (VCC), J2.2
SCL: CAT24.6 (SCL), J2.3
SDA: CAT24.5 (SDA), J2.4

Notes on the sheet:
Default Address 0x50

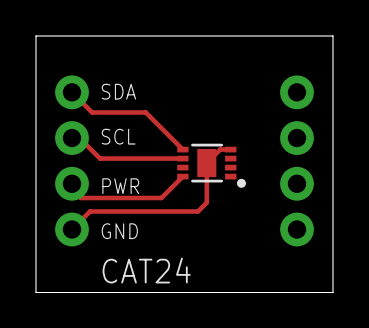
[picture p26: board cat24.brd from above]

Board: 2 copper layers, 16.5 x 14.2 mm, 3 parts (0 on the bottom side), 4 nets.
