trollock/Solar_LoRa_GPS/EAGLE/v25_LG77L_CMWX/GPS_radiologger_v25_LG77L_CMWX.brd

## EAGLE design EAGLE/v25_LG77L_CMWX/GPS_radiologger_v25_LG77L_CMWX.brd (2023-01-23, an earlier design)

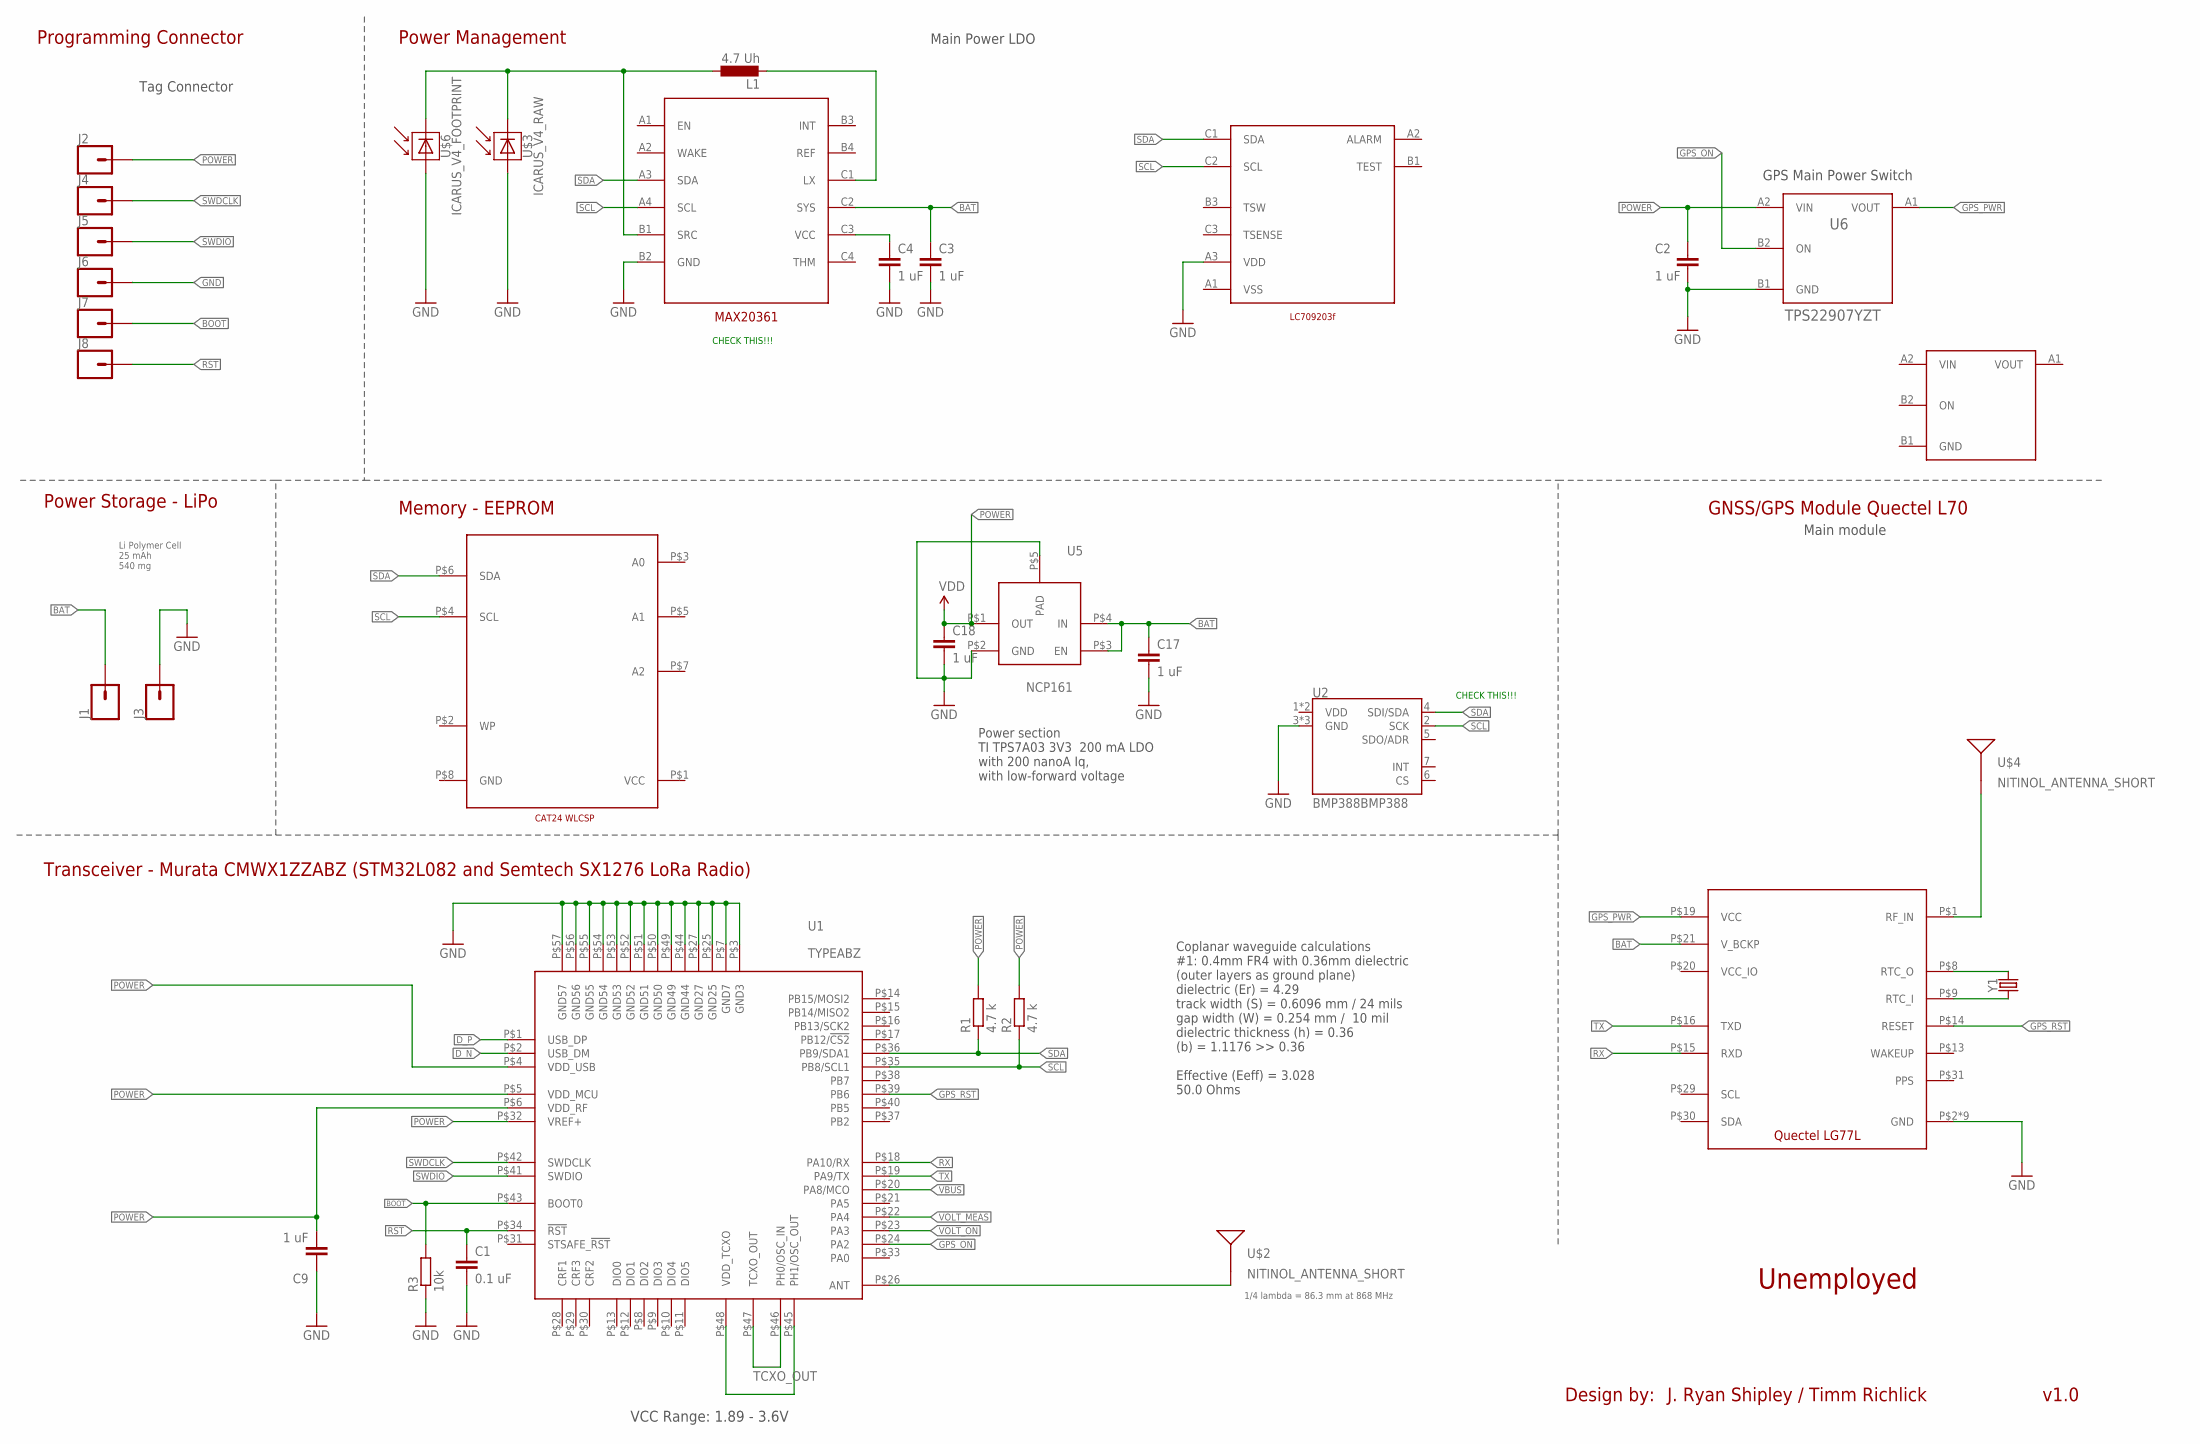
[picture p27: schematic GPS_radiologger_v25_LG77L_CMWX.sch]

Parts:
C1: 0.1 uF; C0201
C2, C3, C4, C9: 1 uF; C0201
C17, C18: 1 uF; 0402-CAP
J1, J2, J3, J4, J5, J6, J7, J8: CONN_01PTH_NO_SILK_SMALL; 1X01_SMALL
L1: 4.7 Uh; L2012C
R1, R2: 4.7 k; R0201
R3: 10k; R0201
U1: TYPEABZ
U2: BMP388BMP388; LGA-10(2X2)
U5: NCP161
U6: TPS22907YZT; YFP0004-DSBGA
U$1: MAX20361; BGA12N40P4X3_123X163X64N
U$2, U$4: NITINOL_ANTENNA_SHORT; ICARUS_NITINOL_ANTENNA_SHORT
U$3: ICARUS_V4_RAW; ICARUS_FULL_TOP
U$5: CAT24_WLCSP8; WLCSP8
U$6: ICARUS_V4_FOOTPRINT; ICARUS_FULL_FOOTPRINT
U$7: LG77L
U$8: LC709203F; BGA9N50P3X3_160X175X50N
U$9: TPS22916CL; YFP0004-DSBGA
Y1: CRYSTAL-32.768KHZ; CRYSTAL-SMD-1.0X1.2MM

Connections:
BAT: C3.1, C17.1, J1.P$1, U5.P$3 (EN), U5.P$4 (IN), U$1.C2 (SYS), U$7.P$21 (V_BCKP)
BOOT: J7.P$1, R3.2, U1.P$43 (BOOT0)
D_N: U1.P$2 (USB_DM)
D_P: U1.P$1 (USB_DP)
GND: C1.2, C2.2, C3.2, C4.2, C9.1, C17.2, C18.2, J3.P$1, J6.P$1, R3.1, U1.P$3 (GND3), U1.P$7 (GND7), U1.P$25 (GND25), U1.P$27 (GND27), U1.P$44 (GND44), U1.P$49 (GND49), U1.P$50 (GND50), U1.P$51 (GND51), U1.P$52 (GND52), U1.P$53 (GND53), U1.P$54 (GND54), U1.P$55 (GND55), U1.P$56 (GND56), U1.P$57 (GND57), U2.3 (GND), U2.8 (GND), U2.9 (GND), U5.P$2 (GND), U5.P$5 (PAD), U6.B1 (GND), U$1.B2 (GND), U$3.P$2 (MINUS), U$6.P$2 (MINUS), U$7.P$2 (GND), U$7.P$18 (GND), U$7.P$37 (GND), U$7.P$38 (GND), U$7.P$39 (GND), U$7.P$40 (GND), U$7.P$41 (GND), U$7.P$42 (GND), U$7.P$43 (GND), U$8.A3 (VDD)
GPS_ON: U1.P$24 (PA2), U6.B2 (ON)
GPS_PWR: U6.A1 (VOUT), U$7.P$19 (VCC)
GPS_RST: U1.P$39 (PB6), U$7.P$14 (RESET)
unnamed: U1.P$45 (PH1/OSC_OUT), U1.P$48 (VDD_TCXO)
unnamed: U$4.1, U$4.2, U$4.3, U$7.P$1 (RF_IN)
unnamed: U$7.P$8 (RTC_O), Y1.P$2 (2)
unnamed: U$7.P$9 (RTC_I), Y1.P$1 (1)
unnamed: L1.2, U$1.C1 (LX)
unnamed: C4.1, U$1.C3 (VCC)
unnamed: U1.P$26 (ANT), U$2.1, U$2.2, U$2.3
POWER: C2.1, C9.2, C18.1, J2.P$1, R1.2, R2.2, U1.P$4 (VDD_USB), U1.P$5 (VDD_MCU), U1.P$6 (VDD_RF), U1.P$32 (VREF+), U5.P$1 (OUT), U6.A2 (VIN)
RST: C1.1, J8.P$1, U1.P$34 (!RST)
RX: U1.P$18 (PA10/RX), U$7.P$15 (RXD)
SCL: R2.1, U1.P$35 (PB8/SCL1), U2.2 (SCK), U$1.A4 (SCL), U$5.P$4 (SCL), U$8.C2 (SCL)
SDA: R1.1, U1.P$36 (PB9/SDA1), U2.4 (SDI/SDA), U$1.A3 (SDA), U$5.P$6 (SDA), U$8.C1 (SDA)
SOL_IN: L1.1, U$1.B1 (SRC), U$3.P$1 (PLUS), U$6.P$1 (PLUS)
SWDCLK: J4.P$1, U1.P$42 (SWDCLK)
SWDIO: J5.P$1, U1.P$41 (SWDIO)
TCXO_OUT: U1.P$46 (PH0/OSC_IN), U1.P$47 (TCXO_OUT)
TX: U1.P$19 (PA9/TX), U$7.P$16 (TXD)
VBUS: U1.P$20 (PA8/MCO)
VOLT_MEAS: U1.P$22 (PA4)
VOLT_ON: U1.P$23 (PA3)

Notes on the sheet:
GNSS/GPS Module Quectel L70
VCC Range: 1.89 - 3.6V
Unemployed
Transceiver - Murata CMWX1ZZABZ (STM32L082 and Semtech SX1276 LoRa Radio)
Programming Connector
Power Storage - LiPo
Design by:
J. Ryan Shipley / Timm Richlick
v1.0
Li Polymer Cell 25 mAh 540 mg
Power Management
Main Power LDO
Memory - EEPROM
Main module
Coplanar waveguide calculations #1: 0.4mm FR4 with 0.36mm dielectric (outer layers as ground plane) dielectric (Er) = 4.29 track width (S) = 0.6096 mm / 24 mils gap width (W) = 0.254 mm / 10 mil dielectric thickness (h) = 0.36 (b) = 1.1176 >> 0.36 Effective (Eeff) = 3.028 50.0 Ohms
Tag Connector
1/4 lambda = 86.3 mm at 868 MHz
GPS Main Power Switch
Power section TI TPS7A03 3V3 200 mA LDO with 200 nanoA Iq, with low-forward voltage
CHECK THIS!!!

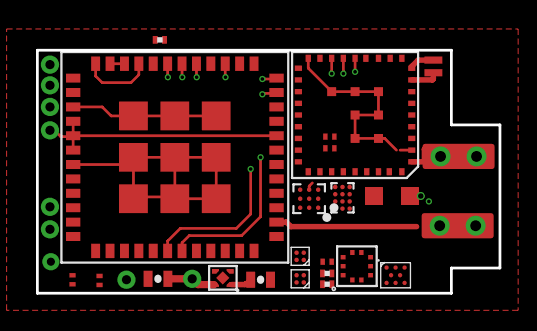
[picture p28: board GPS_radiologger_v25_LG77L_CMWX.brd from above]

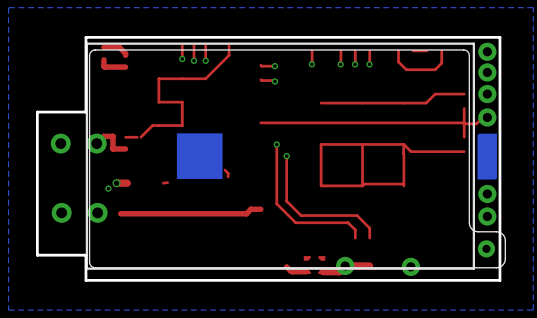
[picture p29: board GPS_radiologger_v25_LG77L_CMWX.brd from below]

Board: 4 copper layers, 25.7 x 13.5 mm, 33 parts (3 on the bottom side), 23 nets.
