trollock/Solar_LoRa_GPS/EAGLE/v21_L70_CMWX/GPS_radiologger_v21_L70_CMWX.brd

## EAGLE design EAGLE/v21_L70_CMWX/GPS_radiologger_v21_L70_CMWX.brd (2023-01-23, an earlier design)

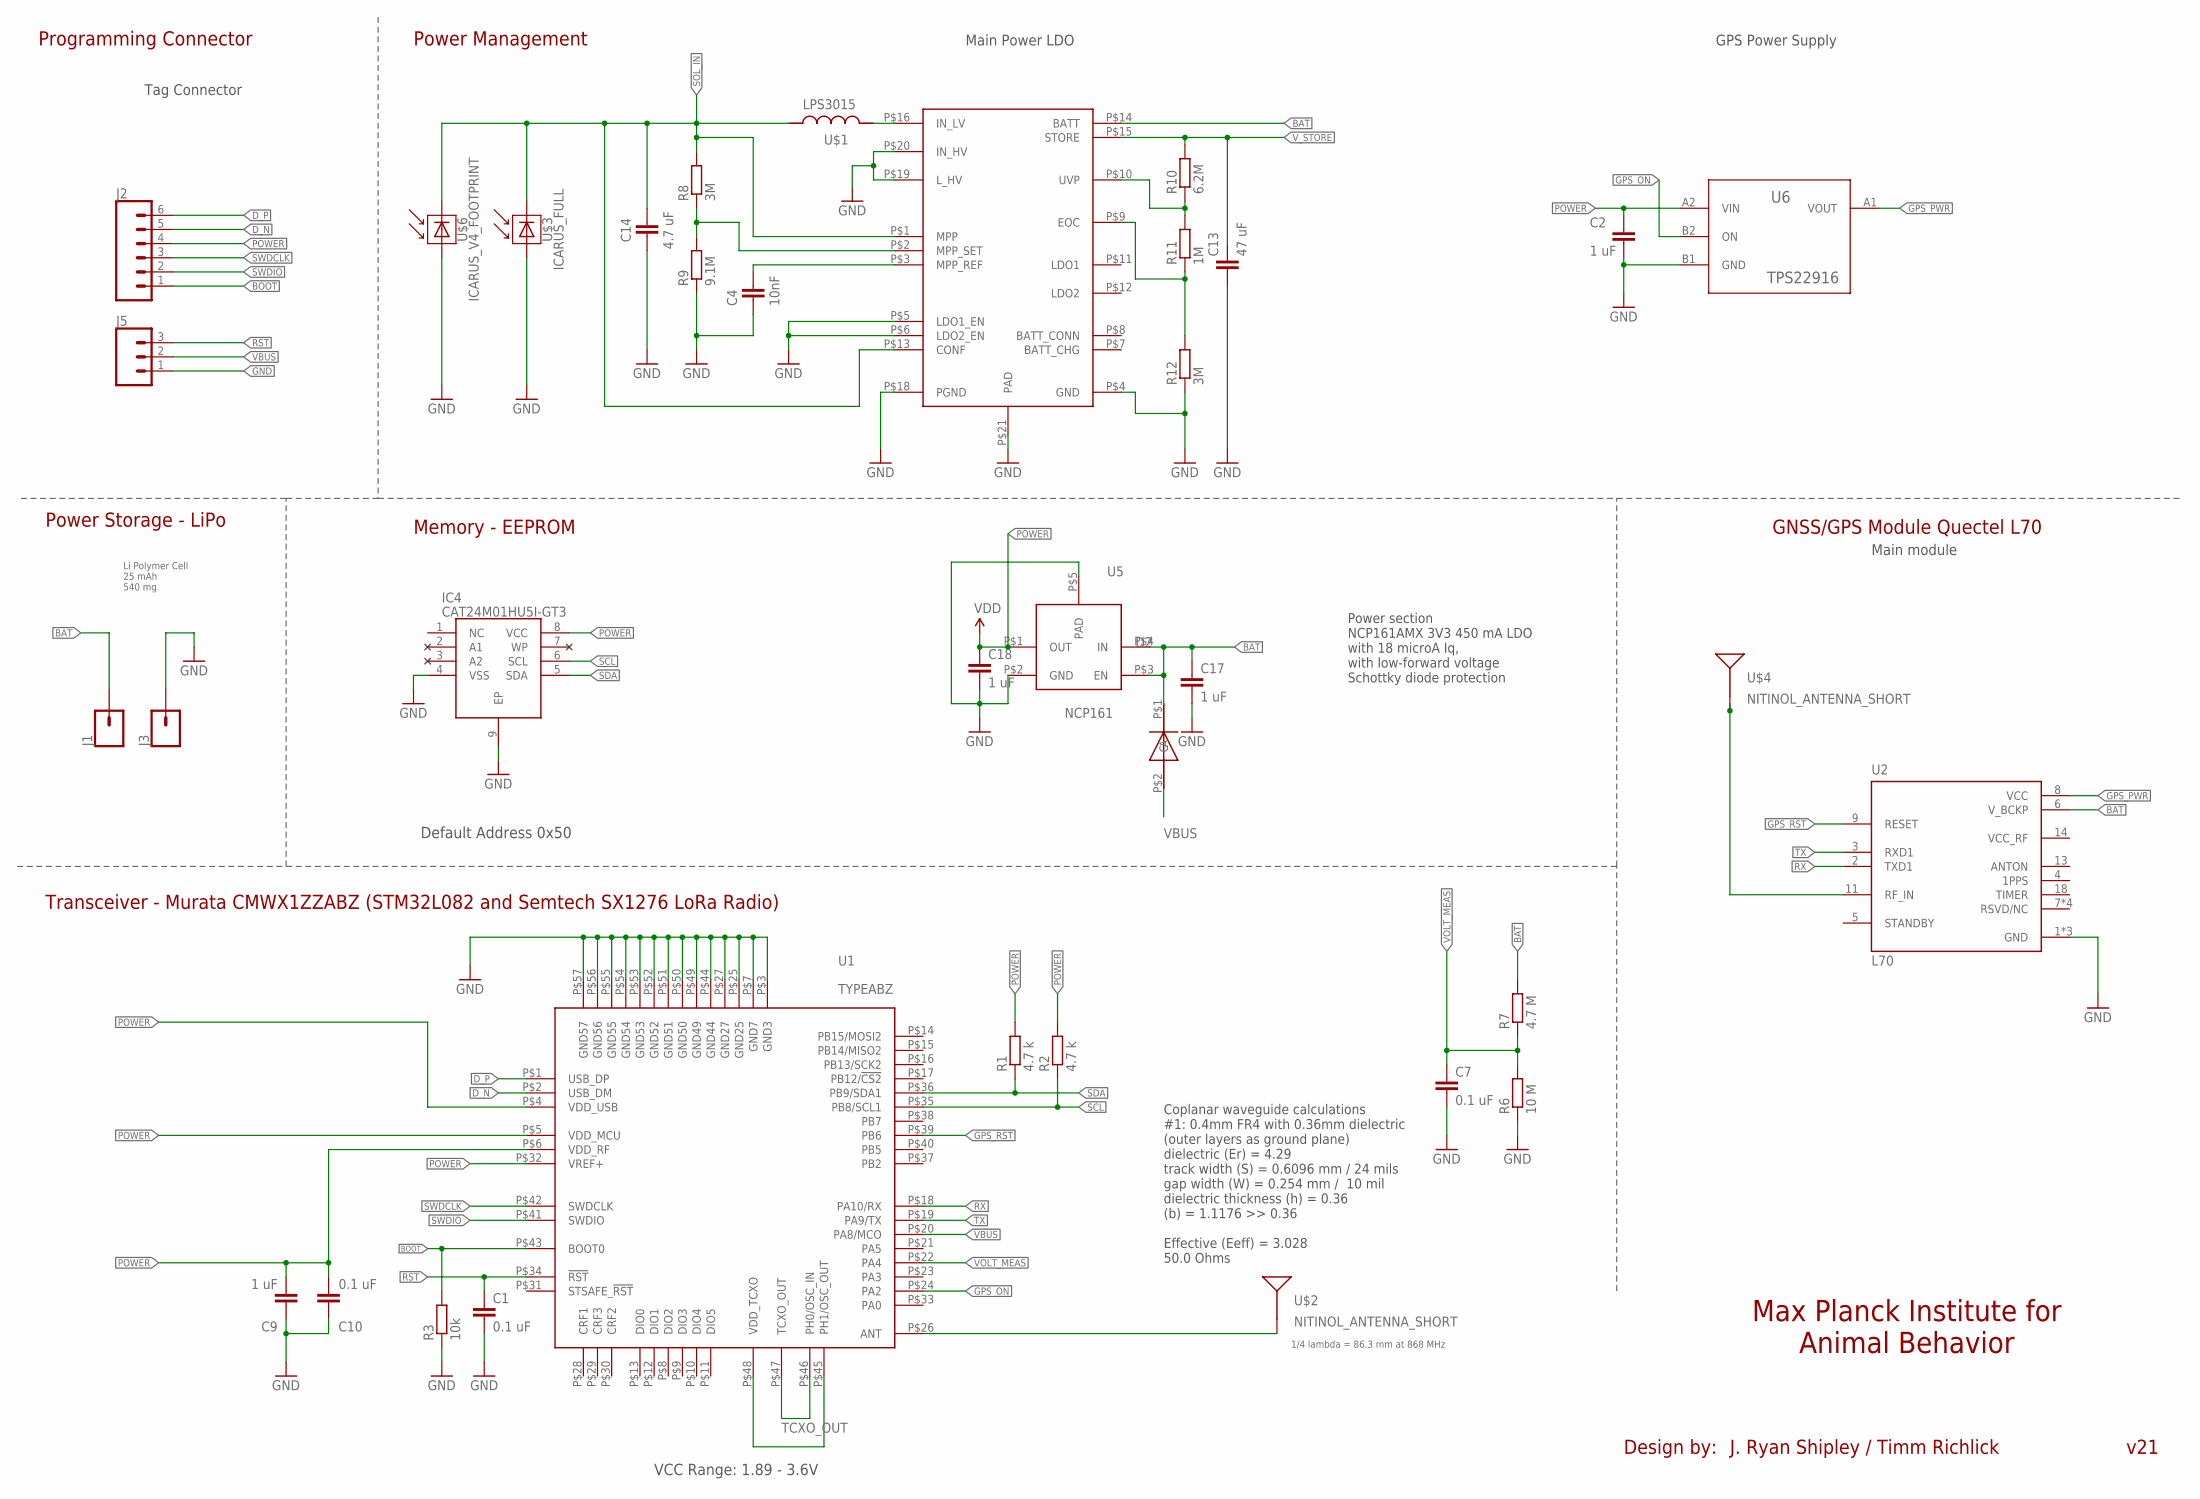
[picture p30: schematic GPS_radiologger_v21_L70_CMWX.sch]

Parts:
C1, C7, C10: 0.1 uF; C0201
C2, C9: 1 uF; C0201
C4: 10nF; C0201
C13: 47 uF; C0603
C14: 4.7 uF; C0201
C17, C18: 1 uF; 0402-CAP
D2: CDSQR4148-HF
IC4: CAT24M01HU5I-GT3; SON50P300X200X55-9N
J1, J3: CONN_01PTH_NO_SILK_SMALL; 1X01_SMALL
J2: CONN_061.27MM; 1X06_1.27MM
J5: CONN_031X03_1.27_NO_SILK; 1X03_1.27MM_NO_SILK
R1, R2: 4.7 k; R0201
R3: 10k; R0201
R6: 10 M; R0201
R7: 4.7 M; R0201
R8, R12: 3M; R0201
R9: 9.1M; R0201
R10: 6.2M; R0201
R11: 1M; R0201
U1: TYPEABZ
U2: L70; XCVR_L70
U4: SPV1050
U5: NCP161
U6: TPS22916
U$1: LPS3015; LPS_3015
U$2, U$4: NITINOL_ANTENNA_SHORT; ICARUS_NITINOL_ANTENNA_SHORT
U$3: ICARUS_FULL
U$6: ICARUS_V4_FOOTPRINT; ICARUS_FULL_FOOTPRINT

Connections:
BAT: C17.1, D2.P$1 (C), J1.P$1, R7.2, U2.6 (V_BCKP), U4.P$14 (BATT), U5.P$3 (EN), U5.P$4 (IN)
BOOT: J2.1, R3.2, U1.P$43 (BOOT0)
D_N: J2.5, U1.P$2 (USB_DM)
D_P: J2.6, U1.P$1 (USB_DP)
GND: C1.2, C2.2, C4.2, C7.2, C9.1, C10.1, C13.2, C14.2, C17.2, C18.2, IC4.4 (VSS), IC4.9 (EP), J3.P$1, J5.1, R3.1, R6.1, R9.1, R12.1, U1.P$3 (GND3), U1.P$7 (GND7), U1.P$25 (GND25), U1.P$27 (GND27), U1.P$44 (GND44), U1.P$49 (GND49), U1.P$50 (GND50), U1.P$51 (GND51), U1.P$52 (GND52), U1.P$53 (GND53), U1.P$54 (GND54), U1.P$55 (GND55), U1.P$56 (GND56), U1.P$57 (GND57), U2.1 (GND), U2.10 (GND), U2.12 (GND), U4.P$4 (GND), U4.P$5 (LDO1_EN), U4.P$6 (LDO2_EN), U4.P$18 (PGND), U4.P$19 (L_HV), U4.P$20 (IN_HV), U4.P$21 (PAD), U5.P$2 (GND), U5.P$5 (PAD), U6.B1 (GND), U$3.P$2 (MINUS), U$6.P$3 (MINUS)
GPS_ON: U1.P$24 (PA2), U6.B2 (ON)
GPS_PWR: U2.8 (VCC), U6.A1 (VOUT)
GPS_RST: U1.P$39 (PB6), U2.9 (RESET)
unnamed: U1.P$45 (PH1/OSC_OUT), U1.P$48 (VDD_TCXO)
unnamed: U2.11 (RF_IN), U$4.1, U$4.2, U$4.3
unnamed: U4.P$16 (IN_LV), U$1.P$2 (2)
unnamed: R8.1, R9.2, U4.P$2 (MPP_SET)
unnamed: R10.1, R11.2, U4.P$10 (UVP)
unnamed: R11.1, R12.2, U4.P$9 (EOC)
unnamed: U1.P$26 (ANT), U$2.1, U$2.2, U$2.3
unnamed: C4.1, U4.P$3 (MPP_REF)
POWER: C2.1, C9.2, C10.2, C18.1, IC4.8 (VCC), J2.4, R1.2, R2.2, U1.P$4 (VDD_USB), U1.P$5 (VDD_MCU), U1.P$6 (VDD_RF), U1.P$32 (VREF+), U5.P$1 (OUT), U6.A2 (VIN)
RST: C1.1, J5.3, U1.P$34 (!RST)
RX: U1.P$18 (PA10/RX), U2.2 (TXD1)
SCL: IC4.6 (SCL), R2.1, U1.P$35 (PB8/SCL1)
SDA: IC4.5 (SDA), R1.1, U1.P$36 (PB9/SDA1)
SOL_IN: C14.1, R8.2, U4.P$1 (MPP), U4.P$13 (CONF), U$1.P$1 (1), U$3.P$1 (PLUS), U$6.P$1 (PLUS)
SWDCLK: J2.3, U1.P$42 (SWDCLK)
SWDIO: J2.2, U1.P$41 (SWDIO)
TCXO_OUT: U1.P$46 (PH0/OSC_IN), U1.P$47 (TCXO_OUT)
TX: U1.P$19 (PA9/TX), U2.3 (RXD1)
VBUS: D2.P$2 (A), J5.2, U1.P$20 (PA8/MCO)
VOLT_MEAS: C7.1, R6.2, R7.1, U1.P$22 (PA4)
V_STORE: C13.1, R10.2, U4.P$15 (STORE)

Notes on the sheet:
GNSS/GPS Module Quectel L70
VCC Range: 1.89 - 3.6V
Max Planck Institute for Animal Behavior
Transceiver - Murata CMWX1ZZABZ (STM32L082 and Semtech SX1276 LoRa Radio)
Programming Connector
Power Storage - LiPo
Design by:
J. Ryan Shipley / Timm Richlick
v21
Li Polymer Cell 25 mAh 540 mg
Power Management
Main Power LDO
Memory - EEPROM
Main module
Coplanar waveguide calculations #1: 0.4mm FR4 with 0.36mm dielectric (outer layers as ground plane) dielectric (Er) = 4.29 track width (S) = 0.6096 mm / 24 mils gap width (W) = 0.254 mm / 10 mil dielectric thickness (h) = 0.36 (b) = 1.1176 >> 0.36 Effective (Eeff) = 3.028 50.0 Ohms
Tag Connector
Default Address 0x50
1/4 lambda = 86.3 mm at 868 MHz
GPS Power Supply
Power section NCP161AMX 3V3 450 mA LDO with 18 microA Iq, with low-forward voltage Schottky diode protection

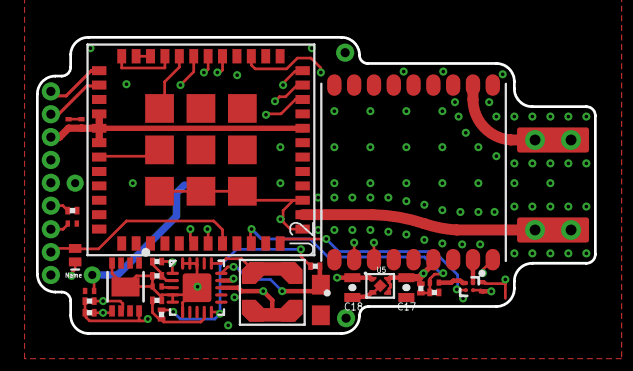
[picture p31: board GPS_radiologger_v21_L70_CMWX.brd from above]

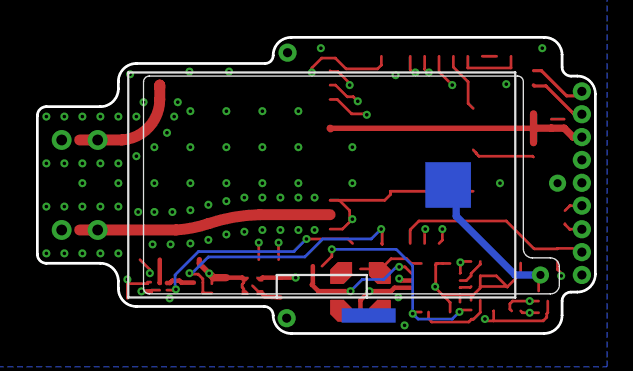
[picture p32: board GPS_radiologger_v21_L70_CMWX.brd from below]

Board: 4 copper layers, 31.0 x 16.4 mm, 36 parts (2 on the bottom side), 29 nets.
