trollock/Solar_LoRa_GPS/EAGLE/v20_CAM_M8Q/GPS_radiologger_v20_CAM_M8Q.brd

## EAGLE design EAGLE/v20_CAM_M8Q/GPS_radiologger_v20_CAM_M8Q.brd (2023-01-23)

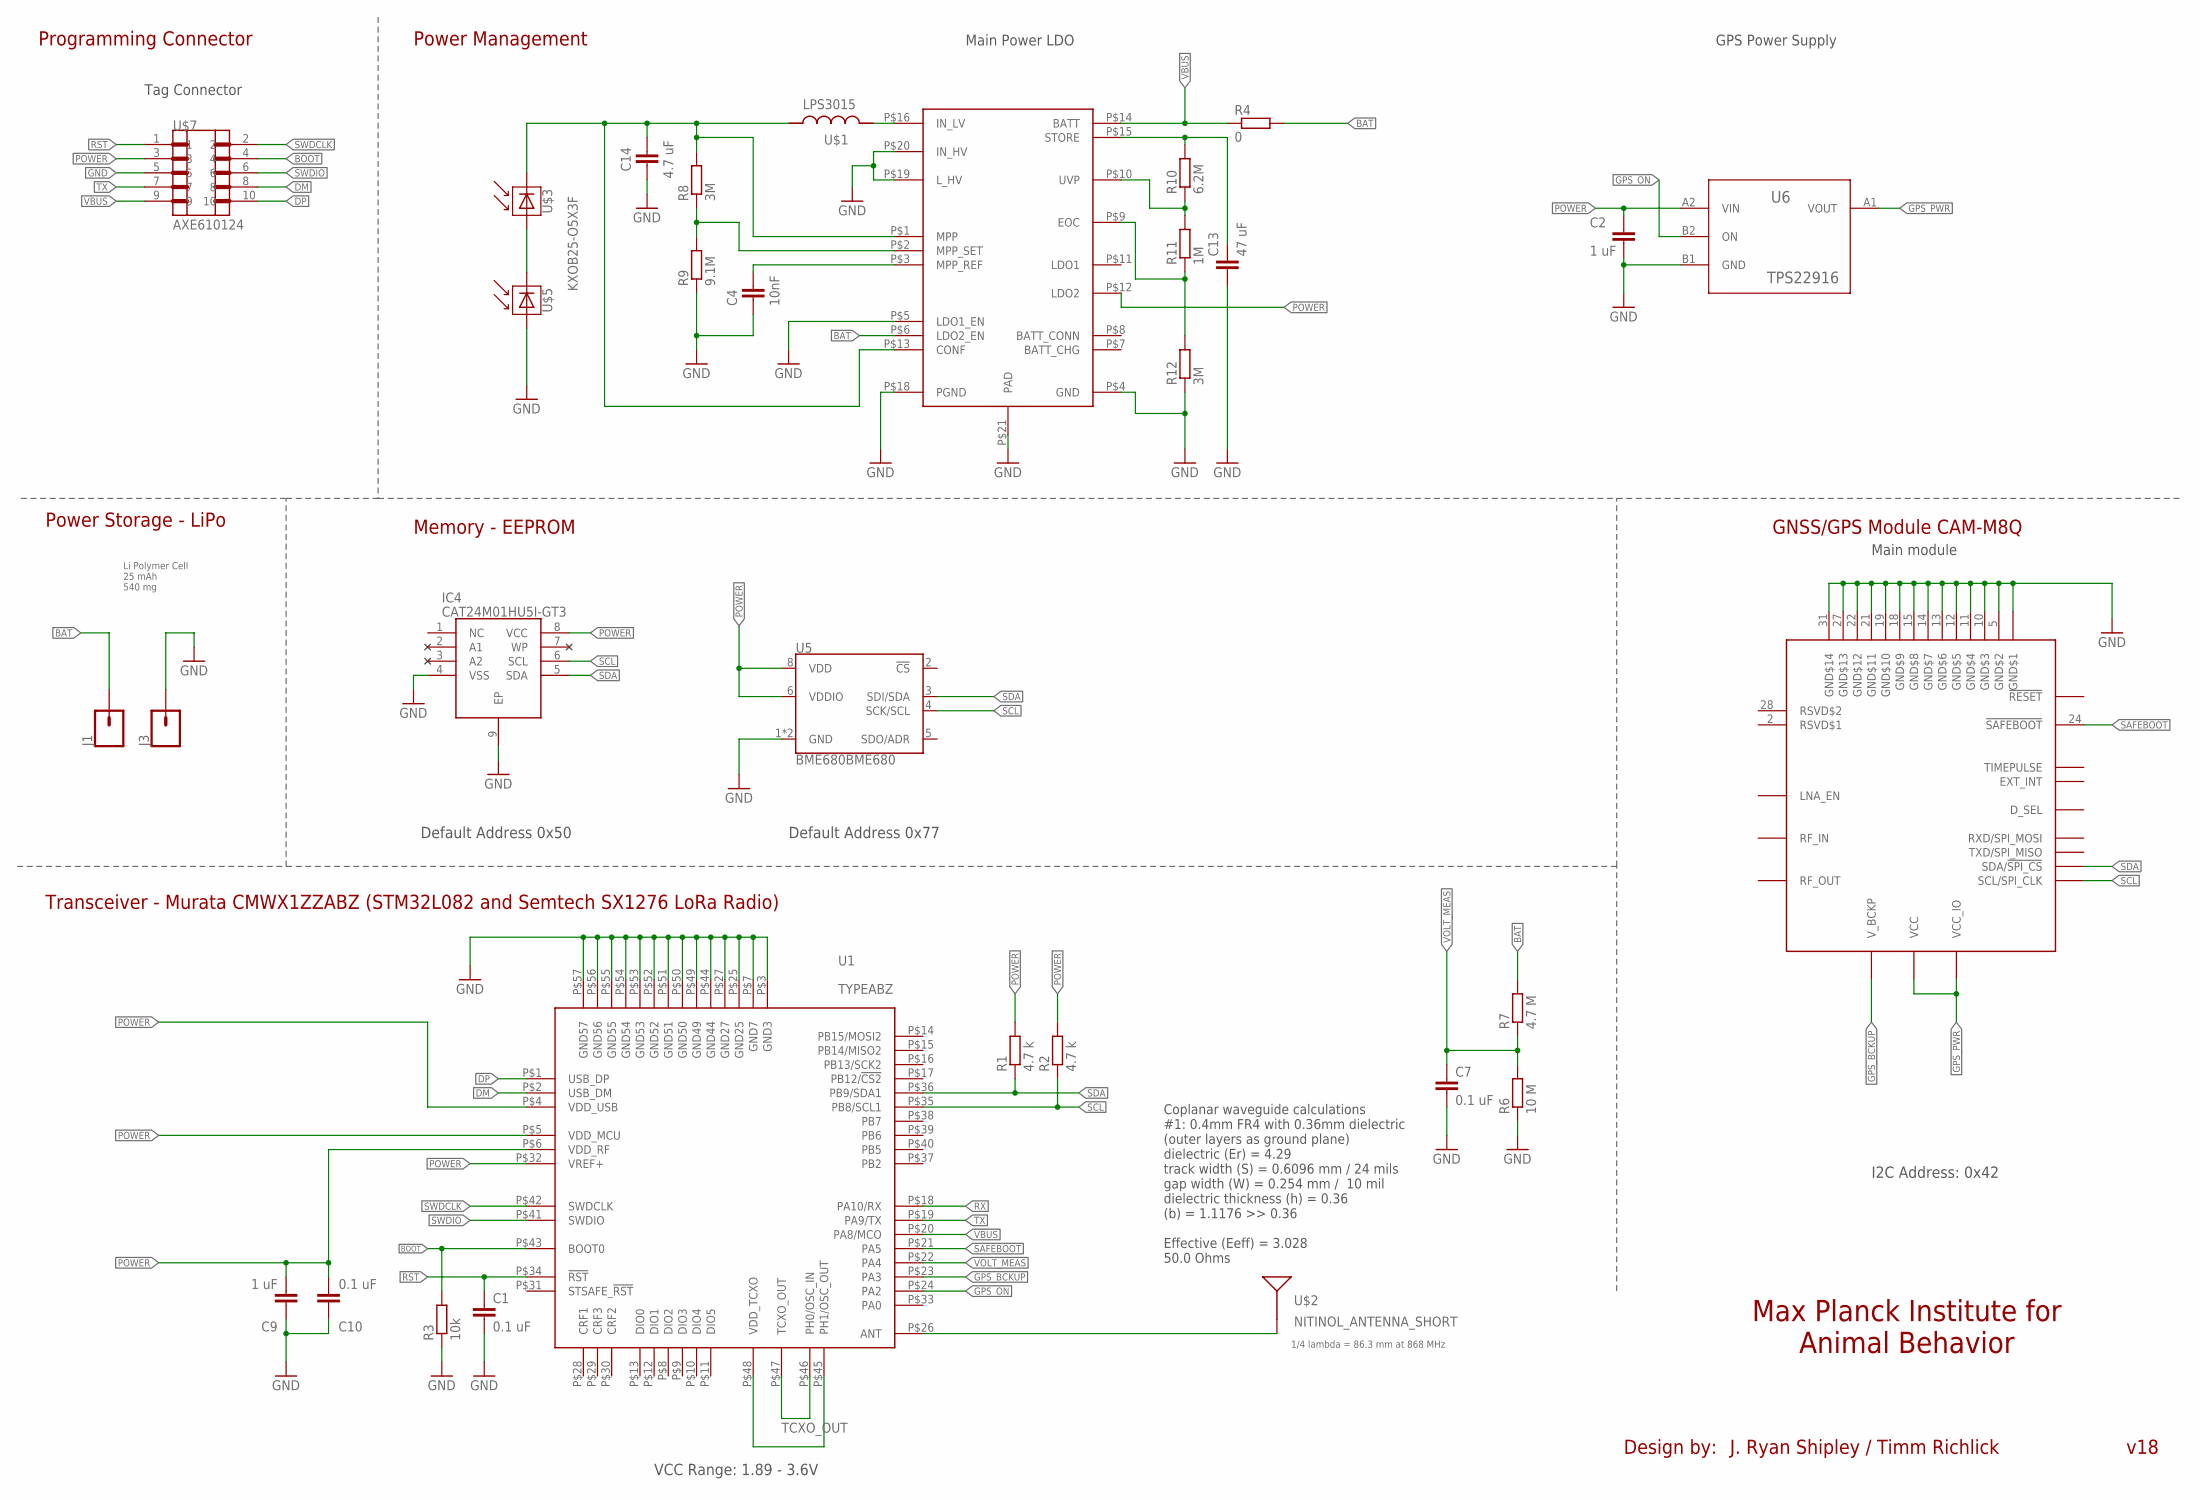
[picture p33: schematic GPS_radiologger_v20_CAM_M8Q.sch]

Parts:
C1, C7, C10: 0.1 uF; C0201
C2, C9: 1 uF; C0201
C4: 10nF; C0201
C13: 47 uF; C0805K
C14: 4.7 uF; C0201
IC4: CAT24M01HU5I-GT3; SON50P300X200X55-9N
J1, J3: CONN_01PTH_NO_SILK_YES_STOP; 1X01_NO_SILK
R1, R2: 4.7 k; R0201
R3: 10k; R0201
R4: 0; R0201
R6: 10 M; R0201
R7: 4.7 M; R0201
R8, R12: 3M; R0201
R9: 9.1M; R0201
R10: 6.2M; R0201
R11: 1M; R0201
U1: TYPEABZ
U4: SPV1050
U5: BME680BME680; LGA3.0X3.0
U6: TPS22916
U$1: LPS3015; LPS_3015
U$2: NITINOL_ANTENNA_SHORT; ICARUS_NITINOL_ANTENNA_SHORT
U$3, U$5: KXOB25-O5X3F; KXOB25-05X3F
U$4: CAM-M8
U$7: AXE610124

Connections:
BAT: J1.1, R4.2, R7.2, U4.P$6 (LDO2_EN)
BOOT: R3.2, U1.P$43 (BOOT0), U$7.4
DM: U1.P$2 (USB_DM), U$7.8
DP: U1.P$1 (USB_DP), U$7.10
GND: C1.2, C2.2, C4.2, C7.2, C9.1, C10.1, C13.2, C14.2, IC4.4 (VSS), IC4.9 (EP), J3.1, R3.1, R6.1, R9.1, R12.1, U1.P$3 (GND3), U1.P$7 (GND7), U1.P$25 (GND25), U1.P$27 (GND27), U1.P$44 (GND44), U1.P$49 (GND49), U1.P$50 (GND50), U1.P$51 (GND51), U1.P$52 (GND52), U1.P$53 (GND53), U1.P$54 (GND54), U1.P$55 (GND55), U1.P$56 (GND56), U1.P$57 (GND57), U4.P$4 (GND), U4.P$5 (LDO1_EN), U4.P$18 (PGND), U4.P$19 (L_HV), U4.P$20 (IN_HV), U4.P$21 (PAD), U5.1 (GND), U5.7 (GND), U6.B1 (GND), U$4.4 (GND$1), U$4.5 (GND$2), U$4.10 (GND$3), U$4.11 (GND$4), U$4.12 (GND$5), U$4.13 (GND$6), U$4.14 (GND$7), U$4.15 (GND$8), U$4.18 (GND$9), U$4.19 (GND$10), U$4.21 (GND$11), U$4.22 (GND$12), U$4.27 (GND$13), U$4.31 (GND$14), U$5.P$2 (MINUS), U$7.5
GPS_BCKUP: U1.P$23 (PA3), U$4.8 (V_BCKP)
GPS_ON: U1.P$24 (PA2), U6.B2 (ON)
GPS_PWR: U6.A1 (VOUT), U$4.1 (VCC_IO), U$4.9 (VCC)
unnamed: U1.P$45 (PH1/OSC_OUT), U1.P$48 (VDD_TCXO)
unnamed: U$3.P$2 (MINUS), U$5.P$1 (PLUS)
unnamed: U4.P$16 (IN_LV), U$1.P$2 (2)
unnamed: R8.1, R9.2, U4.P$2 (MPP_SET)
unnamed: C14.1, R8.2, U4.P$1 (MPP), U4.P$13 (CONF), U$1.P$1 (1), U$3.P$1 (PLUS)
unnamed: R10.1, R11.2, U4.P$10 (UVP)
unnamed: R11.1, R12.2, U4.P$9 (EOC)
unnamed: U1.P$26 (ANT), U$2.1, U$2.2, U$2.3
unnamed: C13.1, R10.2, U4.P$15 (STORE)
unnamed: C4.1, U4.P$3 (MPP_REF)
POWER: C2.1, C9.2, C10.2, IC4.8 (VCC), R1.2, R2.2, U1.P$4 (VDD_USB), U1.P$5 (VDD_MCU), U1.P$6 (VDD_RF), U1.P$32 (VREF+), U4.P$12 (LDO2), U5.6 (VDDIO), U5.8 (VDD), U6.A2 (VIN), U$7.3
RST: C1.1, U1.P$34 (!RST), U$7.1
RX: U1.P$18 (PA10/RX)
SAFEBOOT: U1.P$21 (PA5), U$4.24 (!SAFEBOOT)
SCL: IC4.6 (SCL), R2.1, U1.P$35 (PB8/SCL1), U5.4 (SCK/SCL), U$4.6 (SCL/SPI_CLK)
SDA: IC4.5 (SDA), R1.1, U1.P$36 (PB9/SDA1), U5.3 (SDI/SDA), U$4.3 (SDA/!SPI_CS)
SWDCLK: U1.P$42 (SWDCLK), U$7.2
SWDIO: U1.P$41 (SWDIO), U$7.6
TCXO_OUT: U1.P$46 (PH0/OSC_IN), U1.P$47 (TCXO_OUT)
TX: U1.P$19 (PA9/TX), U$7.7
VBUS: R4.1, U1.P$20 (PA8/MCO), U4.P$14 (BATT), U$7.9
VOLT_MEAS: C7.1, R6.2, R7.1, U1.P$22 (PA4)

Notes on the sheet:
GNSS/GPS Module CAM-M8Q
VCC Range: 1.89 - 3.6V
Max Planck Institute for Animal Behavior
Transceiver - Murata CMWX1ZZABZ (STM32L082 and Semtech SX1276 LoRa Radio)
Programming Connector
Power Storage - LiPo
Design by:
J. Ryan Shipley / Timm Richlick
v18
Li Polymer Cell 25 mAh 540 mg
Power Management
Main Power LDO
Memory - EEPROM
Main module
Coplanar waveguide calculations #1: 0.4mm FR4 with 0.36mm dielectric (outer layers as ground plane) dielectric (Er) = 4.29 track width (S) = 0.6096 mm / 24 mils gap width (W) = 0.254 mm / 10 mil dielectric thickness (h) = 0.36 (b) = 1.1176 >> 0.36 Effective (Eeff) = 3.028 50.0 Ohms
Tag Connector
Default Address 0x50
1/4 lambda = 86.3 mm at 868 MHz
GPS Power Supply
I2C Address: 0x42
Default Address 0x77

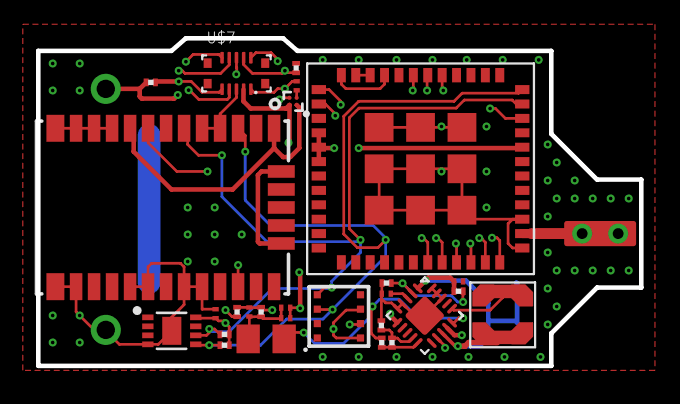
[picture p34: board GPS_radiologger_v20_CAM_M8Q.brd from above]

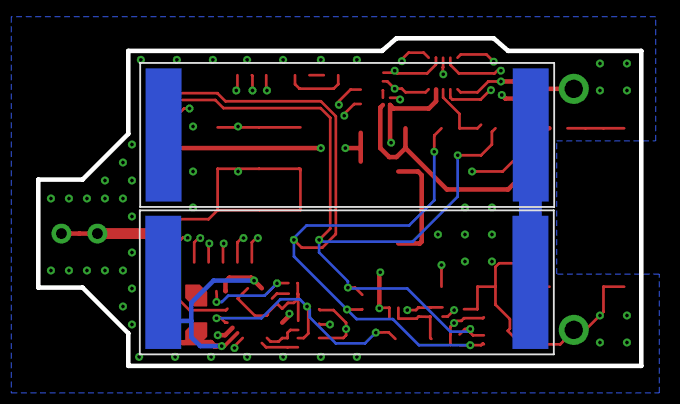
[picture p35: board GPS_radiologger_v20_CAM_M8Q.brd from below]

Board: 4 copper layers, 33.5 x 18.2 mm, 32 parts (2 on the bottom side), 29 nets.
