trollock/Solar_LoRa_GPS/EAGLE/v_19/GPS_radiologger_v19.brd

## EAGLE design EAGLE/v_19/GPS_radiologger_v19.brd (2020-11-18, an earlier design)

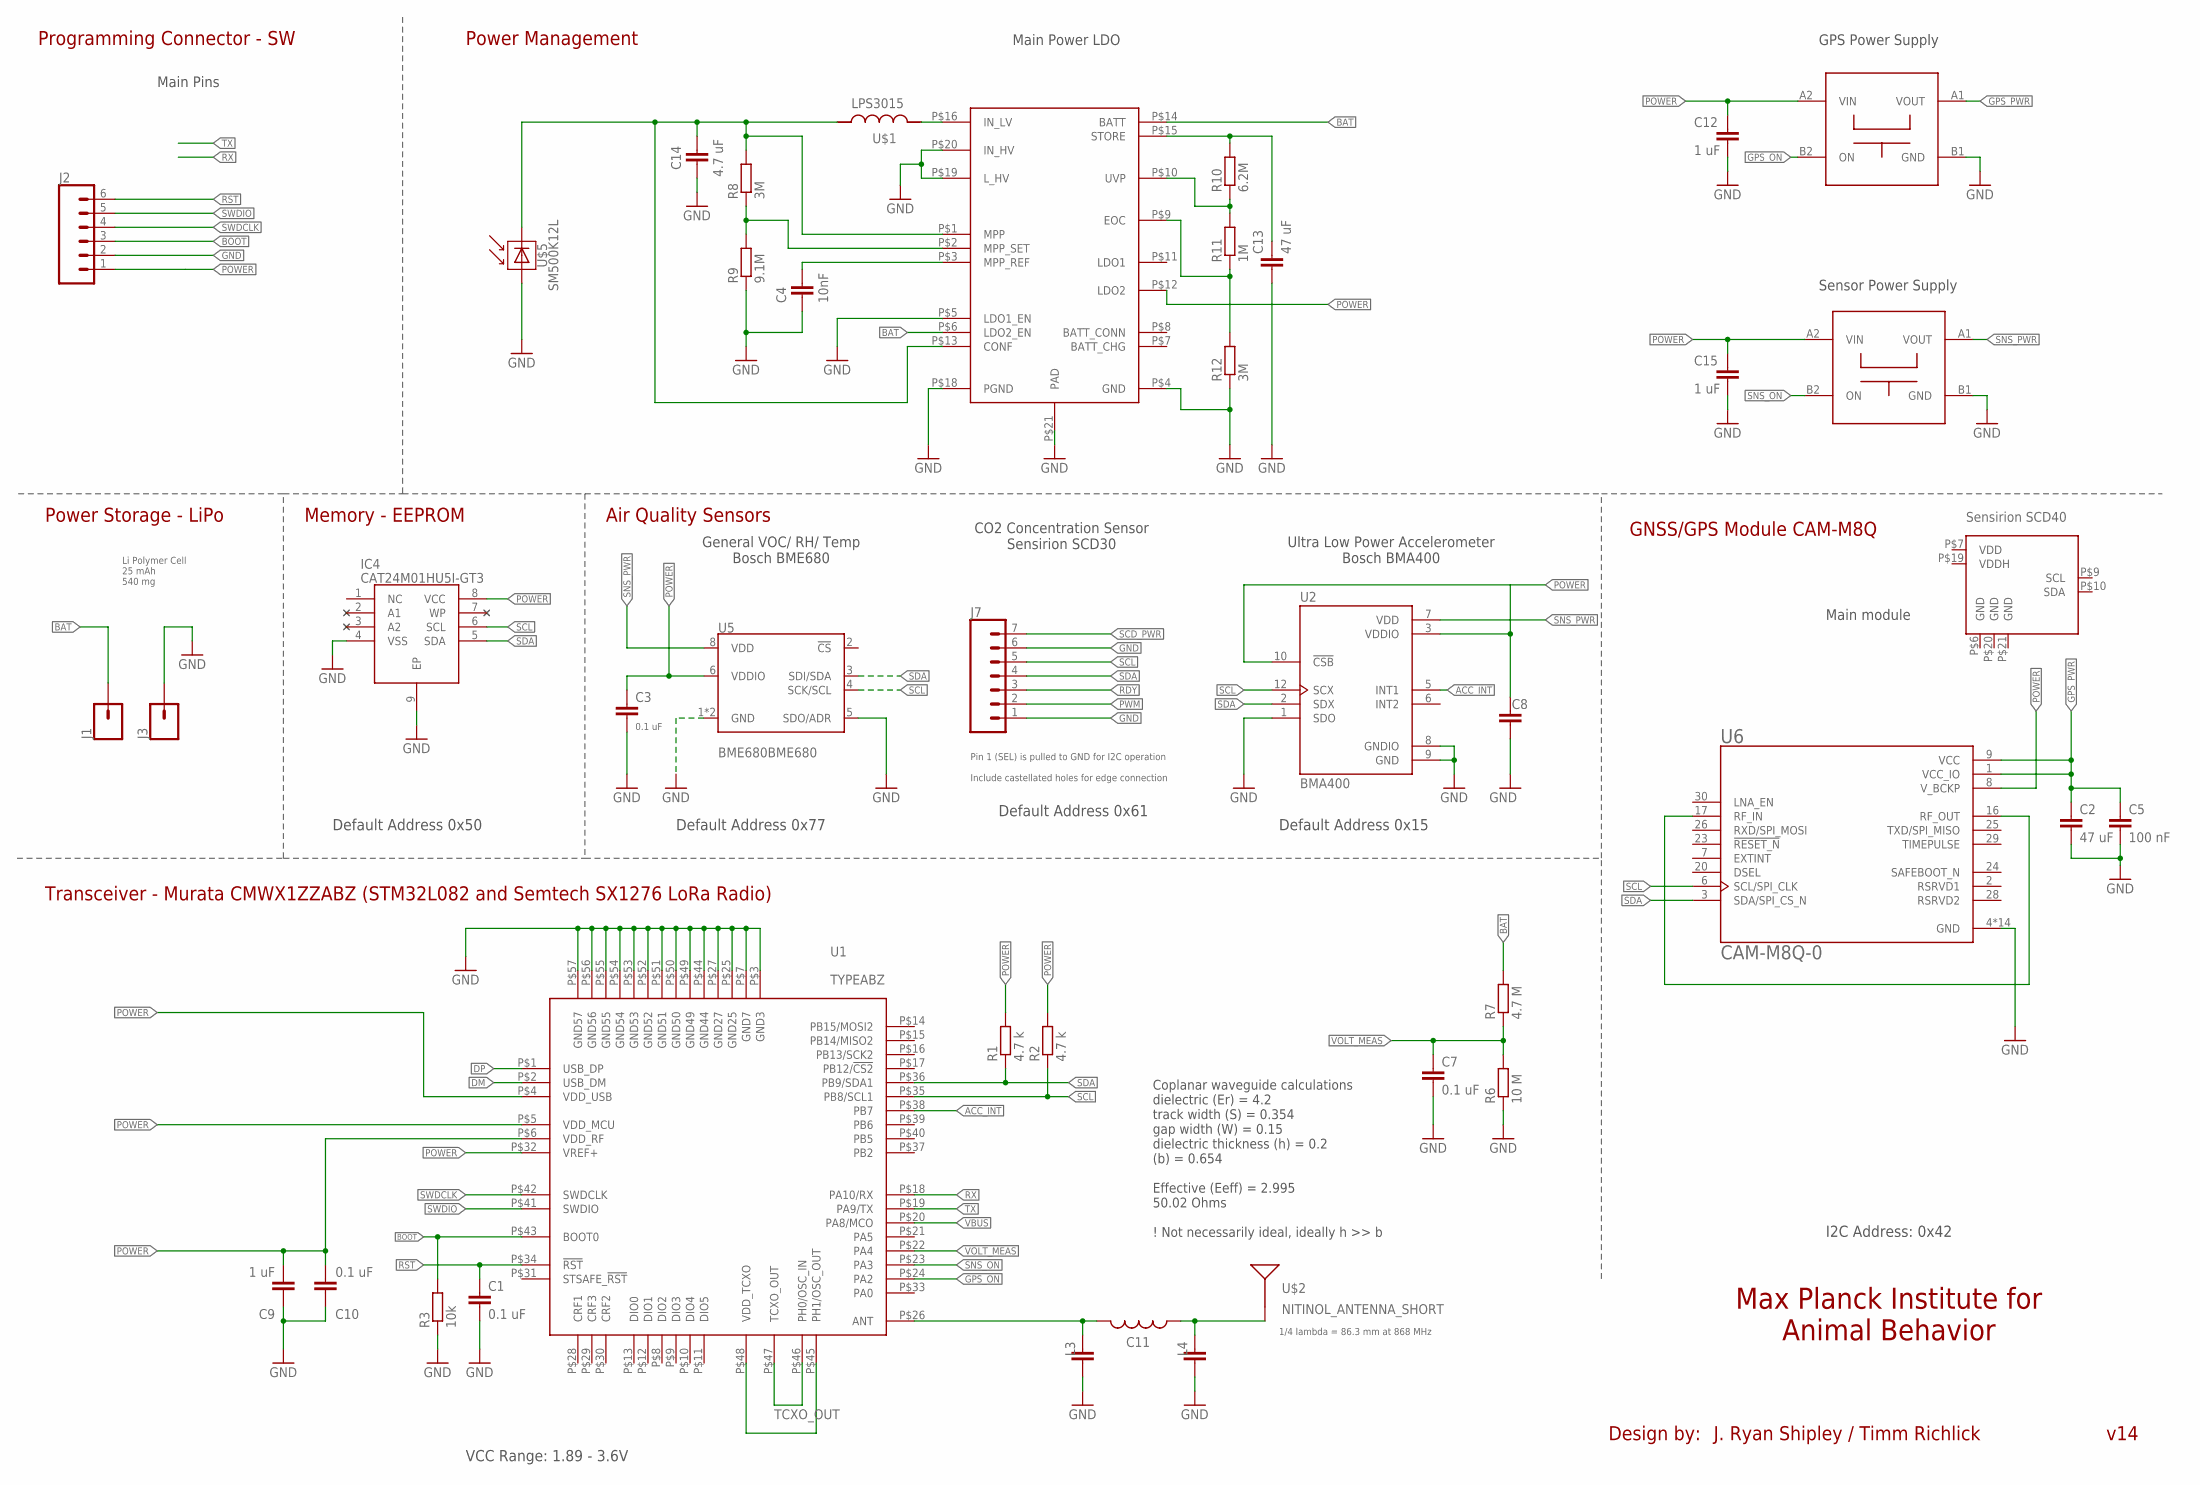
[picture p36: schematic GPS_radiologger_v19.sch]

Parts:
C1, C3, C7, C10: 0.1 uF; C0201
C2: 47 uF; C0201
C4: 10nF; C0201
C5: 100 nF; C0201
C8: C-EUC0201; C0201
C9, C12, C15: 1 uF; C0201
C11: 0.1uF; L0201
C13: 47 uF; C0805K
C14: 4.7 uF; C0201
IC4: CAT24M01HU5I-GT3; SON50P300X200X55-9N
J1, J3: CONN_01PTH_NO_SILK_YES_STOP; 1X01_NO_SILK
J2: CONN_06NO_SILK_NO_POP; 1X06_NO_SILK
J7: CONN_07NO_SILK; 1X07_NO_SILK
L3, L4: C-EUC0201; C0201
R1, R2: 4.7 k; R0201
R3: 10k; R0201
R6: 10 M; R0201
R7: 4.7 M; R0201
R8, R12: 3M; R0201
R9: 9.1M; R0201
R10: 6.2M; R0201
R11: 1M; R0201
U1: TYPEABZ
U2: BMA400; XDCR_BMA400
U4: SPV1050
U5: BME680BME680; LGA3.0X3.0
U6: CAM-M8Q-0; LCC100P960X1400X210-31N
U$1: LPS3015; LPS_3015
U$2: NITINOL_ANTENNA_SHORT; ICARUS_NITINOL_ANTENNA_SHORT
U$3, U$4: TPS22916CL; YFP0004-DSBGA
U$5: SM500K12L
U$6: SCD40; SCD40_LGA

Connections:
ACC_INT: U1.P$38 (PB7), U2.5 (INT1)
BAT: J1.1, R7.2, U4.P$6 (LDO2_EN), U4.P$14 (BATT)
BOOT: J2.3, R3.2, U1.P$43 (BOOT0)
DM: U1.P$2 (USB_DM)
DP: U1.P$1 (USB_DP)
GND: C1.2, C2.2, C3.2, C4.2, C5.2, C7.2, C8.2, C9.1, C10.1, C12.2, C13.2, C14.2, C15.2, IC4.4 (VSS), IC4.9 (EP), J2.2, J3.1, J7.1, J7.6, L3.2, L4.2, R3.1, R6.1, R9.1, R12.1, U1.P$3 (GND3), U1.P$7 (GND7), U1.P$25 (GND25), U1.P$27 (GND27), U1.P$44 (GND44), U1.P$49 (GND49), U1.P$50 (GND50), U1.P$51 (GND51), U1.P$52 (GND52), U1.P$53 (GND53), U1.P$54 (GND54), U1.P$55 (GND55), U1.P$56 (GND56), U1.P$57 (GND57), U2.1 (SDO), U2.8 (GNDIO), U2.9 (GND), U4.P$4 (GND), U4.P$5 (LDO1_EN), U4.P$18 (PGND), U4.P$19 (L_HV), U4.P$20 (IN_HV), U4.P$21 (PAD), U5.1 (GND), U5.5 (SDO/ADR), U5.7 (GND), U6.4 (GND), U6.5 (GND), U6.10 (GND), U6.11 (GND), U6.12 (GND), U6.13 (GND), U6.14 (GND), U6.15 (GND), U6.18 (GND), U6.19 (GND), U6.21 (GND), U6.22 (GND), U6.27 (GND), U6.31 (GND), U$3.B1 (GND), U$4.B1 (GND), U$5.P$2 (MINUS)
GPS_ON: U1.P$24 (PA2), U$3.B2 (ON)
GPS_PWR: C2.1, C5.1, U6.1 (VCC_IO), U6.9 (VCC), U$3.A1 (VOUT)
unnamed: U1.P$45 (PH1/OSC_OUT), U1.P$48 (VDD_TCXO)
unnamed: C11.2, L3.1, U1.P$26 (ANT)
unnamed: U4.P$16 (IN_LV), U$1.P$2 (2)
unnamed: C8.1, U2.3 (VDDIO)
unnamed: R8.1, R9.2, U4.P$2 (MPP_SET)
unnamed: C14.1, R8.2, U4.P$1 (MPP), U4.P$13 (CONF), U$1.P$1 (1), U$5.P$1 (PLUS)
unnamed: R10.1, R11.2, U4.P$10 (UVP)
unnamed: R11.1, R12.2, U4.P$9 (EOC)
unnamed: C11.1, L4.1, U$2.1, U$2.2, U$2.3
unnamed: C13.1, R10.2, U4.P$15 (STORE)
unnamed: C4.1, U4.P$3 (MPP_REF)
unnamed: U6.16 (RF_OUT), U6.17 (RF_IN)
POWER: C3.1, C9.2, C10.2, C12.1, C15.1, IC4.8 (VCC), J2.1, R1.2, R2.2, U1.P$4 (VDD_USB), U1.P$5 (VDD_MCU), U1.P$6 (VDD_RF), U1.P$32 (VREF+), U2.10 (!CSB), U4.P$12 (LDO2), U5.6 (VDDIO), U6.8 (V_BCKP), U$3.A2 (VIN), U$4.A2 (VIN)
PWM: J7.2
RDY: J7.3
RST: C1.1, J2.6, U1.P$34 (!RST)
RX: U1.P$18 (PA10/RX)
SCD_PWR: J7.7
SCL: IC4.6 (SCL), J7.5, R2.1, U1.P$35 (PB8/SCL1), U2.12 (SCX), U5.4 (SCK/SCL), U6.6 (SCL/SPI_CLK)
SDA: IC4.5 (SDA), J7.4, R1.1, U1.P$36 (PB9/SDA1), U2.2 (SDX), U5.3 (SDI/SDA), U6.3 (SDA/SPI_CS_N)
SNS_ON: U1.P$23 (PA3), U$4.B2 (ON)
SNS_PWR: U2.7 (VDD), U5.8 (VDD), U$4.A1 (VOUT)
SWDCLK: J2.4, U1.P$42 (SWDCLK)
SWDIO: J2.5, U1.P$41 (SWDIO)
TCXO_OUT: U1.P$46 (PH0/OSC_IN), U1.P$47 (TCXO_OUT)
TX: U1.P$19 (PA9/TX)
VBUS: U1.P$20 (PA8/MCO)
VOLT_MEAS: C7.1, R6.2, R7.1, U1.P$22 (PA4)

Notes on the sheet:
GNSS/GPS Module CAM-M8Q
VCC Range: 1.89 - 3.6V
I2C Address: 0x42
Max Planck Institute for Animal Behavior
Transceiver - Murata CMWX1ZZABZ (STM32L082 and Semtech SX1276 LoRa Radio)
Programming Connector - SW
Power Storage - LiPo
Design by:
J. Ryan Shipley / Timm Richlick
v14
Li Polymer Cell 25 mAh 540 mg
Power Management
Main Power LDO
Air Quality Sensors
Memory - EEPROM
GPS Power Supply
Main module
Coplanar waveguide calculations dielectric (Er) = 4.2 track width (S) = 0.354 gap width (W) = 0.15 dielectric thickness (h) = 0.2 (b) = 0.654 Effective (Eeff) = 2.995 50.02 Ohms ! Not necessarily ideal, ideally h >> b
Sensor Power Supply
Main Pins
Default Address 0x77
Default Address 0x50
1/4 lambda = 86.3 mm at 868 MHz
General VOC/ RH/ Temp Bosch BME680
Ultra Low Power Accelerometer Bosch BMA400
Default Address 0x15
CO2 Concentration Sensor Sensirion SCD30
Pin 1 (SEL) is pulled to GND for I2C operation
Include castellated holes for edge connection
Default Address 0x61

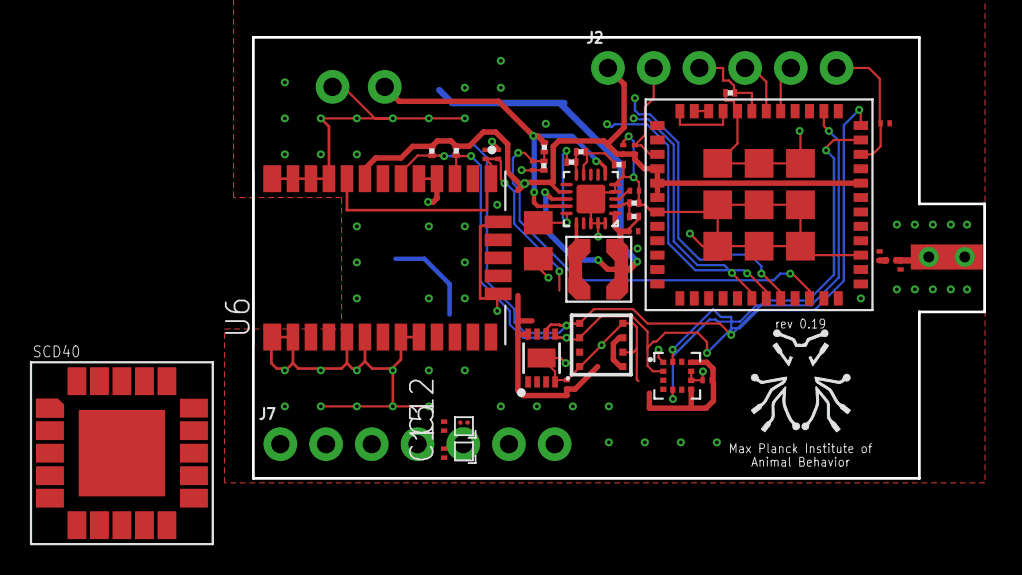
[picture p37: board GPS_radiologger_v19.brd from above]

Board: 2 copper layers, 40.6 x 24.5 mm, 42 parts (1 on the bottom side), 28 nets.
