trollock/Solar_LoRa_GPS/Reference Designs/Grasshopper/LoRa.v01h.brd

## EAGLE design Reference Designs/Grasshopper/LoRa.v01h.brd (2020-11-18)

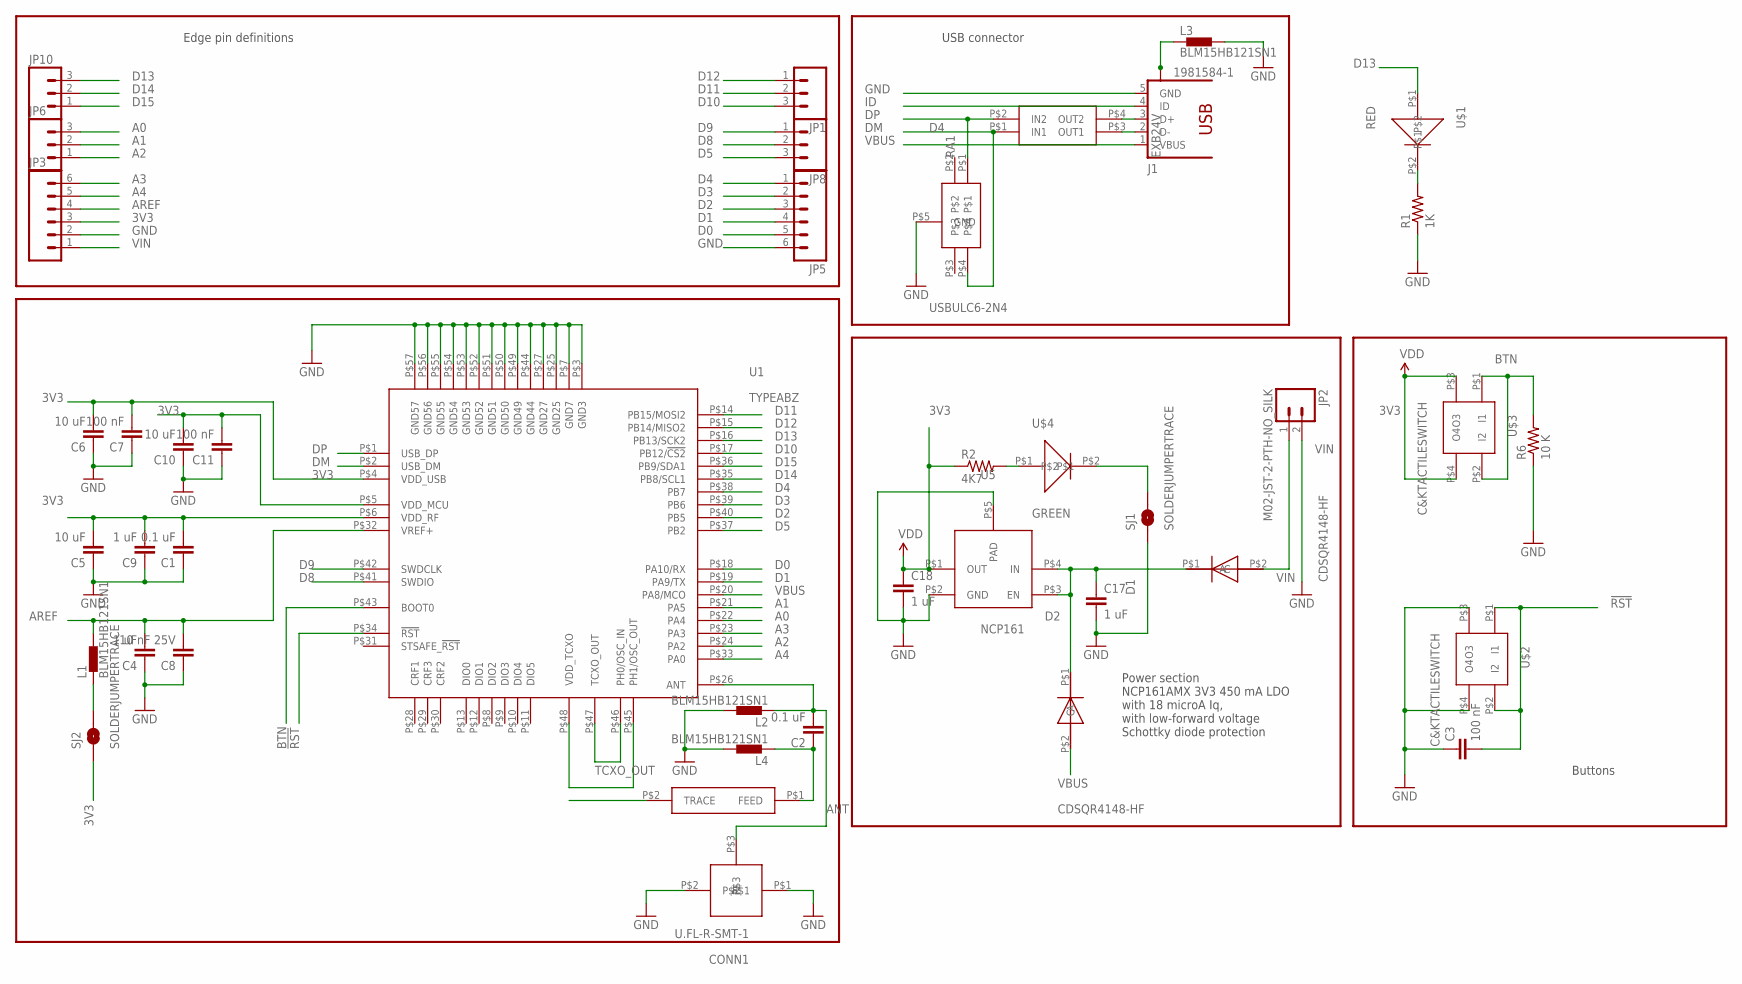
[picture p38: schematic LoRa.v01h.sch]

Parts:
C1, C2: 0.1 uF; 0402-CAP
C3, C7, C11: 100 nF; 0402-CAP
C4, C9, C17, C18: 1 uF; 0402-CAP
C5, C6, C10: 10 uF; 0402-CAP
C8: 10 nF 25V; 0402-CAP
CONN1: U.FL-R-SMT-1
D1, D2: CDSQR4148-HF
D4: USBULC6-2N4
J1: 1981584-1; MPN ZX62-AB-5PA(11)
JP1, JP6, JP8, JP10: M031X03_NO_SILK; 1X03_NO_SILK
JP2: M02-JST-2-PTH-NO_SILK; JST-2-PTH-NS
JP3, JP5: M06NO_SILK; 1X06_NO_SILK
L1, L2, L3, L4: BLM15HB121SN1; 0402
R1: 1K; 0402-RES
R2: 4K7; 0402-RES
R6: 10 K; 0402-RES
RA1: EXB24V
SJ1, SJ2: SOLDERJUMPERTRACE; SJ_2S-TRACE
U1: TYPEABZ
U5: NCP161
U$1: RED; 0402LED
U$2, U$3: C&KTACTILESWITCH
U$4: GREEN; 0402LED
U$5: JOHANSON0900AT43A0070

Connections:
3V3: C1.2, C5.2, C6.2, C7.2, C9.2, C10.2, C11.2, C18.1, JP3.3, R2.1, SJ2.1, U1.P$4 (VDD_USB), U1.P$5 (VDD_MCU), U1.P$6 (VDD_RF), U5.P$1 (OUT), U$3.P$3 (O3), U$3.P$4 (O4)
!RST: C3.2, U1.P$34 (!RST), U$2.P$1 (I1), U$2.P$2 (I2)
A0: JP6.3, U1.P$22 (PA4)
A1: JP6.2, U1.P$21 (PA5)
A2: JP6.1, U1.P$24 (PA2)
A3: JP3.6, U1.P$23 (PA3)
A4: JP3.5, U1.P$33 (PA0)
ANT: C2.1, L4.1, U$5.P$1 (FEED)
AREF: C4.2, C8.2, JP3.4, L1.2, U1.P$32 (VREF+)
BTN: R6.2, U1.P$43 (BOOT0), U$3.P$1 (I1), U$3.P$2 (I2)
D0: JP5.5, U1.P$18 (PA10/RX)
D1: JP5.4, U1.P$19 (PA9/TX)
D2: JP5.3, U1.P$40 (PB5)
D3: JP5.2, U1.P$39 (PB6)
D4: JP5.1, U1.P$38 (PB7)
D5: JP8.3, U1.P$37 (PB2)
D8: JP8.2, U1.P$41 (SWDIO)
D9: JP8.1, U1.P$42 (SWDCLK)
D10: JP1.3, U1.P$17 (PB12/!CS2)
D11: JP1.2, U1.P$14 (PB15/MOSI2)
D12: JP1.1, U1.P$15 (PB14/MISO2)
D13: JP10.3, U1.P$16 (PB13/SCK2), U$1.P$1
D14: JP10.2, U1.P$35 (PB8/SCL1)
D15: JP10.1, U1.P$36 (PB9/SDA1)
DM: D4.P$4, RA1.P$1 (IN1), U1.P$2 (USB_DM)
DP: D4.P$1, RA1.P$2 (IN2), U1.P$1 (USB_DP)
GND: C1.1, C3.1, C4.1, C5.1, C6.1, C7.1, C8.1, C9.1, C10.1, C11.1, C17.2, C18.2, CONN1.P$1, CONN1.P$2, D4.P$5 (GND), J1.5 (GND), JP2.2, JP3.2, JP5.6, L2.2, L3.2, L4.2, R1.1, R6.1, SJ1.1, U1.P$3 (GND3), U1.P$7 (GND7), U1.P$25 (GND25), U1.P$27 (GND27), U1.P$44 (GND44), U1.P$49 (GND49), U1.P$50 (GND50), U1.P$51 (GND51), U1.P$52 (GND52), U1.P$53 (GND53), U1.P$54 (GND54), U1.P$55 (GND55), U1.P$56 (GND56), U1.P$57 (GND57), U5.P$2 (GND), U5.P$5 (PAD), U$2.P$3 (O3), U$2.P$4 (O4)
ID: J1.4 (ID)
unnamed: R1.2, U$1.P$2
unnamed: L1.1, SJ2.2
unnamed: U1.P$45 (PH1/OSC_OUT), U1.P$48 (VDD_TCXO)
unnamed: SJ1.2, U$4.P$2
unnamed: J1.3 (D+), RA1.P$4 (OUT2)
unnamed: C2.2, CONN1.P$3, L2.1, U1.P$26 (ANT)
unnamed: J1.2 (D-), RA1.P$3 (OUT1)
unnamed: R2.2, U$4.P$1
unnamed: C17.1, D1.P$1 (C), D2.P$1 (C), U5.P$3 (EN), U5.P$4 (IN)
TCXO_OUT: U1.P$46 (PH0/OSC_IN), U1.P$47 (TCXO_OUT)
USB_SHIELD: J1.S1, J1.S2, J1.S3, J1.S4, L3.1
VBUS: D2.P$2 (A), J1.1 (VBUS), U1.P$20 (PA8/MCO)
VIN: D1.P$2 (A), JP2.1, JP3.1

Notes on the sheet:
Edge pin definitions
USB connector
Power section NCP161AMX 3V3 450 mA LDO with 18 microA Iq, with low-forward voltage Schottky diode protection
Buttons

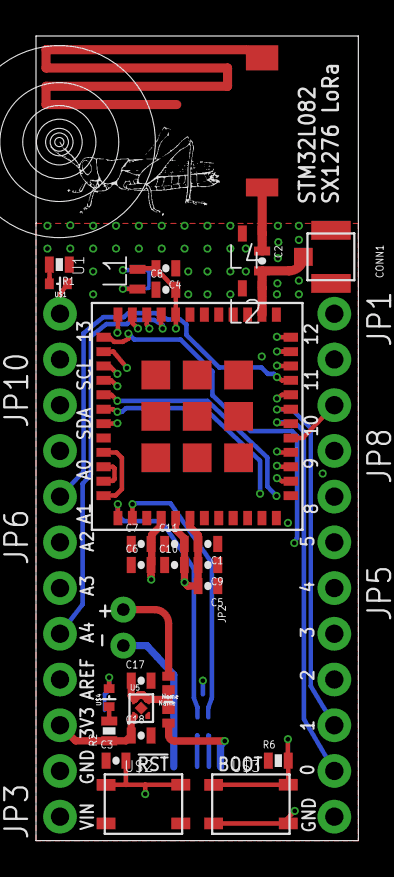
[picture p39: board LoRa.v01h.brd from above]

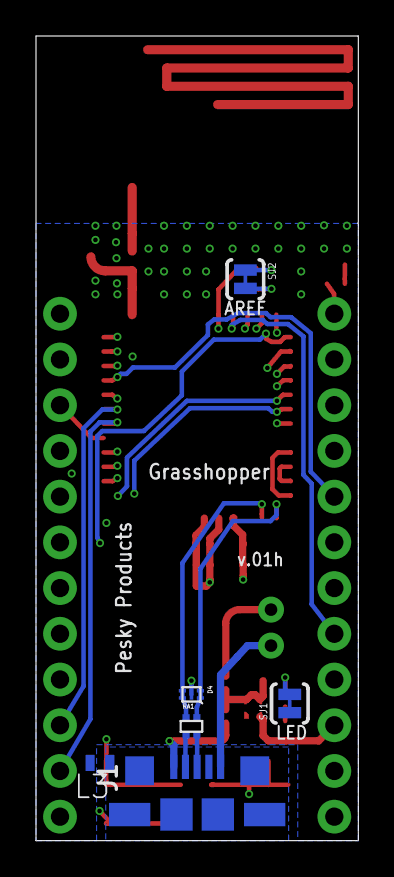
[picture p40: board LoRa.v01h.brd from below]

Board: 4 copper layers, 17.9 x 44.7 mm, 43 parts (6 on the bottom side), 40 nets.

Other parts of the board:
U$6: GRASSHOPPER
