trollock/Solar_LoRa_GPS/Reference Designs/TImm's SuperTiny/SuperTiny-REV4.brd

## EAGLE design Reference Designs/TImm's SuperTiny/SuperTiny-REV4.brd (2020-11-18)

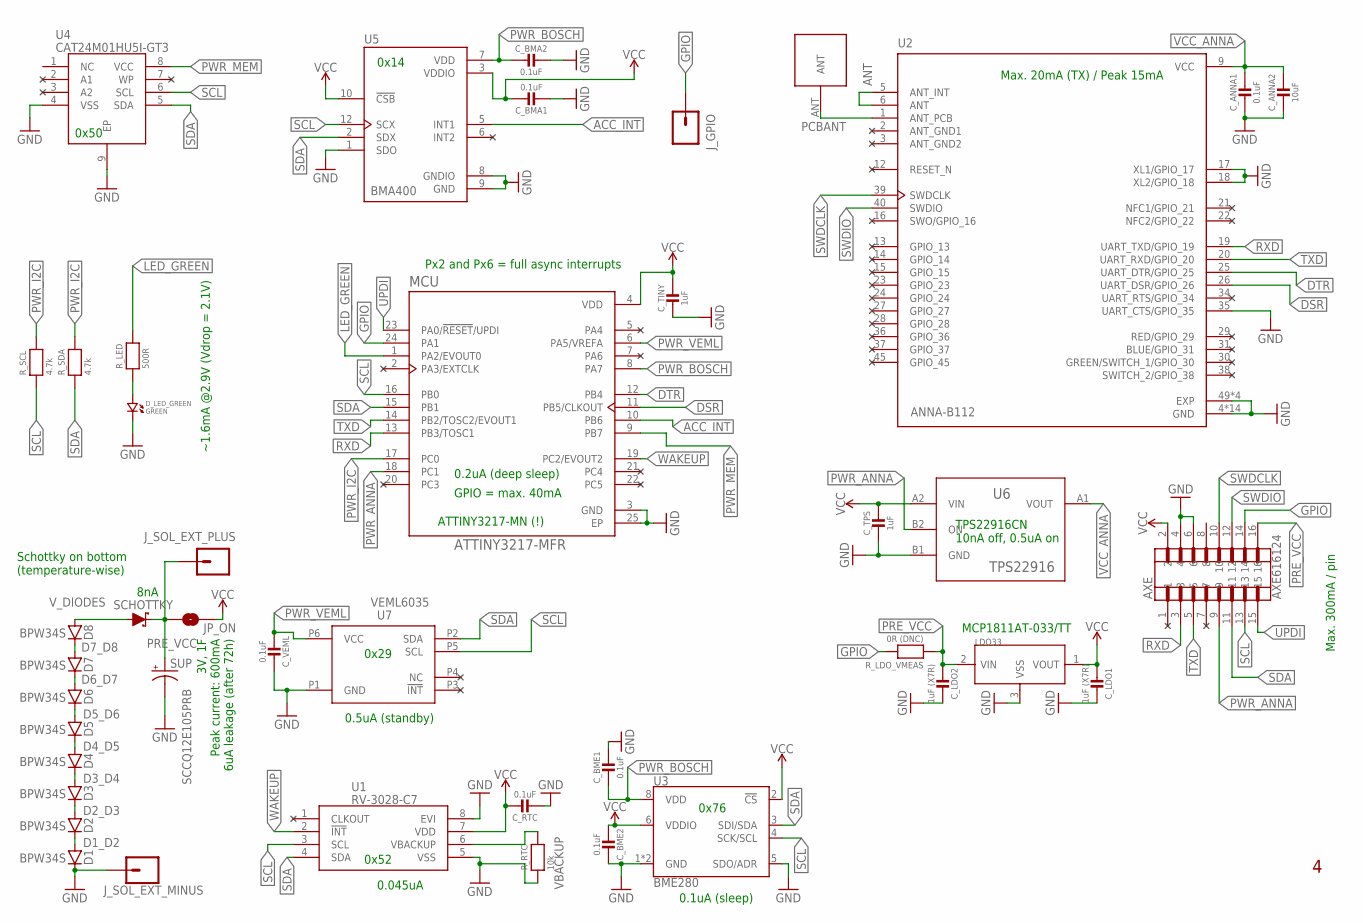
[picture p41: schematic SuperTiny-REV4.sch]

Parts:
AXE: AXE616124
C_ANNA1: 0.1uF; MICROBUILDER__0402MP
C_ANNA2: 10uF; MICROBUILDER__0402MP
C_BMA1, C_BMA2: 0.1uF; MICROBUILDER__0402MP
C_BME1, C_BME2: 0.1uF; MICROBUILDER__0402MP
C_LDO1, C_LDO2: 1uF (X7R); MICROBUILDER__0402MP
C_RTC: 0.1uF; MICROBUILDER__0402MP
C_TINY: 1uF; MICROBUILDER__0402MP
C_TPS: 1uF; MICROBUILDER__0402MP
C_VEML: 0.1uF; MICROBUILDER__0402MP
D1, D2, D3, D4, D5, D6, D7, D8: BPW34S
D_LED_GREEN: GREEN; CMONR_STANDARDPARTS_0402.LED
JP_ON: JUMPER-SMT_2_NO_NO-SILK; SMT-JUMPER_2_NO_NO-SILK
J_GPIO: CONN_01PTH_NO_SILK_SMALL; 1X01_SMALL
J_SOL_EXT_MINUS: CONN_01PTH_NO_SILK_SMALL; 1X01_SMALL
J_SOL_EXT_PLUS: CONN_01PTH_NO_SILK_SMALL; 1X01_SMALL
LDO33: MCP1812BT-018LB; SOT-23
MCU: ATTINY3217-MFR; QFN50P400X400X90-25N
R_LDO_VMEAS: 0R (DNC); MICROBUILDER__0402MP
R_LED: 500R; MICROBUILDER__0402MP
R_RTC: 10k; MICROBUILDER__0402MP
R_SCL: 4.7k; MICROBUILDER__0402MP
R_SDA: 4.7k; MICROBUILDER__0402MP
SCHOTTKY: NSR0140P2T5G
SUP: SCCQ12E105PRB
U1: RV-3028-C7; RV3028C7
U2: ANNA-B112; XCVR_ANNA-B112
U3: BME280; LGA-8-2.5X2.5
U4: CAT24M01HU5I-GT3; SON50P300X200X55-9N
U5: BMA400; XDCR_BMA400
U6: TPS22916
U7: VEML6035
U$4: ANNA-B112-PCB-ANTENNA

Connections:
ACC_INT: MCU.10 (PB6), U5.5 (INT1)
ANT: U2.5 (ANT_INT), U2.6 (ANT)
ANT_GND1: U2.2 (ANT_GND1)
ANT_GND2: U2.3 (ANT_GND2)
D1_D2: D1.PLUS, D2.MINUS
D2_D3: D2.PLUS, D3.MINUS
D3_D4: D3.PLUS, D4.MINUS
D4_D5: D4.PLUS, D5.MINUS
D5_D6: D5.PLUS, D6.MINUS
D6_D7: D6.PLUS, D7.MINUS
D7_D8: D7.PLUS, D8.MINUS
DSR: MCU.11 (PB5/CLKOUT), U2.26 (UART_DSR/GPIO_26)
DTR: MCU.12 (PB4), U2.25 (UART_DTR/GPIO_25)
GND: AXE.4, AXE.6, C_ANNA1.2, C_ANNA2.2, C_BMA1.2, C_BMA2.1, C_BME1.1, C_BME2.1, C_LDO1.1, C_LDO2.1, C_RTC.2, C_TINY.2, C_TPS.2, C_VEML.1, D1.MINUS, D_LED_GREEN.P$2 (2), J_SOL_EXT_MINUS.P$1, LDO33.3 (VSS), MCU.3 (GND), MCU.25 (EP), R_RTC.1, SUP.MINUS (-), U1.5 (VSS), U1.8 (EVI), U2.4 (GND), U2.7 (GND), U2.8 (GND), U2.10 (GND), U2.11 (GND), U2.17 (XL1/GPIO_17), U2.18 (XL2/GPIO_18), U2.32 (GND), U2.33 (GND), U2.35 (UART_CTS/GPIO_35), U2.41 (GND), U2.42 (GND), U2.43 (GND), U2.44 (GND), U2.46 (GND), U2.47 (GND), U2.48 (GND), U2.49 (EXP), U2.50 (EXP), U2.51 (EXP), U2.52 (EXP), U3.1 (GND), U3.5 (SDO/ADR), U3.7 (GND), U4.4 (VSS), U4.9 (EP), U5.1 (SDO), U5.8 (GNDIO), U5.9 (GND), U6.B1 (GND), U7.P1 (GND)
GPIO: AXE.14, J_GPIO.P$1, MCU.24 (PA1), R_LDO_VMEAS.2
LED_GREEN: MCU.1 (PA2/EVOUT0), R_LED.2
unnamed: D_LED_GREEN.P$1 (1), R_LED.1
PCBANT: U2.1 (ANT_PCB), U$4.ANT
PRE_VCC: AXE.16, C_LDO2.2, JP_ON.1, J_SOL_EXT_PLUS.P$1, LDO33.2 (VIN), R_LDO_VMEAS.1, SCHOTTKY.P$2 (CA), SUP.PLUS (+)
PWR_ANNA: AXE.9, MCU.18 (PC1), U6.B2 (ON)
PWR_BOSCH: C_BMA2.2, C_BME1.2, MCU.8 (PA7), U3.8 (VDD), U5.7 (VDD)
PWR_I2C: MCU.17 (PC0), R_SCL.2, R_SDA.2
PWR_MEM: MCU.9 (PB7), U4.8 (VCC)
PWR_VEML: C_VEML.2, MCU.6 (PA5/VREFA), U7.P6 (VCC)
RXD: AXE.3, MCU.13 (PB3/TOSC1), U2.19 (UART_TXD/GPIO_19)
SCL: AXE.13, MCU.16 (PB0), R_SCL.1, U1.3 (SCL), U3.4 (SCK/SCL), U4.6 (SCL), U5.12 (SCX), U7.P5 (SCL)
SDA: AXE.11, MCU.15 (PB1), R_SDA.1, U1.4 (SDA), U3.3 (SDI/SDA), U4.5 (SDA), U5.2 (SDX), U7.P2 (SDA)
SWDCLK: AXE.10, U2.39 (SWDCLK)
SWDIO: AXE.12, U2.40 (SWDIO)
TXD: AXE.5, MCU.14 (PB2/TOSC2/EVOUT1), U2.20 (UART_RXD/GPIO_20)
UPDI: AXE.15, MCU.23 (PA0/!RESET!/UPDI)
VBACKUP: R_RTC.2, U1.6 (VBACKUP)
VCC: AXE.2, C_BMA1.1, C_BME2.2, C_LDO1.2, C_RTC.1, C_TINY.1, C_TPS.1, JP_ON.2, LDO33.1 (VOUT), MCU.4 (VDD), U1.7 (VDD), U3.2 (!CS), U3.6 (VDDIO), U5.3 (VDDIO), U5.10 (!CSB), U6.A2 (VIN)
VCC_ANNA: C_ANNA1.1, C_ANNA2.1, U2.9 (VCC), U6.A1 (VOUT)
V_DIODES: D8.PLUS, SCHOTTKY.P$1 (AN)
WAKEUP: MCU.19 (PC2/EVOUT2), U1.2 (!INT)

Notes on the sheet:
Schottky on bottom (temperature-wise)
0.045uA
0x50
0x52
8nA
3V, 1F Peak current: 600mA 6uA leakage (after 72h)
Max. 20mA (TX) / Peak 15mA
~1.6mA @2.9V (Vdrop = 2.1V)
0x14
Max. 300mA / pin
0x76
0.1uA (sleep)
0.2uA (deep sleep)
GPIO = max. 40mA
Px2 and Px6 = full async interrupts
0x29
0.5uA (standby)
MCP1811AT-033/TT
TPS22916CN 10nA off, 0.5uA on
ATTINY3217-MN (!)

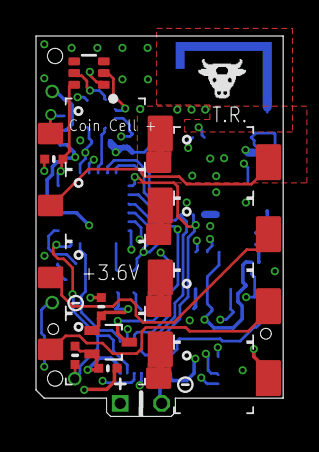
[picture p42: board SuperTiny-REV4.brd from above]

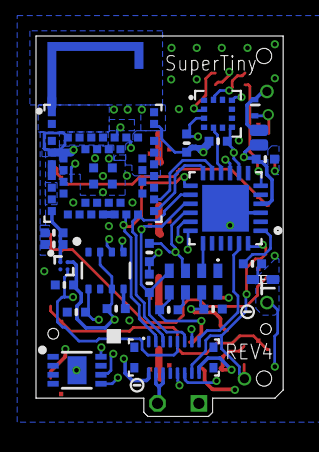
[picture p43: board SuperTiny-REV4.brd from below]

Board: 4 copper layers, 13.7 x 21.1 mm, 43 parts (25 on the bottom side), 34 nets.
