trollock/Solar_LoRa_GPS/EAGLE/early versions/GPS_radiologger_v5.brd

## EAGLE design EAGLE/early versions/GPS_radiologger_v5.brd (2020-06-16, an earlier design)

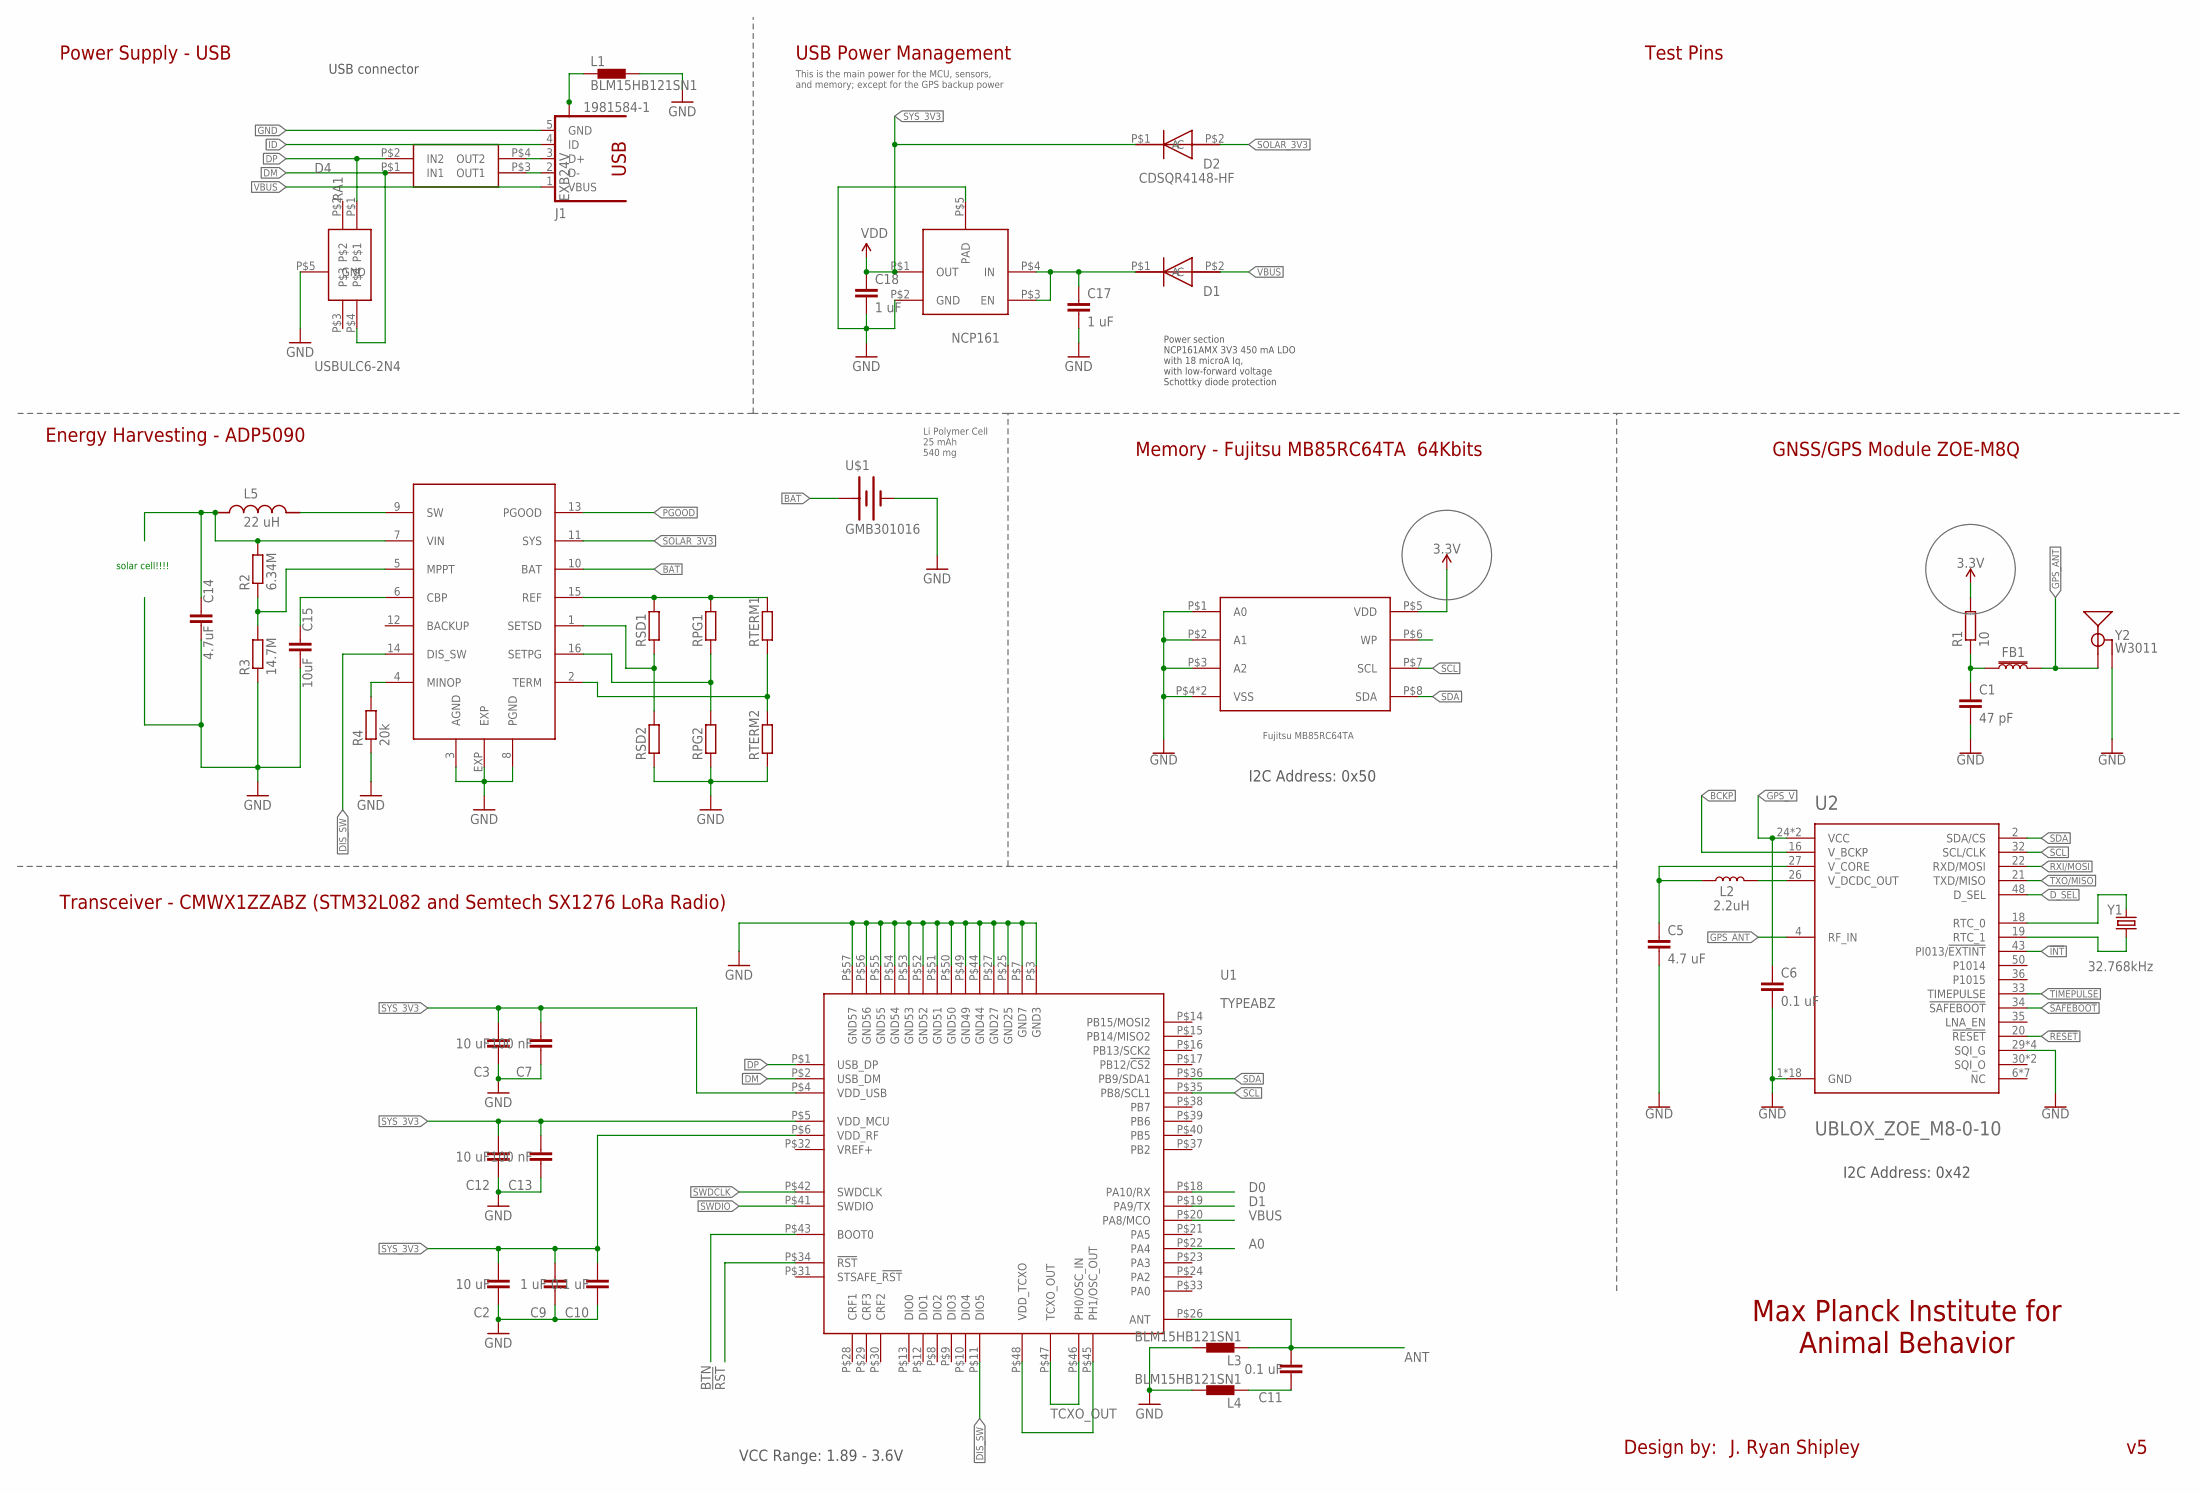
[picture p44: schematic GPS_radiologger_v5.sch]

Parts:
C1: 47 pF; C0201
C2, C3, C12: 10 uF; C0201
C5: 4.7 uF; C0201
C6, C10, C11: 0.1 uF; C0201
C7, C13: 100 nF; C0201
C9: 1 uF; C0201
C14: 4.7uF; C0402
C15: 10uF; C0402
C17, C18: 1 uF; 0402-CAP
D1, D2: CDSQR4148-HF
D4: USBULC6-2N4
FB1: FERRITE_BEAD-120_OHM-0402; 0402
J1: 1981584-1; MPN ZX62-AB-5PA(11)
L1, L3, L4: BLM15HB121SN1; 0402
L2: 2.2uH; 0806
L5: 22 uH; IND_LPS4012-103MRB
R1: 10; R0201
R2: 6.34M; R0201
R3: 14.7M; R0201
R4: 20k; R0201
RA1: EXB24V
RPG1, RPG2: R-EU_R0201; R0201
RSD1: R-EU_R0402; R0402
RSD2: R-EU_R0201; R0201
RTERM1: R-EU_R0402; R0402
RTERM2: R-EU_R0201; R0201
U1: TYPEABZ
U2: UBLOX_ZOE_M8-0-10
U5: NCP161
U$1: GMB301016
U$2: MB85RC64TA; 8-SON_2X3
U$3: ADP5090; LFCSP-16-3X3
Y1: 32.768kHz; CRYSTAL-SMD-3.2X1.5MM
Y2: W3011

Connections:
3.3V: R1.2, U$2.P$5 (VDD)
!INT: U2.43 (PI013/!EXTINT)
!RESET: U2.20 (!RESET)
!RST: U1.P$34 (!RST)
!SAFEBOOT: U2.34 (!SAFEBOOT)
A0: U1.P$22 (PA4)
ANT: C11.1, L4.1
BAT: U$1.+, U$3.10 (BAT)
BCKP: U2.16 (V_BCKP)
BTN: U1.P$43 (BOOT0)
D0: U1.P$18 (PA10/RX)
D1: U1.P$19 (PA9/TX)
DIS_SW: U1.P$11 (DIO5), U$3.14 (DIS_SW)
DM: D4.P$4, RA1.P$1 (IN1), U1.P$2 (USB_DM)
DP: D4.P$1, RA1.P$2 (IN2), U1.P$1 (USB_DP)
D_SEL: U2.48 (D_SEL)
GND: C1.2, C2.1, C3.1, C5.2, C6.2, C7.1, C9.1, C10.1, C12.1, C13.1, C14.2, C15.2, C17.2, C18.2, D4.P$5 (GND), J1.5 (GND), L1.2, L3.2, L4.2, R3.1, R4.1, RPG2.1, RSD2.1, RTERM2.1, U1.P$3 (GND3), U1.P$7 (GND7), U1.P$25 (GND25), U1.P$27 (GND27), U1.P$44 (GND44), U1.P$49 (GND49), U1.P$50 (GND50), U1.P$51 (GND51), U1.P$52 (GND52), U1.P$53 (GND53), U1.P$54 (GND54), U1.P$55 (GND55), U1.P$56 (GND56), U1.P$57 (GND57), U2.1 (GND), U2.3 (GND), U2.5 (GND), U2.7 (GND), U2.8 (GND), U2.9 (GND), U2.10 (GND), U2.11 (GND), U2.12 (GND), U2.17 (GND), U2.23 (GND), U2.29 (SQI_G), U2.31 (SQI_G), U2.37 (GND), U2.38 (GND), U2.39 (GND), U2.40 (GND), U2.41 (GND), U2.44 (GND), U2.46 (SQI_G), U2.47 (SQI_G), U2.49 (GND), U5.P$2 (GND), U5.P$5 (PAD), U$1.-, U$2.P$1 (A0), U$2.P$2 (A1), U$2.P$3 (A2), U$2.P$4 (VSS), U$2.P$9 (VSS), Y2.2 (GND), Y2.3 (GND)
GPS_ANT: FB1.1, U2.4 (RF_IN), Y2.1 (SIGNAL)
GPS_V: C6.1, U2.24 (VCC), U2.25 (VCC)
ID: J1.4 (ID)
unnamed: U1.P$45 (PH1/OSC_OUT), U1.P$48 (VDD_TCXO)
unnamed: L2.2, U2.26 (V_DCDC_OUT)
unnamed: L5.2, U$3.9 (SW)
unnamed: U$3.3 (AGND), U$3.8 (PGND), U$3.EXP
unnamed: R2.1, R3.2, U$3.5 (MPPT)
unnamed: C15.1, U$3.6 (CBP)
unnamed: C1.1, FB1.2, R1.1
unnamed: R4.2, U$3.4 (MINOP)
unnamed: RTERM1.1, RTERM2.2, U$3.2 (TERM)
unnamed: RPG1.1, RPG2.2, U$3.16 (SETPG)
unnamed: C5.1, L2.1, U2.27 (V_CORE)
unnamed: U2.18 (RTC_0), Y1.P$2 (2)
unnamed: U2.19 (RTC_1), Y1.P$1 (1)
unnamed: RSD1.1, RSD2.2, U$3.1 (SETSD)
unnamed: RPG1.2, RSD1.2, RTERM1.2, U$3.15 (REF)
unnamed: J1.3 (D+), RA1.P$4 (OUT2)
unnamed: C11.2, L3.1, U1.P$26 (ANT)
unnamed: J1.2 (D-), RA1.P$3 (OUT1)
unnamed: C17.1, D1.P$1 (C), U5.P$3 (EN), U5.P$4 (IN)
PGOOD: U$3.13 (PGOOD)
RXI/MOSI: U2.22 (RXD/MOSI)
SCL: U1.P$35 (PB8/SCL1), U2.32 (SCL/CLK), U$2.P$7 (SCL)
SDA: U1.P$36 (PB9/SDA1), U2.2 (SDA/CS), U$2.P$8 (SDA)
SOLAR_3V3: D2.P$2 (A), U$3.11 (SYS)
SWDCLK: U1.P$42 (SWDCLK)
SWDIO: U1.P$41 (SWDIO)
SYS_3V3: C2.2, C3.2, C7.2, C9.2, C10.2, C12.2, C13.2, C18.1, D2.P$1 (C), U1.P$4 (VDD_USB), U1.P$5 (VDD_MCU), U1.P$6 (VDD_RF), U5.P$1 (OUT)
TCXO_OUT: U1.P$46 (PH0/OSC_IN), U1.P$47 (TCXO_OUT)
TIMEPULSE: U2.33 (TIMEPULSE)
TXO/MISO: U2.21 (TXD/MISO)
USB_SHIELD: J1.S1, J1.S2, J1.S3, J1.S4, L1.1
VBUS: D1.P$2 (A), J1.1 (VBUS), U1.P$20 (PA8/MCO)
VIN: C14.1, L5.1, R2.2, U$3.7 (VIN)
VREF+: U1.P$32 (VREF+)

Notes on the sheet:
GNSS/GPS Module ZOE-M8Q
VCC Range: 1.89 - 3.6V
I2C Address: 0x42
Max Planck Institute for Animal Behavior
Transceiver - CMWX1ZZABZ (STM32L082 and Semtech SX1276 LoRa Radio)
Power Supply - USB
Energy Harvesting - ADP5090
USB Power Management
I2C Address: 0x50
Memory - Fujitsu MB85RC64TA 64Kbits
This is the main power for the MCU, sensors, and memory; except for the GPS backup power
Design by:
J. Ryan Shipley
Power section NCP161AMX 3V3 450 mA LDO with 18 microA Iq, with low-forward voltage Schottky diode protection
USB connector
solar cell!!!!
Li Polymer Cell 25 mAh 540 mg
Test Pins

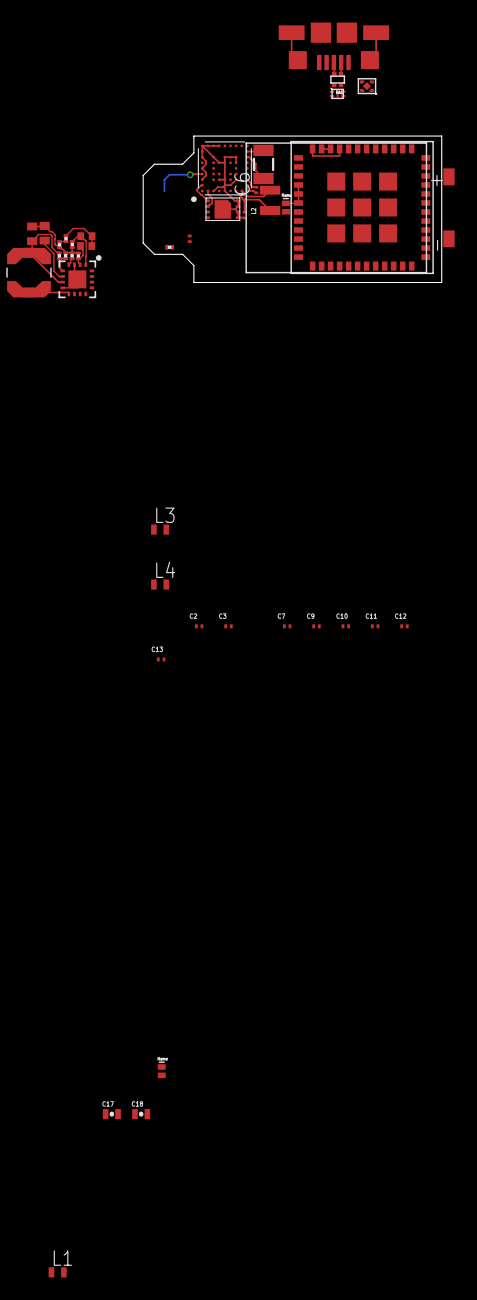
[picture p45: board GPS_radiologger_v5.brd from above]

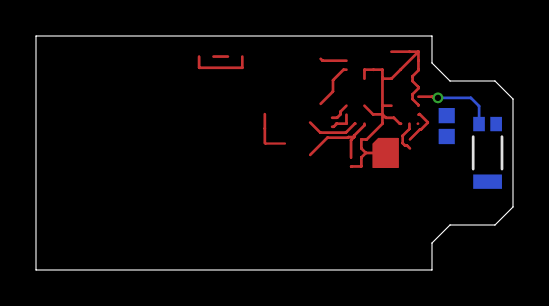
[picture p46: board GPS_radiologger_v5.brd from below]

Board: 2 copper layers, 26.5 x 13.0 mm, 44 parts (2 on the bottom side), 36 nets.
