trollock/Solar_LoRa_GPS/EAGLE/early versions/GPS_radiologger_v1.brd

## EAGLE design EAGLE/early versions/GPS_radiologger_v1.brd (2019-11-02, an earlier design)

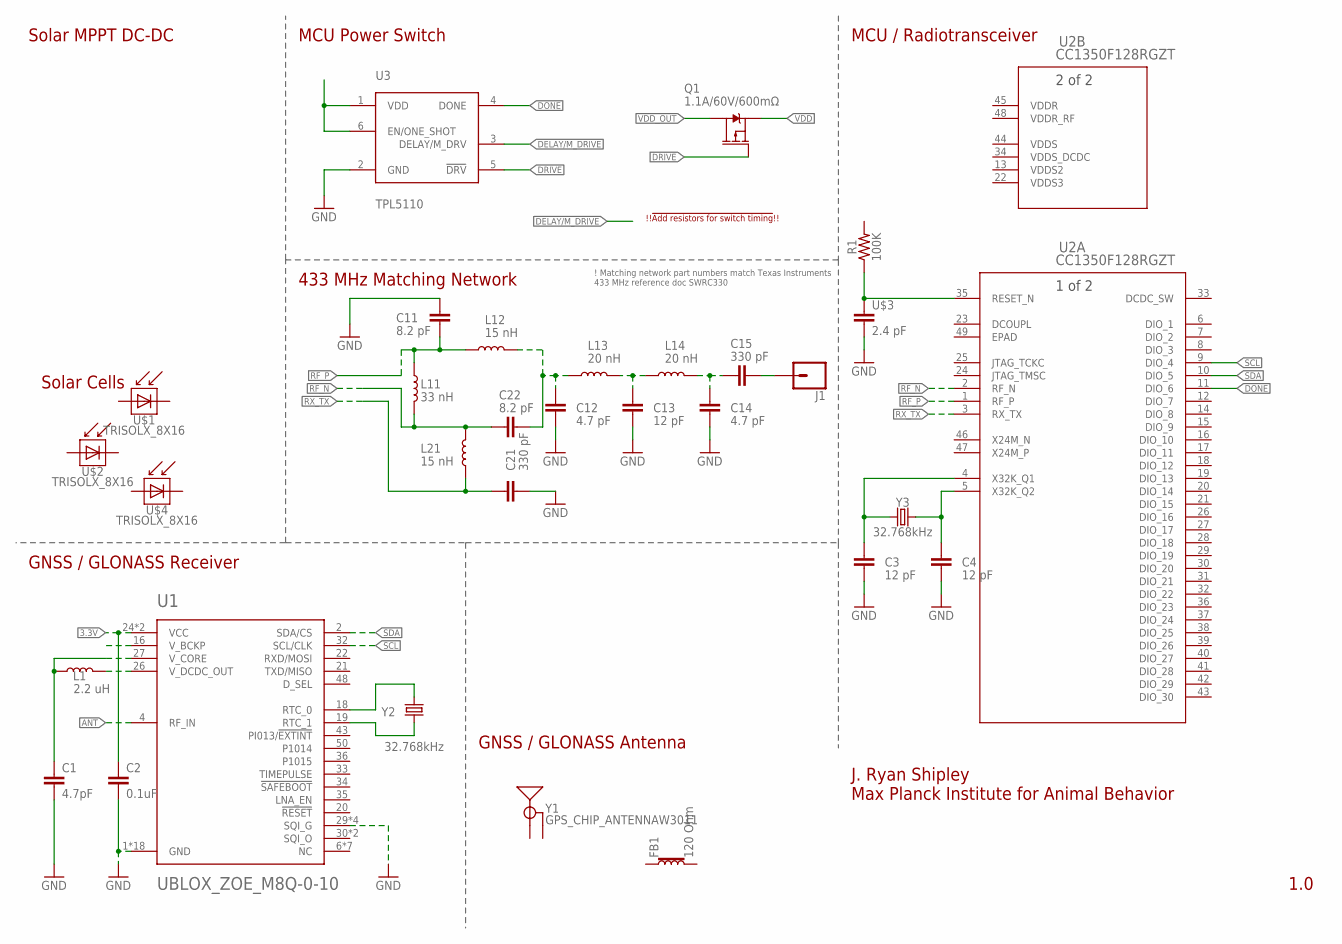
[picture p47: schematic GPS_radiologger_v1.sch]

Parts:
C1: 4.7pF; 0603
C2: 0.1uF; 0402
C3, C4, C13: 12 pF; 0402-TIGHT
C11, C22: 8.2 pF; 0402-TIGHT
C12, C14: 4.7 pF; 0402-TIGHT
C15, C21: 330 pF; 0402-TIGHT
FB1: 120 Ohm; 0402
J1: CONN_01OFFSET; 1X01_OFFSET
L1: 2.2 uH; 0806
L11: 33 nH; 0402_MURATA
L12, L21: 15 nH; 0402_MURATA
L13, L14: 20 nH; 0402_MURATA
Q1: 1.1A/60V/600mΩ; SOT23-3
R1: 100K; 0402
U1: UBLOX_ZOE_M8Q-0-10; UBLOX_ZOE_M8-0-10
U2: CC1350F128RGZT; RGZ48
U3: TPL5110; SOT23-6
U$1, U$2, U$4: TRISOLX_8X16
U$3: 2.4 pF; 0402_MURATA
Y1: GPS_CHIP_ANTENNAW3011; W3011
Y2, Y3: 32.768kHz; CRYSTAL-SMD-3.2X1.5MM

Connections:
3.3V: C2.1, U1.24 (VCC), U1.25 (VCC)
ANT: U1.4 (RF_IN)
DELAY/M_DRIVE: U3.3 (DELAY/M_DRV)
DONE: U2.11 (DIO_6), U3.4 (DONE)
DRIVE: Q1.1 (G), U3.5 (!DRV)
GND: C1.2, C2.2, C3.2, C4.2, C11.2, C12.2, C13.2, C14.2, C21.2, U1.1 (GND), U1.3 (GND), U1.5 (GND), U1.7 (GND), U1.8 (GND), U1.9 (GND), U1.10 (GND), U1.11 (GND), U1.12 (GND), U1.17 (GND), U1.23 (GND), U1.29 (SQI_G), U1.31 (SQI_G), U1.37 (GND), U1.38 (GND), U1.39 (GND), U1.40 (GND), U1.41 (GND), U1.44 (GND), U1.46 (SQI_G), U1.47 (SQI_G), U1.49 (GND), U3.2 (GND), U$3.P$2 (2)
unnamed: C1.1, L1.1, U1.27 (V_CORE)
unnamed: L1.2, U1.26 (V_DCDC_OUT)
unnamed: U1.18 (RTC_0), Y2.P$2 (2)
unnamed: U1.19 (RTC_1), Y2.P$1 (1)
unnamed: U3.1 (VDD), U3.6 (EN/ONE_SHOT)
unnamed: C13.1, L13.P$2 (2), L14.P$1 (1)
unnamed: C14.1, C15.1, L14.P$2 (2)
unnamed: C12.1, C22.1, L12.P$2 (2), L13.P$1 (1)
unnamed: C15.2, J1.1
unnamed: C3.1, U2.4 (X32K_Q1), Y3.P$1 (1)
unnamed: C4.1, U2.5 (X32K_Q2), Y3.P$2 (2)
unnamed: R1.1, U2.35 (RESET_N), U$3.P$1 (1)
RF_N: C22.2, L11.P$2 (2), L21.P$2 (2), U2.2 (RF_N)
RF_P: C11.1, L11.P$1 (1), L12.P$1 (1), U2.1 (RF_P)
RX_TX: C21.1, L21.P$1 (1), U2.3 (RX_TX)
SCL: U1.32 (SCL/CLK), U2.9 (DIO_4)
SDA: U1.2 (SDA/CS), U2.10 (DIO_5)
VDD: Q1.2 (S)
VDDR: U2.45 (VDDR)
VDDR_RF: U2.48 (VDDR_RF)
VDDS: U2.44 (VDDS)
VDDS2: U2.13 (VDDS2)
VDDS3: U2.22 (VDDS3)
VDDS_DCDC: U2.34 (VDDS_DCDC)
VDD_OUT: Q1.3 (D)

Notes on the sheet:
MCU Power Switch
GNSS / GLONASS Antenna
GNSS / GLONASS Receiver
MCU / Radiotransceiver
Solar MPPT DC-DC
Solar Cells
433 MHz Matching Network
! Matching network part numbers match Texas Instruments 433 MHz reference doc SWRC330
J. Ryan Shipley Max Planck Institute for Animal Behavior
!!!Add resistors for switch timing!!!
1.0

Board: 2 copper layers, 31 parts (1 on the bottom side), 21 nets, no tracks yet.
