trollock/Solar_LoRa_GPS/EAGLE/early versions/GPS_radiologger_v14.brd

## EAGLE design EAGLE/early versions/GPS_radiologger_v14.brd (2020-06-17)

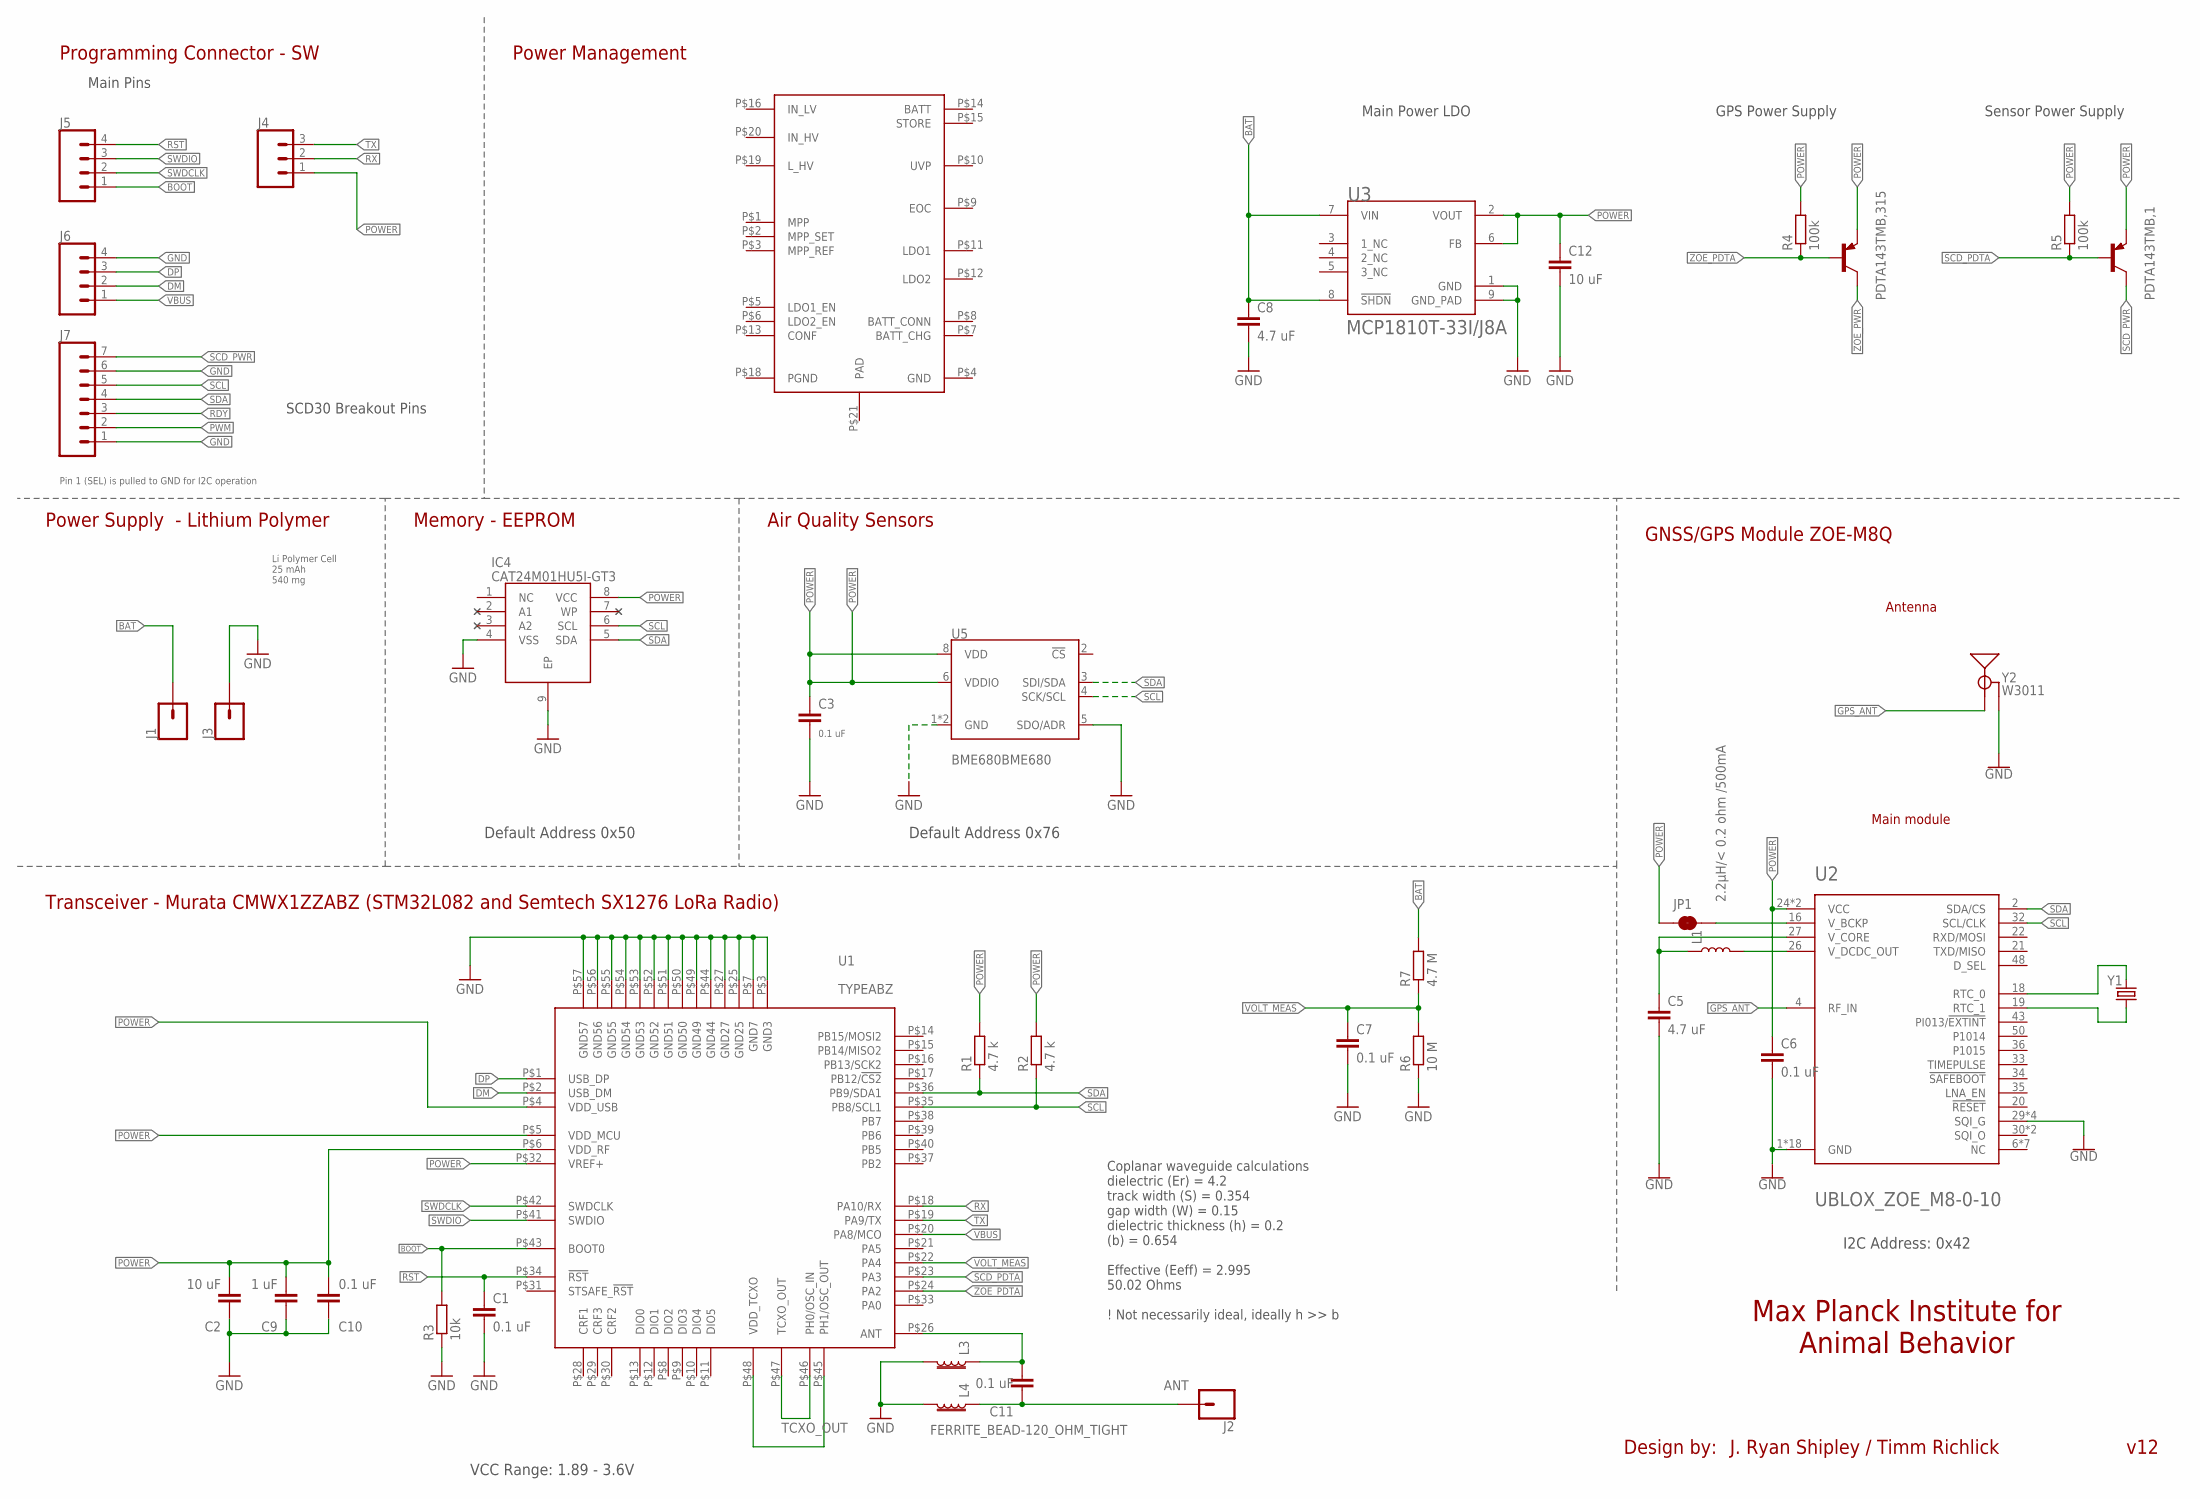
[picture p48: schematic GPS_radiologger_v14.sch]

Parts:
C1, C3, C6, C7, C10, C11: 0.1 uF; C0201
C2, C12: 10 uF; C0201
C5, C8: 4.7 uF; C0201
C9: 1 uF; C0201
IC4: CAT24M01HU5I-GT3; SON50P300X200X55-9N
J1, J3: CONN_01PTH_NO_SILK_YES_STOP; 1X01_NO_SILK
J2: CONN_01PTH_NO_SILK_SMALL; 1X01_SMALL
J4: CONN_031X03_1.27_NO_SILK; 1X03_1.27MM_NO_SILK
J5, J6: CONN_041.27MM_NO_SILK; 1X04_1.27MM_NO_SILK
J7: CONN_07NO_SILK; 1X07_NO_SILK
JP1: JUMPER-SMT_2_NC_TRACE_NO-SILK; SMT-JUMPER_2_NC_TRACE_NO-SILK
L1: 2.2µH/< 0.2 ohm /500mA; 0805
L3, L4: FERRITE_BEAD-120_OHM_TIGHT; 0402-TIGHT
PDTA143TMB,1, PDTA143TMB,315: TINYPICO-PNPAMB; SOT883(B)
R1, R2: 4.7 k; R0201
R3: 10k; R0201
R4, R5: 100k; R0201
R6: 10 M; R0201
R7: 4.7 M; R0201
U1: TYPEABZ
U2: UBLOX_ZOE_M8-0-10
U3: MICROCHIP_MCP1810T-33I-J8AMICROCHIP_MCP1810T-33I-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; MICROCHIP_MCP1810T-33I-J8A_0
U4: SPV1050
U5: BME680BME680; LGA3.0X3.0
Y1: 32.768kHz; CRYSTAL-SMD-1.0X1.2MM
Y2: W3011

Connections:
ANT: C11.1, J2.P$1, L4.1
BAT: C8.1, J1.1, R7.2, U3.7 (VIN), U3.8 (!SHDN!)
BOOT: J5.1, R3.2, U1.P$43 (BOOT0)
DM: J6.2, U1.P$2 (USB_DM)
DP: J6.3, U1.P$1 (USB_DP)
GND: C1.2, C2.1, C3.2, C5.2, C6.2, C7.2, C8.2, C9.1, C10.1, C12.2, IC4.4 (VSS), IC4.9 (EP), J3.1, J6.4, J7.1, J7.6, L3.2, L4.2, R3.1, R6.1, U1.P$3 (GND3), U1.P$7 (GND7), U1.P$25 (GND25), U1.P$27 (GND27), U1.P$44 (GND44), U1.P$49 (GND49), U1.P$50 (GND50), U1.P$51 (GND51), U1.P$52 (GND52), U1.P$53 (GND53), U1.P$54 (GND54), U1.P$55 (GND55), U1.P$56 (GND56), U1.P$57 (GND57), U2.1 (GND), U2.3 (GND), U2.5 (GND), U2.7 (GND), U2.8 (GND), U2.9 (GND), U2.10 (GND), U2.11 (GND), U2.12 (GND), U2.17 (GND), U2.23 (GND), U2.29 (SQI_G), U2.31 (SQI_G), U2.37 (GND), U2.38 (GND), U2.39 (GND), U2.40 (GND), U2.41 (GND), U2.44 (GND), U2.46 (SQI_G), U2.47 (SQI_G), U2.49 (GND), U3.1 (GND), U3.9 (GND_PAD), U5.1 (GND), U5.5 (SDO/ADR), U5.7 (GND), Y2.2 (GND), Y2.3 (GND)
GPS_ANT: U2.4 (RF_IN), Y2.1 (SIGNAL)
IN_HV: U4.P$20 (IN_HV)
IN_LV: U4.P$16 (IN_LV)
L_HV: U4.P$19 (L_HV)
unnamed: U1.P$45 (PH1/OSC_OUT), U1.P$48 (VDD_TCXO)
unnamed: JP1.2, U2.16 (V_BCKP)
unnamed: C5.1, L1.1, U2.27 (V_CORE)
unnamed: L1.2, U2.26 (V_DCDC_OUT)
unnamed: U2.18 (RTC_0), Y1.P$2 (2)
unnamed: U2.19 (RTC_1), Y1.P$1 (1)
unnamed: C11.2, L3.1, U1.P$26 (ANT)
POWER: C2.2, C3.1, C6.1, C9.2, C10.2, C12.1, IC4.8 (VCC), J4.1, JP1.1, PDTA143TMB,1.2 (E), PDTA143TMB,315.2 (E), R1.2, R2.2, R4.2, R5.2, U1.P$4 (VDD_USB), U1.P$5 (VDD_MCU), U1.P$6 (VDD_RF), U1.P$32 (VREF+), U2.24 (VCC), U2.25 (VCC), U3.2 (VOUT), U3.6 (FB), U5.6 (VDDIO), U5.8 (VDD)
PWM: J7.2
RDY: J7.3
RST: C1.1, J5.4, U1.P$34 (!RST)
RX: J4.2, U1.P$18 (PA10/RX)
SCD_PDTA: PDTA143TMB,1.1 (B), R5.1, U1.P$23 (PA3)
SCD_PWR: J7.7, PDTA143TMB,1.3 (C)
SCL: IC4.6 (SCL), J7.5, R2.1, U1.P$35 (PB8/SCL1), U2.32 (SCL/CLK), U5.4 (SCK/SCL)
SDA: IC4.5 (SDA), J7.4, R1.1, U1.P$36 (PB9/SDA1), U2.2 (SDA/CS), U5.3 (SDI/SDA)
SWDCLK: J5.2, U1.P$42 (SWDCLK)
SWDIO: J5.3, U1.P$41 (SWDIO)
TCXO_OUT: U1.P$46 (PH0/OSC_IN), U1.P$47 (TCXO_OUT)
TX: J4.3, U1.P$19 (PA9/TX)
VBUS: J6.1, U1.P$20 (PA8/MCO)
VOLT_MEAS: C7.1, R6.2, R7.1, U1.P$22 (PA4)
ZOE_PDTA: PDTA143TMB,315.1 (B), R4.1, U1.P$24 (PA2)
ZOE_PWR: PDTA143TMB,315.3 (C)

Notes on the sheet:
GNSS/GPS Module ZOE-M8Q
VCC Range: 1.89 - 3.6V
I2C Address: 0x42
Max Planck Institute for Animal Behavior
Transceiver - Murata CMWX1ZZABZ (STM32L082 and Semtech SX1276 LoRa Radio)
Programming Connector - SW
Power Supply - Lithium Polymer
Design by:
J. Ryan Shipley / Timm Richlick
v12
Li Polymer Cell 25 mAh 540 mg
Power Management
Main Power LDO
Air Quality Sensors
Memory - EEPROM
Antenna
GPS Power Supply
Main module
Coplanar waveguide calculations dielectric (Er) = 4.2 track width (S) = 0.354 gap width (W) = 0.15 dielectric thickness (h) = 0.2 (b) = 0.654 Effective (Eeff) = 2.995 50.02 Ohms ! Not necessarily ideal, ideally h >> b
Sensor Power Supply
SCD30 Breakout Pins
Main Pins
Pin 1 (SEL) is pulled to GND for I2C operation
Default Address 0x76
Default Address 0x50

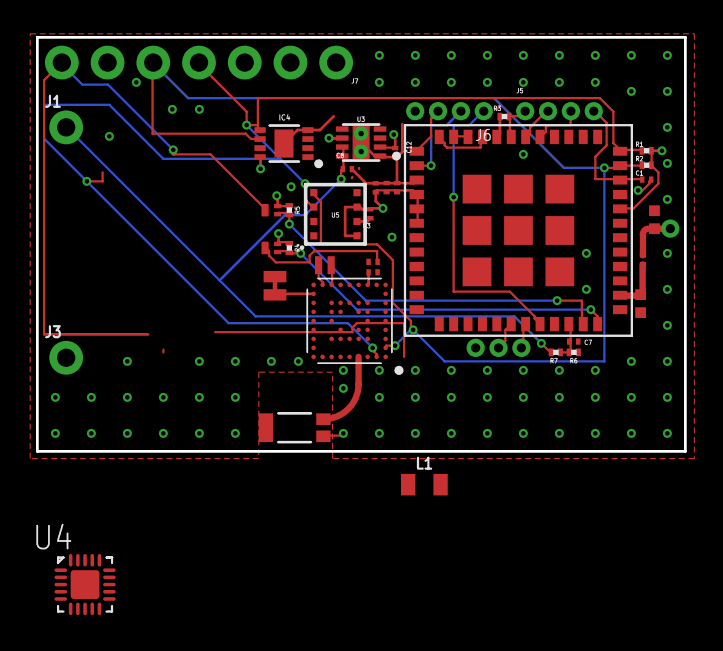
[picture p49: board GPS_radiologger_v14.brd from above]

Board: 4 copper layers, 36.0 x 23.0 mm, 39 parts (0 on the bottom side), 28 nets.
