trollock/Solar_LoRa_GPS/EAGLE/early versions/GPS_radiologger_v3.brd

## EAGLE design EAGLE/early versions/GPS_radiologger_v3.brd (2019-12-12, an earlier design)

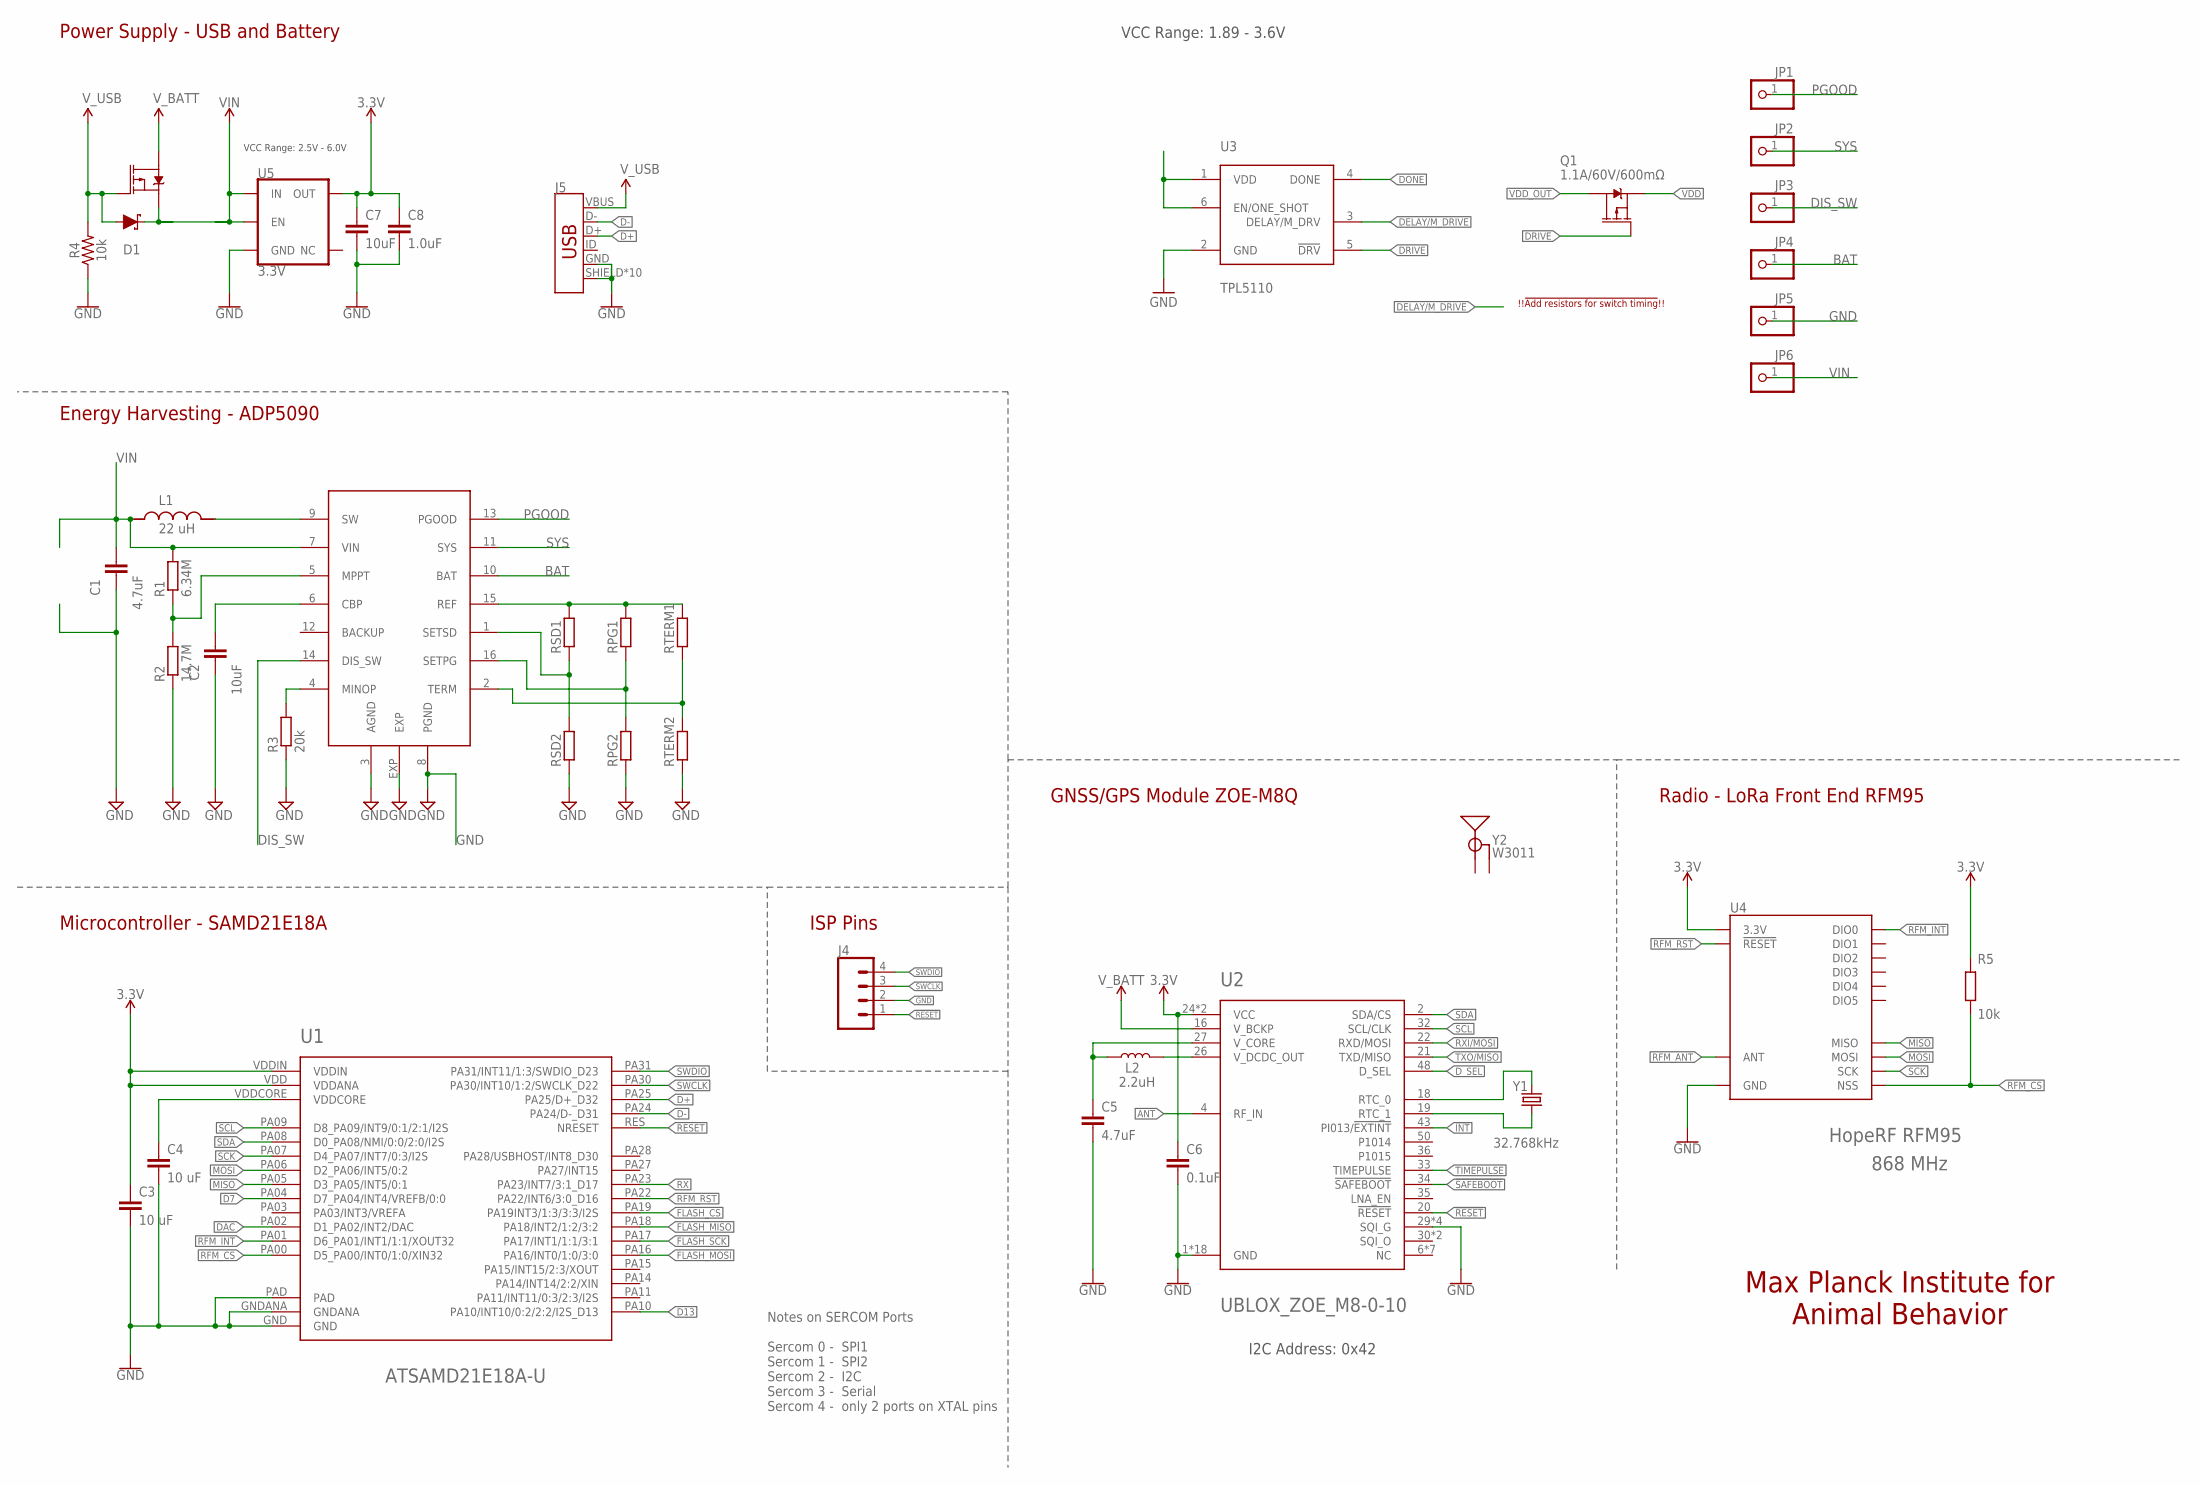
[picture p50: schematic GPS_radiologger_v3.sch]

Parts:
C1: 4.7uF; C0402
C2: 10uF; C0402
C3, C4: 10 uF; C0201
C5: 4.7uF; 0603
C6: 0.1uF; 0603
C7: 10uF; 0603
C8: 1.0uF; 0402
D1: 1A/23V/620mV; SOD-323
J4: CONN_041.27MM_NO_SILK; 1X04_1.27MM_NO_SILK
J5: USB_MICRO-B_HALF_PTH_MILL; USB-MICROB-PTH-MILL
JP1, JP2, JP3, JP4, JP5, JP6: PINHD-1X1; 1X01
L1: 22 uH; IND_LPS4012-103MRB
L2: 2.2uH; 0806
Q1: 1.1A/60V/600mΩ; SOT23-3
Q2: 3.1A/30V/105mΩ; SOT23-3
R1: 6.34M; R0201
R2: 14.7M; R0201
R3: 20k; R0201
R4: 10k; 0402
R5: 10k; R0201
RPG1, RPG2: R-EU_R0201; R0201
RSD1: R-EU_R0402; R0402
RSD2: R-EU_R0201; R0201
RTERM1: R-EU_R0402; R0402
RTERM2: R-EU_R0201; R0201
U1: ATSAMD21E18A-U; QFN-32_SAMD
U2: UBLOX_ZOE_M8-0-10
U3: TPL5110; SOT23-6
U4: RFM95W; RFM95/96/97/98W
U5: 3.3V; SOT23-5
U$2: ADP5090; LFCSP-16-3X3
Y1: 32.768kHz; CRYSTAL-SMD-3.2X1.5MM
Y2: W3011

Connections:
3.3V: C3.1, C6.1, C7.1, C8.1, R5.2, U1.VDD (VDDANA), U1.VDDIN, U2.24 (VCC), U2.25 (VCC), U4.3.3V, U5.5 (OUT)
!INT: U2.43 (PI013/!EXTINT)
!RESET: J4.1, U2.20 (!RESET)
!SAFEBOOT: U2.34 (!SAFEBOOT)
ANT: U2.4 (RF_IN)
BAT: JP4.1, U$2.10 (BAT)
D7: U1.PA04 (D7_PA04/INT4/VREFB/0:0)
D13: U1.PA10 (PA10/INT10/0:2/2:2/I2S_D13)
D+: J5.D+, U1.PA25 (PA25/D+_D32)
D-: J5.D-, U1.PA24 (PA24/D-_D31)
DAC: U1.PA02 (D1_PA02/INT2/DAC)
DELAY/M_DRIVE: U3.3 (DELAY/M_DRV)
DIS_SW: JP3.1, U$2.14 (DIS_SW)
DONE: U3.4 (DONE)
DRIVE: Q1.1 (G), U3.5 (!DRV)
D_SEL: U2.48 (D_SEL)
FLASH_CS: U1.PA19 (PA19INT3/1:3/3:3/I2S)
FLASH_MISO: U1.PA18 (PA18/INT2/1:2/3:2)
FLASH_MOSI: U1.PA16 (PA16/INT0/1:0/3:0)
FLASH_SCK: U1.PA17 (PA17/INT1/1:1/3:1)
GND: C1.2, C2.2, C3.2, C4.2, C5.2, C6.2, C7.2, C8.2, J4.2, J5.GND, J5.SHIELD, J5.SHIELD2 (SHIELD), J5.SHIELD3 (SHIELD), J5.SHIELD4 (SHIELD), J5.SHIELD5 (SHIELD), J5.SHIELD6 (SHIELD), J5.SHIELD7 (SHIELD), J5.SHIELD8 (SHIELD), J5.SHIELD9 (SHIELD), J5.SHIELD10 (SHIELD), JP5.1, R2.1, R3.1, R4.1, RPG2.1, RSD2.1, RTERM2.1, U1.GND, U1.GNDANA, U1.PAD, U2.1 (GND), U2.3 (GND), U2.5 (GND), U2.7 (GND), U2.8 (GND), U2.9 (GND), U2.10 (GND), U2.11 (GND), U2.12 (GND), U2.17 (GND), U2.23 (GND), U2.29 (SQI_G), U2.31 (SQI_G), U2.37 (GND), U2.38 (GND), U2.39 (GND), U2.40 (GND), U2.41 (GND), U2.44 (GND), U2.46 (SQI_G), U2.47 (SQI_G), U2.49 (GND), U3.2 (GND), U4.GND@1 (GND), U4.GND@2 (GND), U4.GND@3 (GND), U5.2 (GND), U$2.3 (AGND), U$2.8 (PGND), U$2.EXP
MISO: U1.PA05 (D3_PA05/INT5/0:1), U4.MISO
MOSI: U1.PA06 (D2_PA06/INT5/0:2), U4.MOSI
unnamed: R1.1, R2.2, U$2.5 (MPPT)
unnamed: C2.1, U$2.6 (CBP)
unnamed: L1.2, U$2.9 (SW)
unnamed: L2.2, U2.26 (V_DCDC_OUT)
unnamed: R3.2, U$2.4 (MINOP)
unnamed: U3.1 (VDD), U3.6 (EN/ONE_SHOT)
unnamed: RTERM1.1, RTERM2.2, U$2.2 (TERM)
unnamed: RPG1.1, RPG2.2, U$2.16 (SETPG)
unnamed: RSD1.1, RSD2.2, U$2.1 (SETSD)
unnamed: C4.1, U1.VDDCORE
unnamed: RPG1.2, RSD1.2, RTERM1.2, U$2.15 (REF)
unnamed: C5.1, L2.1, U2.27 (V_CORE)
unnamed: U2.18 (RTC_0), Y1.P$2 (2)
unnamed: U2.19 (RTC_1), Y1.P$1 (1)
PGOOD: JP1.1, U$2.13 (PGOOD)
RESET: U1.RES (NRESET)
RFM_ANT: U4.ANT
RFM_CS: R5.1, U1.PA00 (D5_PA00/INT0/1:0/XIN32), U4.NSS
RFM_INT: U1.PA01 (D6_PA01/INT1/1:1/XOUT32), U4.DIO0
RFM_RST: U1.PA22 (PA22/INT6/3:0_D16), U4.!RESET
RX: U1.PA23 (PA23/INT7/3:1_D17)
RXI/MOSI: U2.22 (RXD/MOSI)
SCK: U1.PA07 (D4_PA07/INT7/0:3/I2S), U4.SCK
SCL: U1.PA09 (D8_PA09/INT9/0:1/2:1/I2S), U2.32 (SCL/CLK)
SDA: U1.PA08 (D0_PA08/NMI/0:0/2:0/I2S), U2.2 (SDA/CS)
SWCLK: J4.3, U1.PA30 (PA30/INT10/1:2/SWCLK_D22)
SWDIO: J4.4, U1.PA31 (PA31/INT11/1:3/SWDIO_D23)
SYS: JP2.1, U$2.11 (SYS)
TIMEPULSE: U2.33 (TIMEPULSE)
TXO/MISO: U2.21 (TXD/MISO)
VDD: Q1.2 (S)
VDD_OUT: Q1.3 (D)
VIN: C1.1, D1.C, JP6.1, L1.1, Q2.2 (S), R1.2, U5.1 (IN), U5.3 (EN), U$2.7 (VIN)
V_BATT: Q2.3 (D), U2.16 (V_BCKP)
V_USB: D1.A, J5.VBUS, Q2.1 (G), R4.2

Notes on the sheet:
!!!Add resistors for switch timing!!!
GNSS/GPS Module ZOE-M8Q
VCC Range: 2.5V - 6.0V
VCC Range: 1.89 - 3.6V
I2C Address: 0x42
Max Planck Institute for Animal Behavior
Microcontroller - SAMD21E18A
Radio - LoRa Front End RFM95
Power Supply - USB and Battery
Energy Harvesting - ADP5090
868 MHz
HopeRF RFM95
Notes on SERCOM Ports Sercom 0 - SPI1 Sercom 1 - SPI2 Sercom 2 - I2C Sercom 3 - Serial Sercom 4 - only 2 ports on XTAL pins
ISP Pins

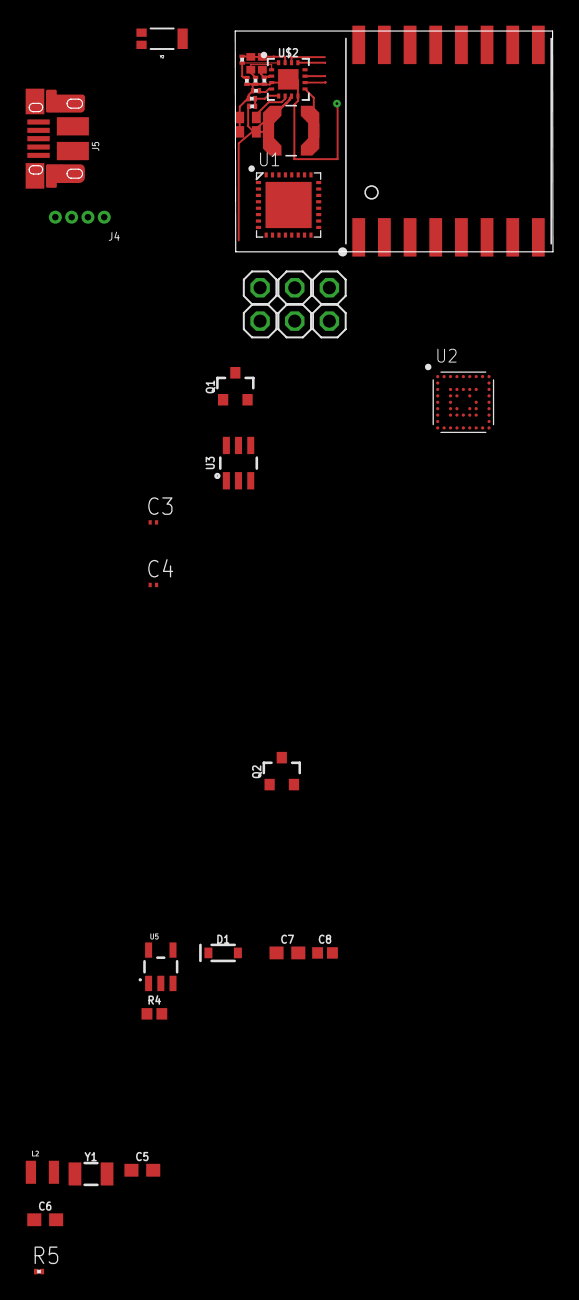
[picture p51: board GPS_radiologger_v3.brd from above]

Board: 2 copper layers, 40 parts (0 on the bottom side), 37 nets.
