trollock/Solar_LoRa_GPS/EAGLE/early versions/TASC_cells_board.brd

## EAGLE design EAGLE/early versions/TASC_cells_board.brd (2019-11-02)

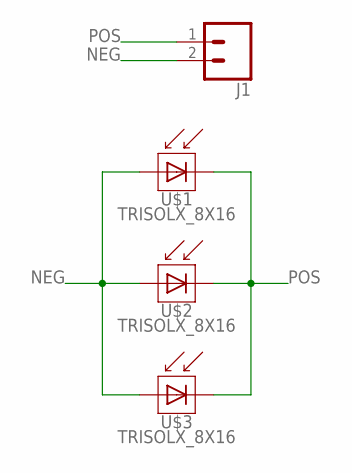
[picture p52: schematic TASC_cells_board.sch]

Parts:
J1: CONN_02; 1X02
U$1, U$2, U$3: TRISOLX_8X16

Connections:
NEG: J1.2, U$1.P$2 (A), U$2.P$2 (A), U$3.P$2 (A)
POS: J1.1, U$1.P$3 (C), U$2.P$3 (C), U$3.P$3 (C)

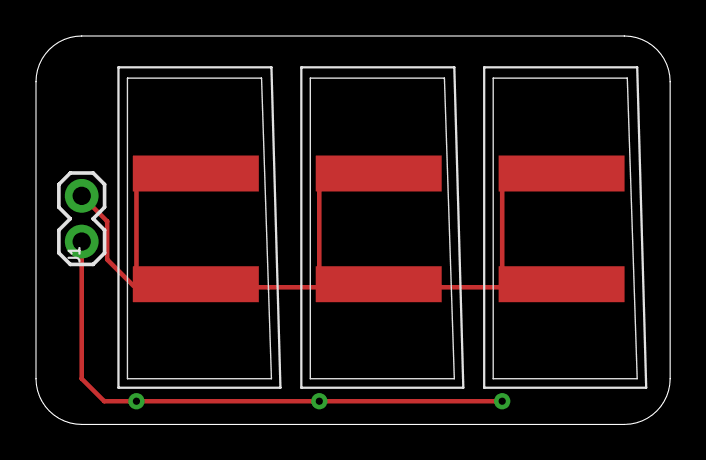
[picture p53: board TASC_cells_board.brd from above]

Board: 2 copper layers, 35.2 x 21.6 mm, 4 parts (0 on the bottom side), 2 nets.
