trollock/Solar_LoRa_GPS/Hardware/GNSS_Chip_Antenna_Evaluation_Board/GNSS_Chip_Antenna_Evaluation_Board.sch

## EAGLE design Hardware/GNSS_Chip_Antenna_Evaluation_Board/GNSS_Chip_Antenna_Evaluation_Board.sch (2019-11-02)

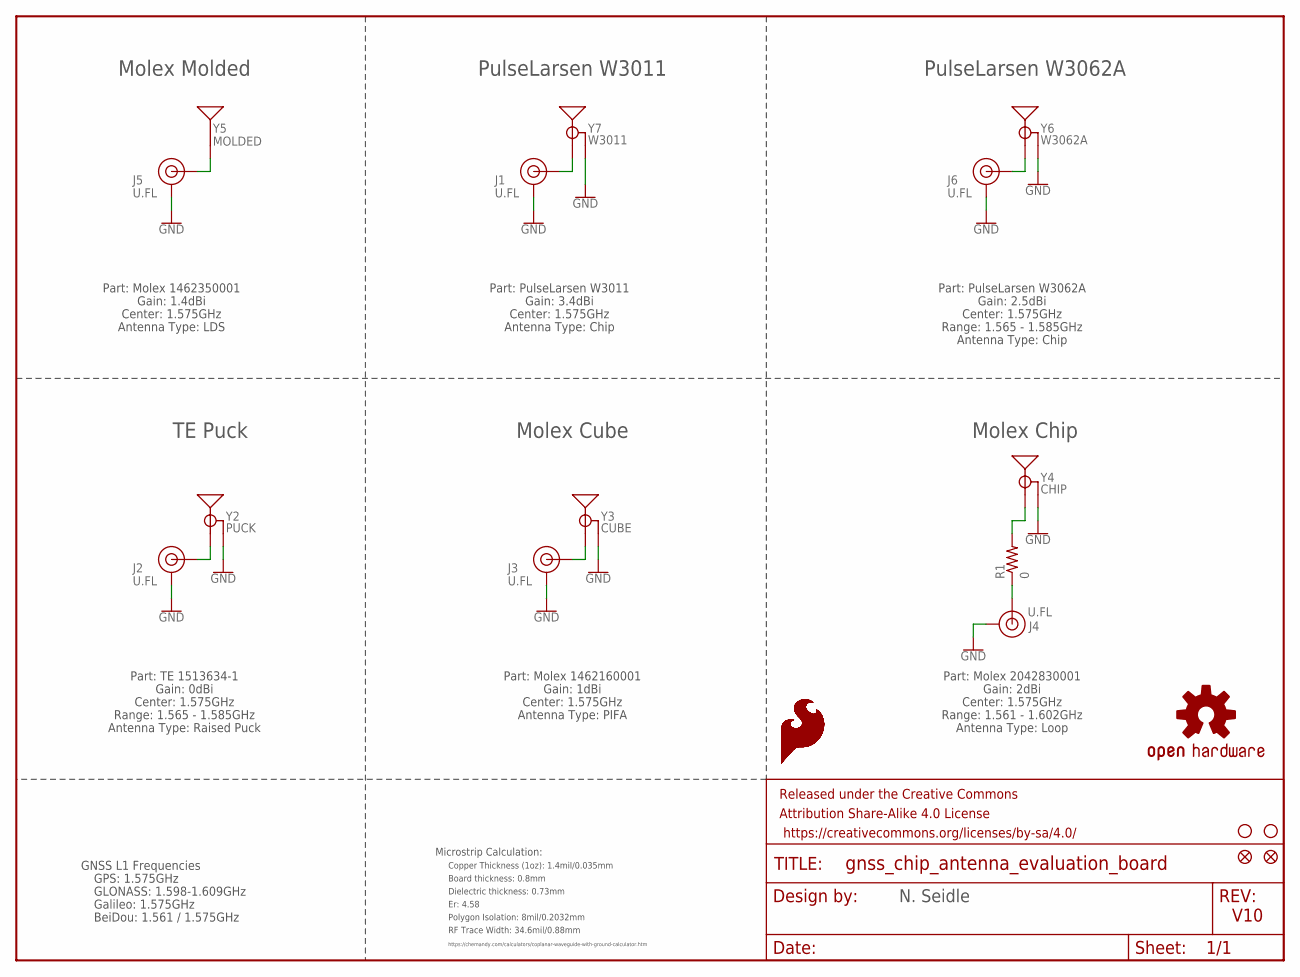
[picture p54: schematic GNSS_Chip_Antenna_Evaluation_Board.sch]

Parts:
FRAME1: FRAME-LETTER; CREATIVE_COMMONS
J1, J2, J3, J4, J5, J6: U.FL
JP5, JP6: STAND-OFF
JP8, JP9: FIDUCIAL1X2; FIDUCIAL-1X2
LOGO1, LOGO2, LOGO3, LOGO4, LOGO5, LOGO6: SFE_LOGO_FLAME.1EXP; SFE_LOGO_FLAME_COPPER_EXPOSED_.1
R1: 0; 0402
U$16: OSHW-LOGOS; OSHW-LOGO-S
Y2: PUCK; TE_PUCK
Y3: CUBE; MOLEX_GNSS_CUBE
Y4: CHIP; MOLEX_GNSS_CHIP
Y5: MOLDED; MLOEX_GNSS_MOLDED
Y6: W3062A
Y7: W3011

Connections:
FEED1: J1.FEED (SIGNAL), Y7.1 (SIGNAL)
FEED2: J5.FEED (SIGNAL), Y5.FEED
FEED3: J2.FEED (SIGNAL), Y2.S (SIGNAL)
FEED4: J3.FEED (SIGNAL), Y3.FEED (SIGNAL)
FEED5: J4.FEED (SIGNAL), R1.1
FEED6: J6.FEED (SIGNAL), Y6.FEED (SIGNAL)
GND: J1.1 (GND), J2.1 (GND), J3.1 (GND), J4.1 (GND), J5.1 (GND), J6.1 (GND), Y2.1 (GND), Y3.GND, Y4.1 (GND), Y6.GND, Y7.2 (GND)
unnamed: R1.2, Y4.FEED (SIGNAL)

Notes on the sheet:
V10
Board thickness: 0.8mm
Er: 4.58
Copper Thickness (1oz): 1.4mil/0.035mm
RF Trace Width: 34.6mil/0.88mm
Polygon Isolation: 8mil/0.2032mm
Dielectric thickness: 0.73mm
https://chemandy.com/calculators/coplanar-waveguide-with-ground-calculator.htm
Microstrip Calculation:
Center: 1.575GHz
Gain: 1.4dBi
Part: Molex 1462350001
Range: 1.565 - 1.585GHz
Gain: 2.5dBi
Part: PulseLarsen W3062A
Gain: 3.4dBi
Part: PulseLarsen W3011
Gain: 1dBi
Part: Molex 1462160001
Gain: 0dBi
Part: TE 1513634-1
Range: 1.561 - 1.602GHz
Gain: 2dBi
Part: Molex 2042830001
Antenna Type: Chip
Antenna Type: Loop
Antenna Type: PIFA
Antenna Type: Raised Puck
Antenna Type: LDS
GPS: 1.575GHz
GLONASS: 1.598-1.609GHz
Galileo: 1.575GHz
BeiDou: 1.561 / 1.575GHz
Molex Molded
Molex Chip
Molex Cube
PulseLarsen W3062A
PulseLarsen W3011
TE Puck
N. Seidle
GNSS L1 Frequencies
