trollock/Solar_LoRa_GPS/Hardware/GPS_Transistor/transistor.sch

## EAGLE design Hardware/GPS_Transistor/transistor.sch (2020-06-16)

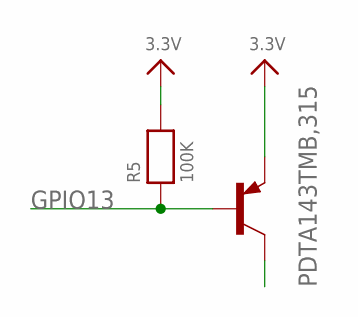
[picture p55: schematic transistor.sch]

Parts:
PDTA143TMB,315: TINYPICO-PNPAMB; SOT883(B)
R5: 100K; _0402MP

Connections:
3.3V: PDTA143TMB,315.2 (E), R5.2
GPIO13: PDTA143TMB,315.1 (B), R5.1
