trollock/Solar_LoRa_GPS/Hardware/TPL5110_Nano_Power_Switch/SparkFun_TPL5110_Nano_Power_Switch.sch

## EAGLE design Hardware/TPL5110_Nano_Power_Switch/SparkFun_TPL5110_Nano_Power_Switch.sch (2019-12-12)

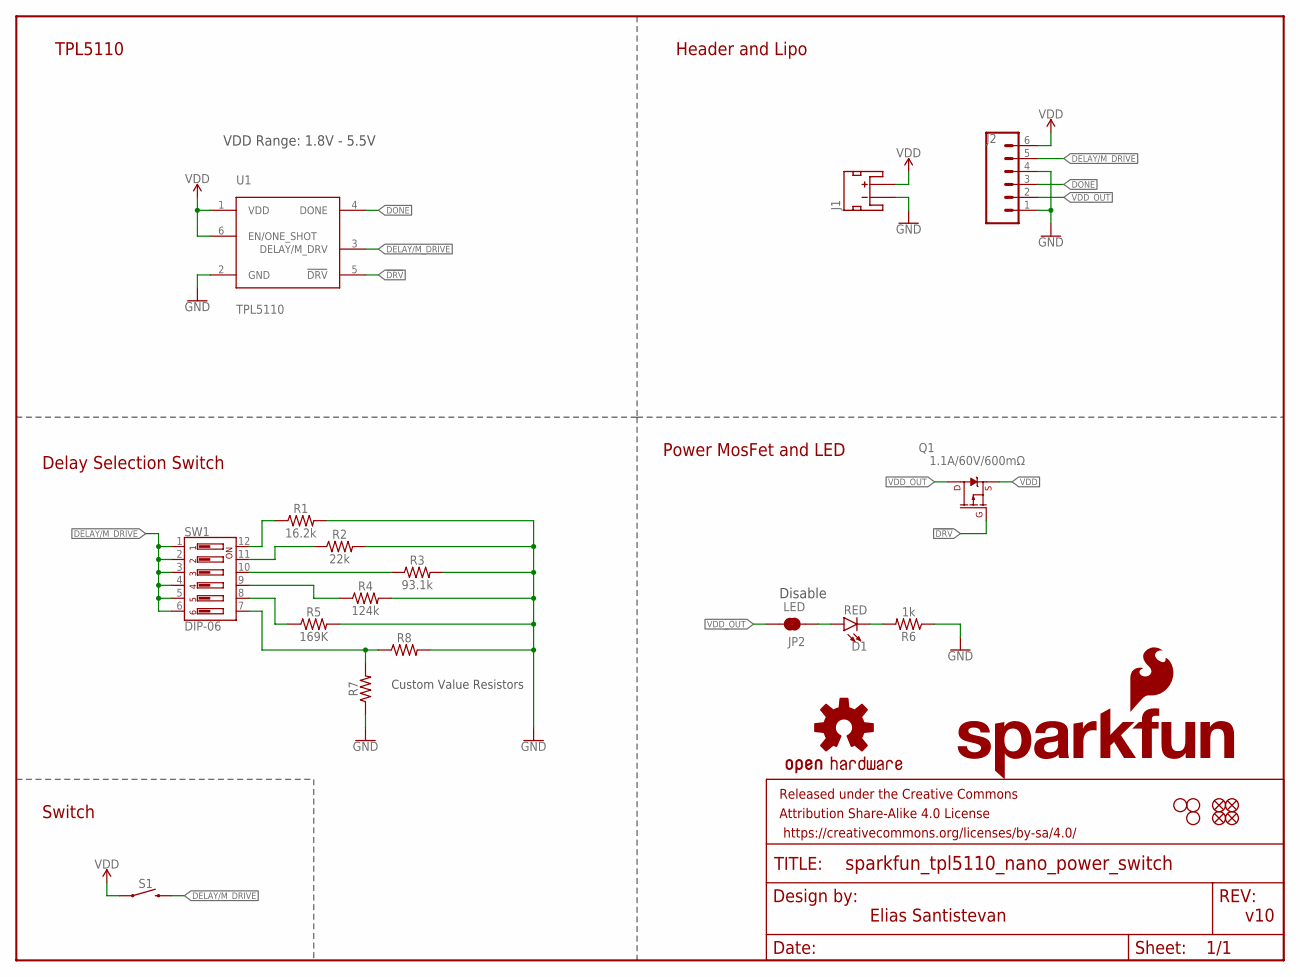
[picture p56: schematic SparkFun_TPL5110_Nano_Power_Switch.sch]

Parts:
D1: RED; LED-0603
FD1, FD2, FD3, FD4: FIDUCIALUFIDUCIAL; FIDUCIAL-MICRO
FRAME1: FRAME-LETTER; CREATIVE_COMMONS
H1, H2, H4: STAND-OFFTIGHT; STAND-OFF-TIGHT
J1: JST_2MM_MALE; JST-2-SMD
J2: CONN_06NO_SILK_NO_POP; 1X06_NO_SILK
JP2: LED; SMT-JUMPER_2_NC_TRACE_SILK
LOGO1: SFE_LOGO_NAME.1_INCH; SFE_LOGO_NAME_.1
LOGO2: OSHW-LOGOS; OSHW-LOGO-S
LOGO3: SFE_LOGO_FLAME.1_INCH; SFE_LOGO_FLAME_.1
Q1: 1.1A/60V/600mΩ; SOT23-3
R1: 16.2k; 0603
R2: 22k; 0603
R3: 93.1k; 0603
R4: 124k; 0603
R5: 169K; 0603
R6: 1k; 0603
R7: 0603
R8: AXIAL-0.3
S1: MOMENTARY-SWITCH-SPST-SMD-5.2MM-TALL; TACTILE_SWITCH_SMD_5.2MM
SW1: DIP-06; DIPSWITCH-06-SMD
U1: TPL5110; SOT23-6

Connections:
!DRV: Q1.1 (G), U1.5 (!DRV)
DELAY/M_DRIVE: J2.5, S1.3 (2), SW1.1, SW1.2, SW1.3, SW1.4, SW1.5, SW1.6, U1.3 (DELAY/M_DRV)
DONE: J2.3, U1.4 (DONE)
GND: J1.1 (-), J2.1, J2.4, R1.2, R2.2, R3.2, R4.2, R5.2, R6.1, R7.1, R8.P$2 (2), U1.2 (GND)
unnamed: D1.C, R6.2
unnamed: R1.1, SW1.12
unnamed: R2.1, SW1.11
unnamed: R3.1, SW1.10
unnamed: R4.1, SW1.9
unnamed: R5.1, SW1.8
unnamed: R7.2, R8.P$1 (1), SW1.7
unnamed: D1.A, JP2.1
VDD: J1.2 (+), J2.6, Q1.2 (S), S1.1, U1.1 (VDD), U1.6 (EN/ONE_SHOT)
VDD_OUT: J2.2, JP2.2, Q1.3 (D)

Notes on the sheet:
Elias Santistevan
v10
VDD Range: 1.8V - 5.5V
TPL5110
Header and Lipo
Power MosFet and LED
Delay Selection Switch
Switch
Disable
Custom Value Resistors
