trollock/Solar_LoRa_GPS/Hardware/ZOE_M8Q_uBlox_Receiver/SparkFun_ZOE-M8Q GPS.sch

## EAGLE design Hardware/ZOE_M8Q_uBlox_Receiver/SparkFun_ZOE-M8Q GPS.sch (2019-11-02)

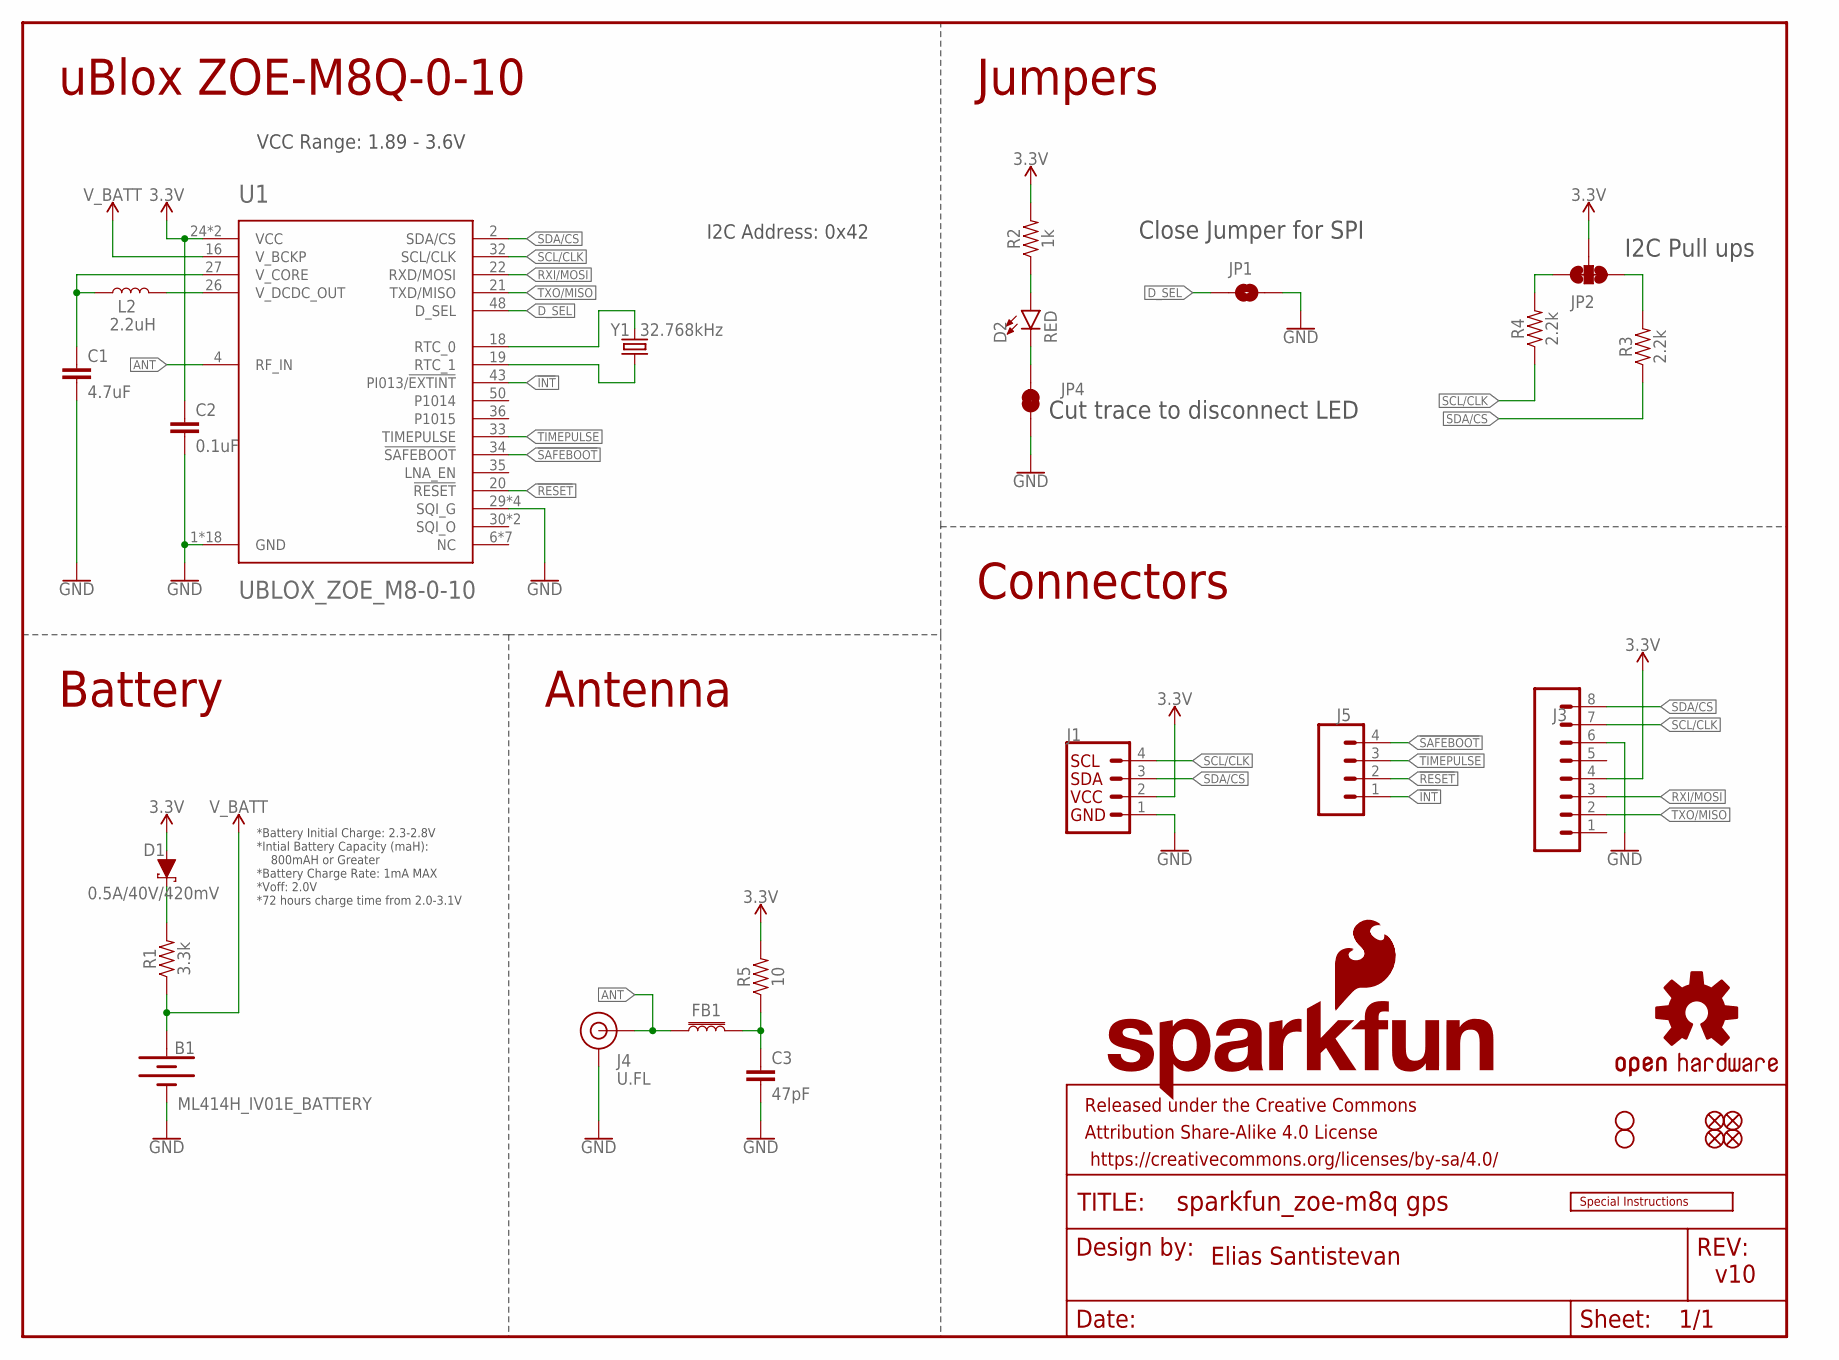
[picture p57: schematic SparkFun_ZOE-M8Q GPS.sch]

Parts:
B1: ML414H_IV01E_BATTERY; ML414H_IV01E
C1: 4.7uF; 0603
C2: 0.1uF; 0603
C3: 47pF; 0603
D1: 0.5A/40V/420mV; SOD-323
D2: RED; LED-0603
FB1: FERRITE_BEAD-120_OHM-0402; 0402
FD1, FD2, FD3, FD4: FIDUCIALUFIDUCIAL; FIDUCIAL-MICRO
FRAME1: FRAME-LETTER; CREATIVE_COMMONS
H2, H3: STAND-OFFTIGHT; STAND-OFF-TIGHT
J1: QWIIC_CONNECTORJS-1MM; JST04_1MM_RA
J3: CONN_08NO_SILK_FEMALE_PTH; 1X08_NO_SILK
J4: U.FL
J5: CONN_041X04_NO_SILK; 1X04_NO_SILK
JP1: JUMPER-SMT_2_NO_SILK; SMT-JUMPER_2_NO_SILK
JP2: JUMPER-SMT_3_2-NC_TRACE_SILK; SMT-JUMPER_3_2-NC_TRACE_SILK
JP4: JUMPER-SMT_2_NC_TRACE_SILK; SMT-JUMPER_2_NC_TRACE_SILK
L2: 2.2uH; 0806
LOGO1: SFE_LOGO_NAME_FLAME.1_INCH; SFE_LOGO_NAME_FLAME_.1
LOGO2: OSHW-LOGOS; OSHW-LOGO-S
LOGO3: SFE_LOGO_FLAME.1_INCH; SFE_LOGO_FLAME_.1
LOGO4: SPECIAL_INSTRUCTIONS-ORDERING; ORDERING_INSTRUCTIONS
R1: 3.3k; 0603
R2: 1k; 0603
R3, R4: 2.2k; 0603
R5: 10; 0603
U1: UBLOX_ZOE_M8-0-10
Y1: 32.768kHz; CRYSTAL-SMD-3.2X1.5MM

Connections:
3.3V: C2.1, D1.A, J1.2, J3.4, JP2.2, R2.2, R5.2, U1.24 (VCC)
!INT: J5.1, U1.43 (PI013/!EXTINT)
!RESET: J5.2, U1.20 (!RESET)
!SAFEBOOT: J5.4, U1.34 (!SAFEBOOT)
ANT: FB1.1, J4.FEED (SIGNAL), U1.4 (RF_IN)
D_SEL: JP1.1, U1.48 (D_SEL)
GND: B1.-, C1.2, C2.2, C3.2, J1.1, J3.6, J4.1 (GND), JP1.2, JP4.1, U1.1 (GND), U1.29 (SQI_G)
unnamed: JP2.1, R3.2
unnamed: D1.C, R1.2
unnamed: JP2.3, R4.2
unnamed: D2.A, R2.1
unnamed: C1.1, L2.1, U1.27 (V_CORE)
unnamed: L2.2, U1.26 (V_DCDC_OUT)
unnamed: D2.C, JP4.2
unnamed: C3.1, FB1.2, R5.1
unnamed: U1.18 (RTC_0), Y1.P$2 (2)
unnamed: U1.19 (RTC_1), Y1.P$1 (1)
RXI/MOSI: J3.3, U1.22 (RXD/MOSI)
SCL/CLK: J1.4, J3.7, R4.1, U1.32 (SCL/CLK)
SDA/CS: J1.3, J3.8, R3.1, U1.2 (SDA/CS)
TIMEPULSE: J5.3, U1.33 (TIMEPULSE)
TXO/MISO: J3.2, U1.21 (TXD/MISO)
V_BATT: B1.+, R1.1, U1.16 (V_BCKP)

Notes on the sheet:
v10
Elias Santistevan
uBlox ZOE-M8Q-0-10
Battery
Connectors
Jumpers
Close Jumper for SPI
I2C Pull ups
Cut trace to disconnect LED
Antenna
*Battery Initial Charge: 2.3-2.8V *Intial Battery Capacity (maH): 800mAH or Greater *Battery Charge Rate: 1mA MAX *Voff: 2.0V *72 hours charge time from 2.0-3.1V
VCC Range: 1.89 - 3.6V
I2C Address: 0x42
