trollock/Solar_LoRa_GPS/Hardware/MCUs/Atmel_SAMD21G18E/SparkFun_Qwiic_Micro_SAMD21E.sch

## EAGLE design Hardware/MCUs/Atmel_SAMD21G18E/SparkFun_Qwiic_Micro_SAMD21E.sch (2019-11-02)

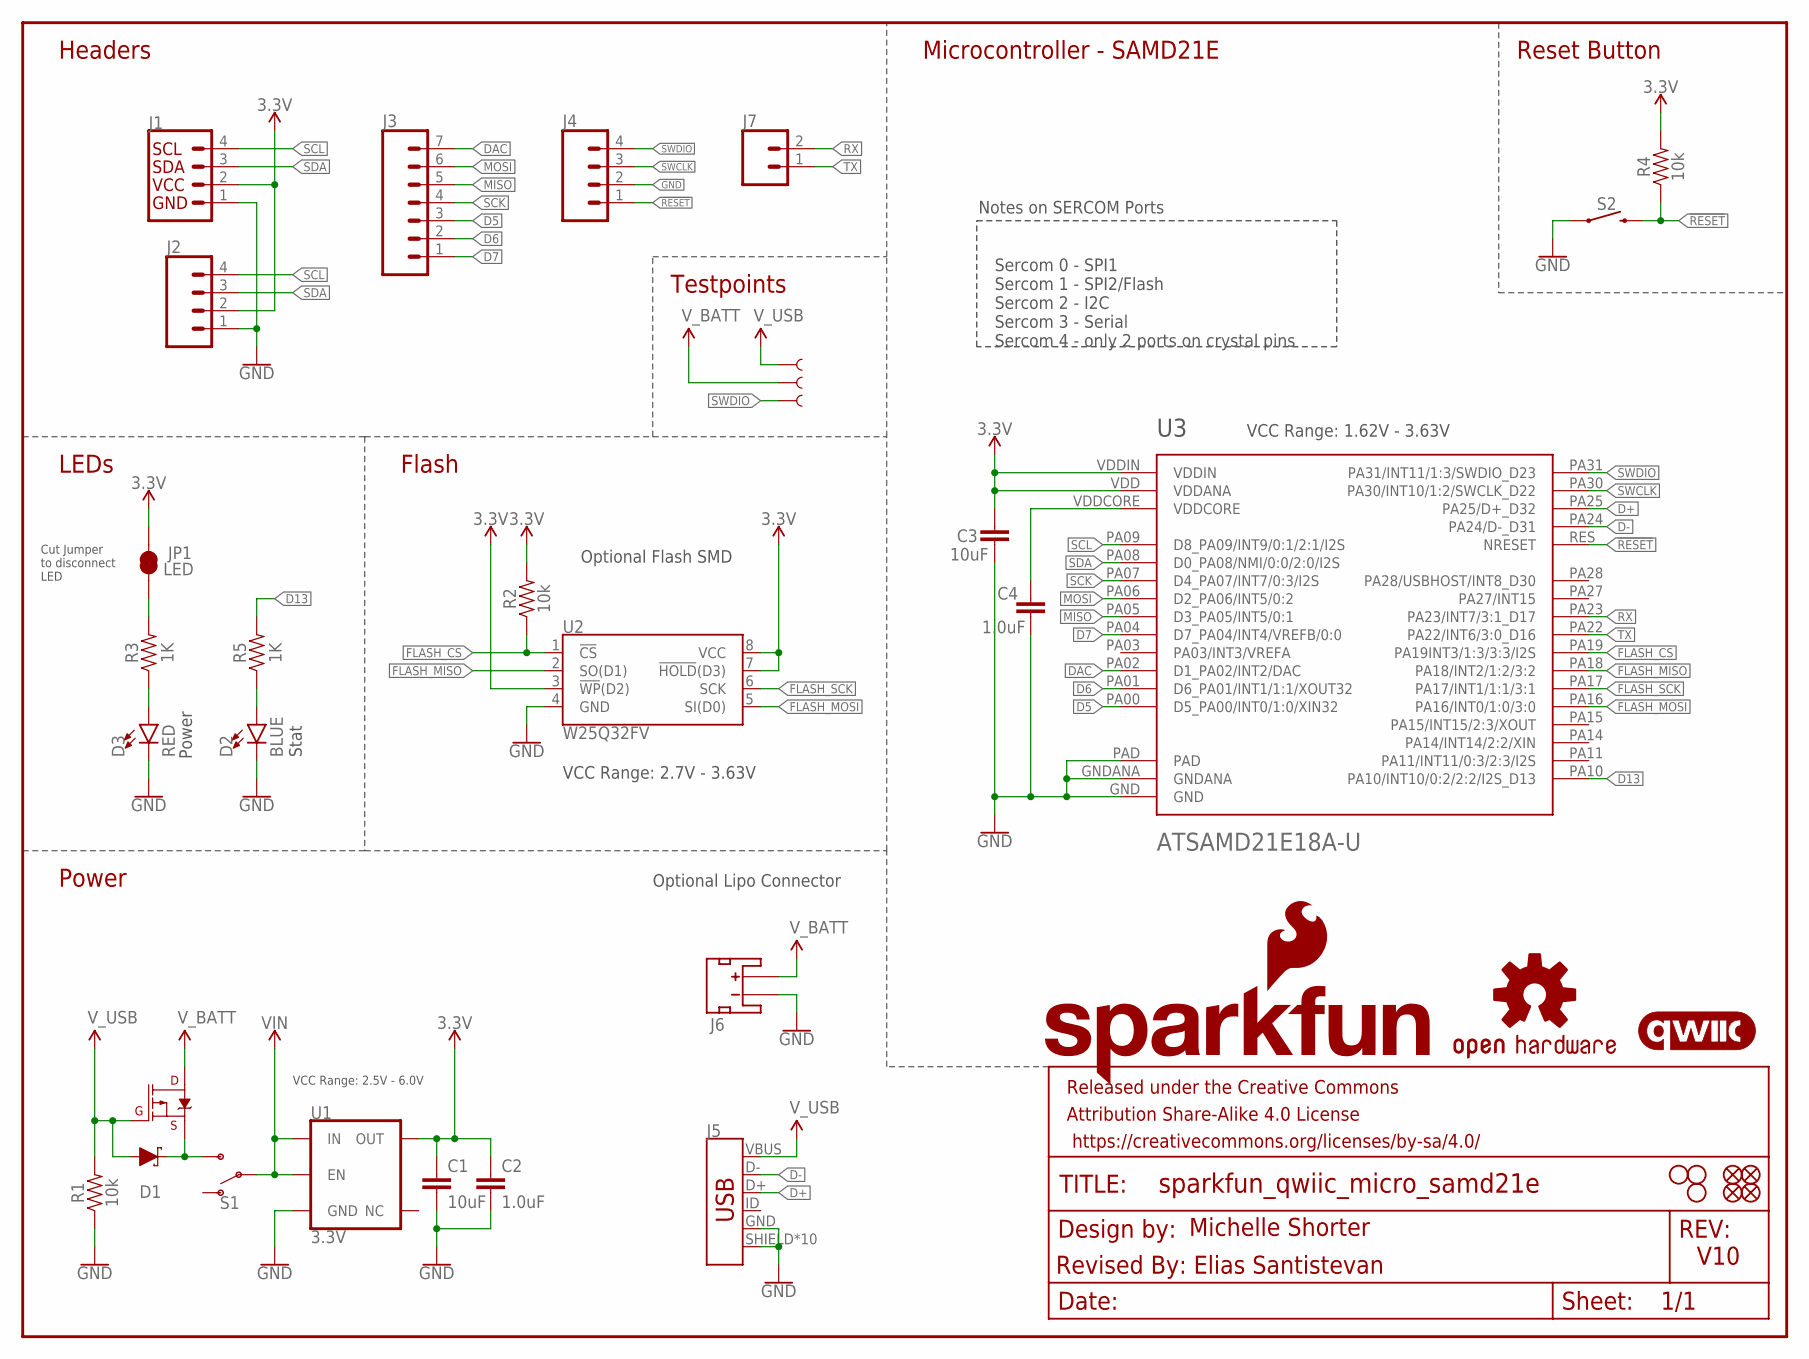
[picture p58: schematic SparkFun_Qwiic_Micro_SAMD21E.sch]

Parts:
C1, C3: 10uF; 0603
C2, C4: 1.0uF; 0402
D1: 1A/23V/620mV; SOD-323
D2: BLUE; LED-0603
D3: RED; LED-0603
FD1, FD2, FD3, FD4: FIDUCIALUFIDUCIAL; FIDUCIAL-MICRO
FRAME1: FRAME-LETTER; CREATIVE_COMMONS
H1, H2, H3: STAND-OFF
J1: QWIIC_CONNECTORJS-1MM; JST04_1MM_RA
J2: CONN_041X04_NO_SILK; 1X04_NO_SILK
J3: CONN_07NO_SILK; 1X07_NO_SILK
J4: CONN_041.27MM_NO_SILK; 1X04_1.27MM_NO_SILK
J5: USB_MICRO-B_HALF_PTH_MILL; USB-MICROB-PTH-MILL
J6: JST_2MM_MALE; JST-2-SMD
J7: CONN_021X02_NO_SILK; 1X02_NO_SILK
JP1: LED; SMT-JUMPER_2_NC_TRACE_SILK
LOGO1: SFE_LOGO_NAME.1_INCH; SFE_LOGO_NAME_.1
LOGO2: SFE_LOGO_FLAME.2_INCH; SFE_LOGO_FLAME_.2
LOGO3: OSHW-LOGOS; OSHW-LOGO-S
LOGO4: QWIIC_LOGO_3MM; QWIIC_3MM
Q1: 3.1A/30V/105mΩ; SOT23-3
R1, R2, R4: 10k; 0402
R3, R5: 1K; 0402
S1: SWITCH-SPDT-SMD-RIGHT-ANGLE; SWITCH_SPST_SMD_A
S2: MOMENTARY-SWITCH-SPST-SMD-4.6X2.8MM; TACTILE_SWITCH_SMD_4.6X2.8MM
TP1, TP2, TP3: TEST-POINTTP_15TH_THRU; TP_15TH
U1: 3.3V; SOT23-5
U2: W25Q32FV; SOIC-8
U3: ATSAMD21E18A-U; QFN-32_SAMD

Connections:
3.3V: C1.1, C2.1, C3.1, J1.2, J2.2, JP1.2, R2.2, R4.2, U1.5 (OUT), U2.3 (!WP!(D2)), U2.7 (!HOLD!(D3)), U2.8 (VCC), U3.VDD (VDDANA), U3.VDDIN
!RESET: J4.1, R4.1, S2.3 (2), U3.RES (NRESET)
D5: J3.3, U3.PA00 (D5_PA00/INT0/1:0/XIN32)
D6: J3.2, U3.PA01 (D6_PA01/INT1/1:1/XOUT32)
D7: J3.1, U3.PA04 (D7_PA04/INT4/VREFB/0:0)
D13: R5.2, U3.PA10 (PA10/INT10/0:2/2:2/I2S_D13)
D+: J5.D+, U3.PA25 (PA25/D+_D32)
D-: J5.D-, U3.PA24 (PA24/D-_D31)
DAC: J3.7, U3.PA02 (D1_PA02/INT2/DAC)
FLASH_CS: R2.1, U2.1 (!CS!), U3.PA19 (PA19INT3/1:3/3:3/I2S)
FLASH_MISO: U2.2 (SO(D1)), U3.PA18 (PA18/INT2/1:2/3:2)
FLASH_MOSI: U2.5 (SI(D0)), U3.PA16 (PA16/INT0/1:0/3:0)
FLASH_SCK: U2.6 (SCK), U3.PA17 (PA17/INT1/1:1/3:1)
GND: C1.2, C2.2, C3.2, C4.1, D2.C, D3.C, J1.1, J2.1, J4.2, J5.GND, J5.SHIELD, J6.1 (-), R1.1, S2.1, U1.2 (GND), U2.4 (GND), U3.GND, U3.GNDANA, U3.PAD
MISO: J3.5, U3.PA05 (D3_PA05/INT5/0:1)
MOSI: J3.6, U3.PA06 (D2_PA06/INT5/0:2)
unnamed: D3.A, R3.1
unnamed: JP1.1, R3.2
unnamed: D2.A, R5.1
RX: J7.2, U3.PA23 (PA23/INT7/3:1_D17)
SCK: J3.4, U3.PA07 (D4_PA07/INT7/0:3/I2S)
SCL: J1.4, J2.4, U3.PA09 (D8_PA09/INT9/0:1/2:1/I2S)
SDA: J1.3, J2.3, U3.PA08 (D0_PA08/NMI/0:0/2:0/I2S)
SWCLK: J4.3, U3.PA30 (PA30/INT10/1:2/SWCLK_D22)
SWDIO: J4.4, TP3.P$1, U3.PA31 (PA31/INT11/1:3/SWDIO_D23)
TX: J7.1, U3.PA22 (PA22/INT6/3:0_D16)
VDDCORE: C4.2, U3.VDDCORE
VIN: S1.2, U1.1 (IN), U1.3 (EN)
VIN1: D1.C, Q1.2 (S), S1.3 (S)
V_BATT: J6.2 (+), Q1.3 (D), TP2.P$1
V_USB: D1.A, J5.VBUS, Q1.1 (G), R1.2, TP1.P$1

Notes on the sheet:
Sercom 0 - SPI1 Sercom 1 - SPI2/Flash Sercom 2 - I2C Sercom 3 - Serial Sercom 4 - only 2 ports on crystal pins
Headers
LEDs
Power
Microcontroller - SAMD21E
Optional Flash SMD
V10
Michelle Shorter
Revised By: Elias Santistevan
Testpoints
Reset Button
Flash
Cut Jumper to disconnect LED
Notes on SERCOM Ports
Stat
VCC Range: 2.5V - 6.0V
VCC Range: 1.62V - 3.63V
VCC Range: 2.7V - 3.63V
Optional Lipo Connector
