trollock/Solar_LoRa_GPS/Hardware/MCUs/SAMD21_Pro_RF/SAMD21_Pro_RF.sch

## EAGLE design Hardware/MCUs/SAMD21_Pro_RF/SAMD21_Pro_RF.sch (2019-12-12)

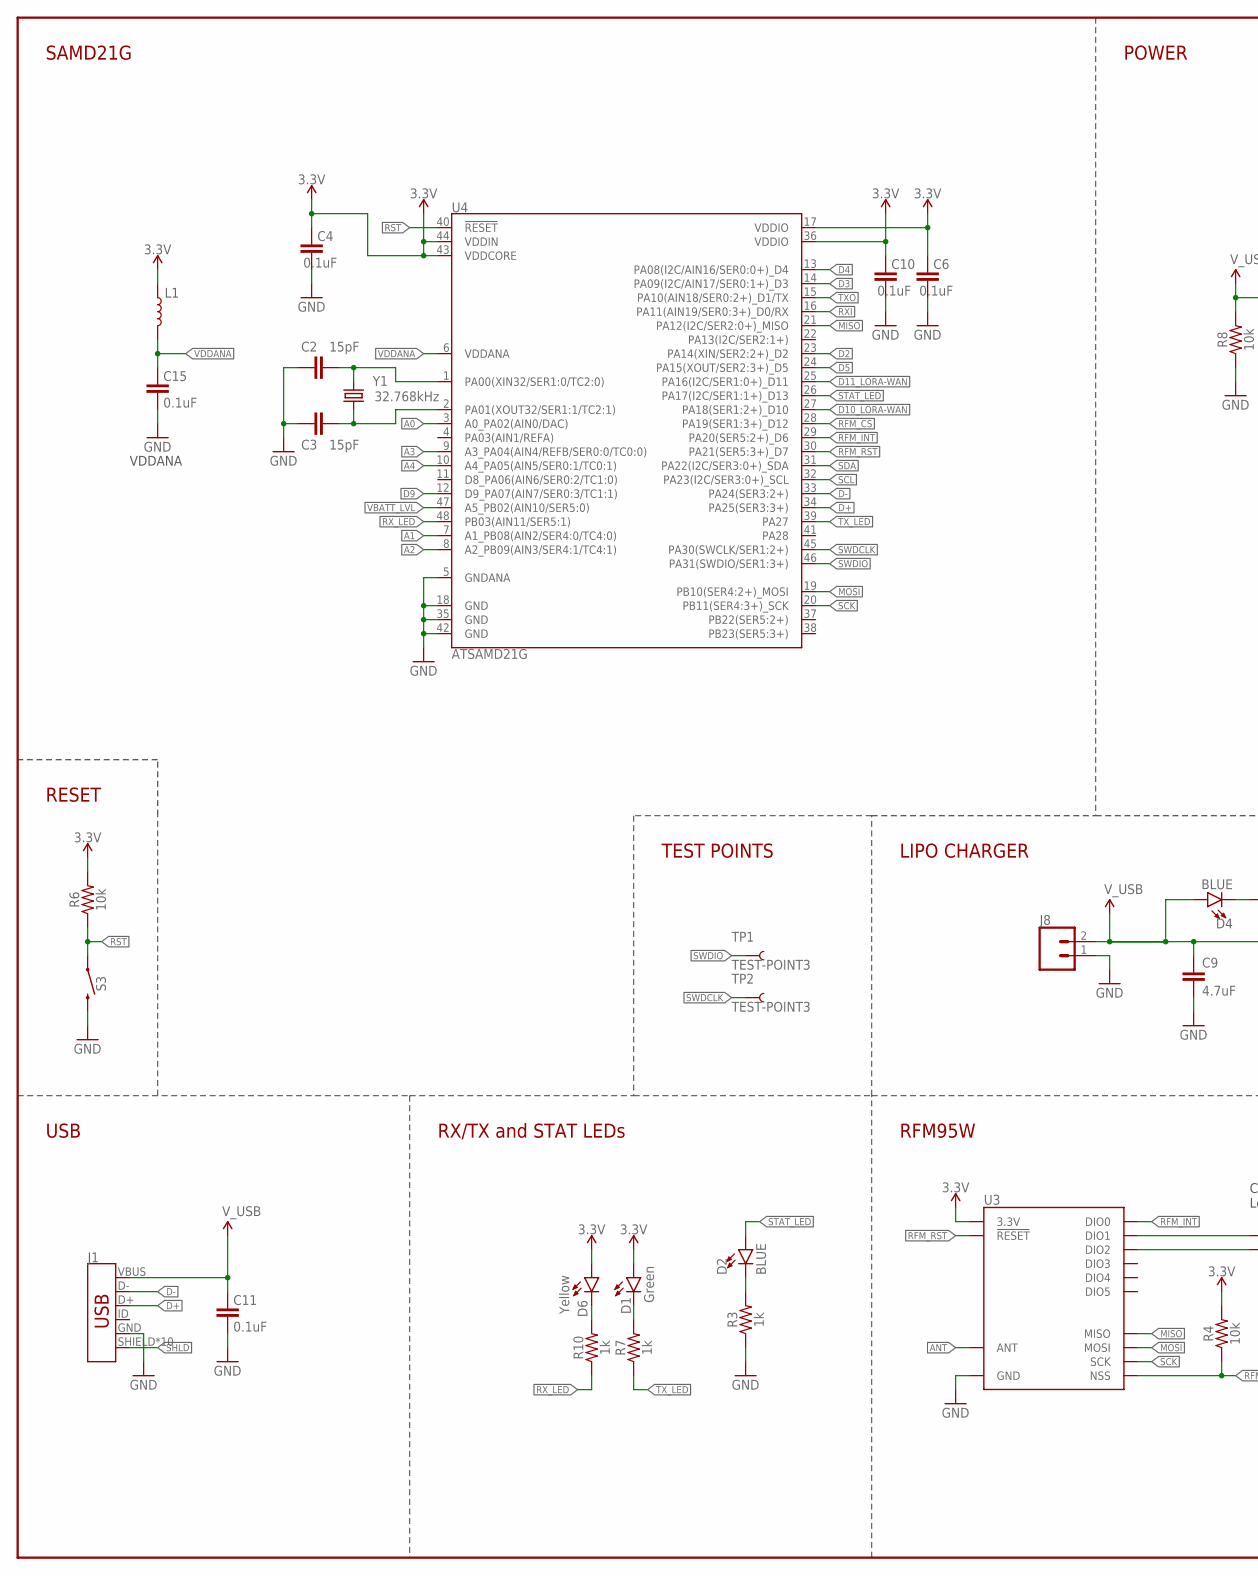
[picture p59: schematic SAMD21_Pro_RF.sch, part in row 1, column 1]

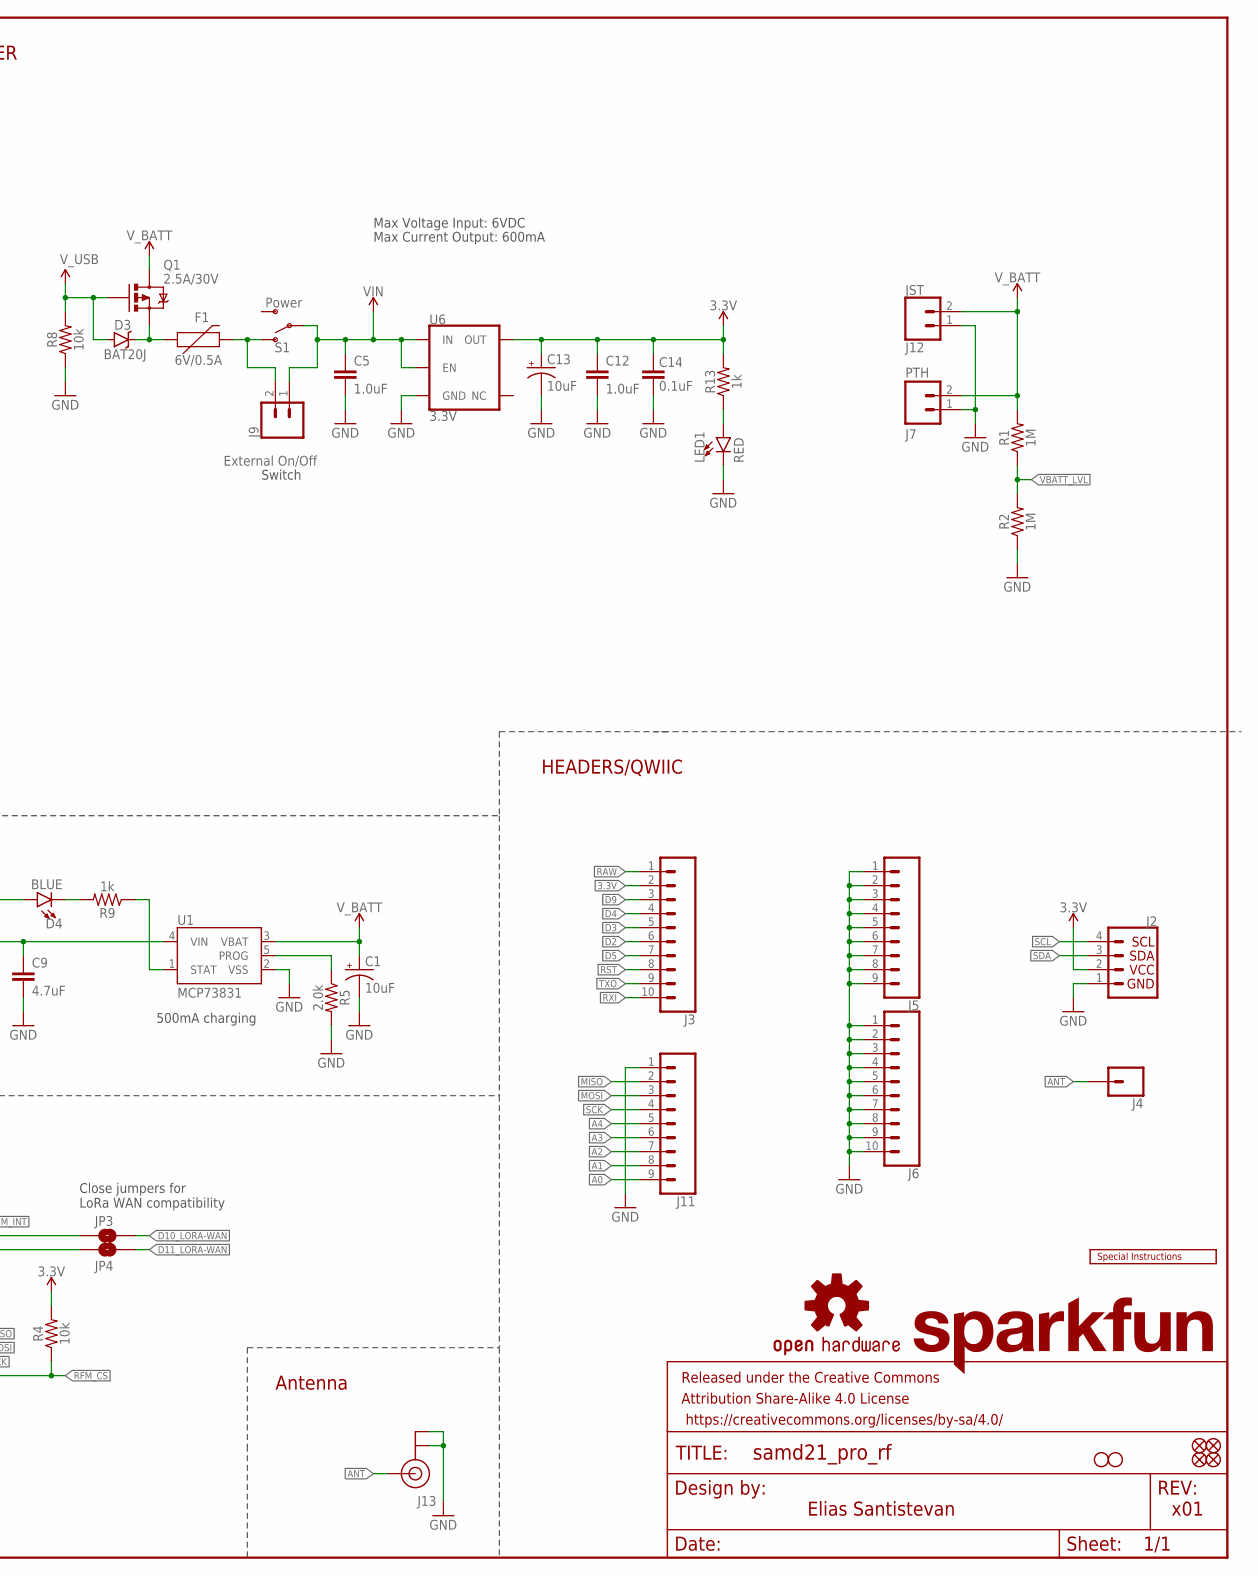
[picture p60: schematic SAMD21_Pro_RF.sch, part in row 1, column 2]

Parts:
C1, C13: 10uF; EIA3216
C2, C3: 15pF; 0603
C4, C6, C10, C11, C14, C15: 0.1uF; 0603
C5, C12: 1.0uF; 0603
C9: 4.7uF; 0603
D1: Green; LED-0603
D2, D4: BLUE; LED-0603
D3: BAT20J; SOD-323
D6: Yellow; LED-0603
F1: 6V/0.5A; 1206
FD1, FD2, FD3, FD4: FIDUCIAL1X2; FIDUCIAL-1X2
FRAME2: FRAME-LEDGER; CREATIVE_COMMONS
H1, H2: STAND-OFFTIGHT; STAND-OFF-TIGHT
J1: USB_MICRO-B_HALF_PTH_MILL; USB-MICROB-PTH-MILL
J2: QWIIC_CONNECTORJS-1MM; 1X04_1MM_RA
J3, J6: CONN_10NO_SILK_PTH_FEMALE; 1X10_NO_SILK
J4: CONN_01PTH_NO_SILK_YES_STOP; 1X01_NO_SILK
J5, J11: CONN_09NO_SILK; 1X09_NO_SILK
J7: PTH; 1X02_NO_SILK
J8: CONN_021X02_NO_SILK; 1X02_NO_SILK
J9: External On/Off; 1X02_NO_SILK
J12: JST; JST-2-SMD
J13: U.FL
JP3, JP4: JUMPER-SMT_2_NO_SILK; SMT-JUMPER_2_NO_SILK
L1: INDUCTORFB-30OHM; 0603
LED1: RED; LED-0603
LOGO1: OSHW-LOGOMINI; OSHW-LOGO-MINI
LOGO2: SFE_LOGO_NAME.1_INCH; SFE_LOGO_NAME_.1
Q1: 2.5A/30V; SOT23-3
R1, R2: 1M; 0603
R3, R7, R9, R10, R13: 1k; 0603
R4, R6, R8: 10k; 0603
R5: 2.0k; 0603
S1: Power; SWITCH_SPST_SMD_A
S3: MOMENTARY-SWITCH-SPST-SMD-RIGHT-ANGLE; TACTILE_SWITCH_SMD_RIGHT_ANGLE
TP1, TP2: TEST-POINT3; PAD.03X.03
U1: MCP73831; SOT23-5
U3: RFM95W; RFM95/96/97/98W
U4: ATSAMD21G; QFN-48_NO_EXPOSED_PAD
U6: 3.3V; SOT23-5
U$26: SPECIAL_INSTRUCTIONS-ORDERING; ORDERING_INSTRUCTIONS
Y1: 32.768kHz; CRYSTAL-SMD-3.2X1.5MM

Connections:
3.3V: C4.2, C6.2, C10.2, C12.1, C13.+, C14.2, D1.A, D6.A, J2.2, J3.2, L1.1, R4.2, R6.2, R13.2, U3.3.3V, U4.17 (VDDIO), U4.36 (VDDIO), U4.43 (VDDCORE), U4.44 (VDDIN), U6.5 (OUT)
!RFM_CS: R4.1, U3.NSS, U4.28 (PA19(SER1:3+)_D12)
!RFM_RST: U3.!RESET, U4.30 (PA21(SER5:3+)_D7)
!RST: J3.8, R6.1, S3.1, U4.40 (!RESET!)
A0: J11.9, U4.3 (A0_PA02(AIN0/DAC))
A1: J11.8, U4.7 (A1_PB08(AIN2/SER4:0/TC4:0))
A2: J11.7, U4.8 (A2_PB09(AIN3/SER4:1/TC4:1))
A3: J11.6, U4.9 (A3_PA04(AIN4/REFB/SER0:0/TC0:0))
A4: J11.5, U4.10 (A4_PA05(AIN5/SER0:1/TC0:1))
ANT: J4.1, J13.FEED (SIGNAL), U3.ANT
CHARGE_STAT: R9.1, U1.1 (STAT)
D2: J3.6, U4.23 (PA14(XIN/SER2:2+)_D2)
D3: J3.5, U4.14 (PA09(I2C/AIN17/SER0:1+)_D3)
D4: J3.4, U4.13 (PA08(I2C/AIN16/SER0:0+)_D4)
D5: J3.7, U4.24 (PA15(XOUT/SER2:3+)_D5)
D9: J3.3, U4.12 (D9_PA07(AIN7/SER0:3/TC1:1))
D10_LORA-WAN: JP3.2, U4.27 (PA18(SER1:2+)_D10)
D11_LORA-WAN: JP4.2, U4.25 (PA16(I2C/SER1:0+)_D11)
D+: J1.D+, U4.34 (PA25(SER3:3+))
D-: J1.D-, U4.33 (PA24(SER3:2+))
GND: C1.-, C2.1, C3.1, C4.1, C5.2, C6.1, C9.2, C10.1, C11.1, C12.2, C13.-, C14.1, C15.1, J1.GND, J2.1, J5.1, J5.2, J5.3, J5.4, J5.5, J5.6, J5.7, J5.8, J5.9, J6.1, J6.2, J6.3, J6.4, J6.5, J6.6, J6.7, J6.8, J6.9, J6.10, J7.1, J8.1, J11.1, J12.1 (2), J13.1 (GND), J13.2 (GND), LED1.C, R2.1, R3.1, R5.2, R8.1, S3.2, U1.2 (VSS), U3.GND@1 (GND), U4.5 (GNDANA), U4.18 (GND), U4.35 (GND), U4.42 (GND), U6.2 (GND)
MISO: J11.2, U3.MISO, U4.21 (PA12(I2C/SER2:0+)_MISO)
MOSI: J11.3, U3.MOSI, U4.19 (PB10(SER4:2+)_MOSI)
unnamed: D6.C, R10.2
unnamed: D1.C, R7.2
unnamed: D2.C, R3.2
unnamed: C2.2, U4.1 (PA00(XIN32/SER1:0/TC2:0)), Y1.P$2 (2)
unnamed: C3.2, U4.2 (PA01(XOUT32/SER1:1/TC2:1)), Y1.P$1 (1)
unnamed: D4.C, R9.2
unnamed: F1.2, J9.2, S1.1 (O)
unnamed: R5.1, U1.5 (PROG)
unnamed: JP3.1, U3.DIO1
unnamed: JP4.1, U3.DIO2
unnamed: LED1.A, R13.1
RAW: D3.C, F1.1, J3.1, Q1.2 (S)
RFM_INT: U3.DIO0, U4.29 (PA20(SER5:2+)_D6)
RXI: J3.10, U4.16 (PA11(AIN19/SER0:3+)_D0/RX)
RX_LED: R10.1, U4.48 (PB03(AIN11/SER5:1))
SCK: J11.4, U3.SCK, U4.20 (PB11(SER4:3+)_SCK)
SCL: J2.4, U4.32 (PA23(I2C/SER3:0+)_SCL)
SDA: J2.3, U4.31 (PA22(I2C/SER3:0+)_SDA)
SHLD: J1.SHIELD
STAT_LED: D2.A, U4.26 (PA17(I2C/SER1:1+)_D13)
SWDCLK: TP2.P$1, U4.45 (PA30(SWCLK/SER1:2+))
SWDIO: TP1.P$1, U4.46 (PA31(SWDIO/SER1:3+))
TXO: J3.9, U4.15 (PA10(AIN18/SER0:2+)_D1/TX)
TX_LED: R7.1, U4.39 (PA27)
VBATT_LVL: R1.1, R2.2, U4.47 (A5_PB02(AIN10/SER5:0))
VDDANA: C15.2, L1.2, U4.6 (VDDANA)
VIN: C5.1, J9.1, S1.2, U6.1 (IN), U6.3 (EN)
V_BATT: C1.+, J7.2, J12.2 (1), Q1.3 (D), R1.2, U1.3 (VBAT)
V_USB: C9.1, C11.2, D3.A, D4.A, J1.VBUS, J8.2, Q1.1 (G), R8.2, U1.4 (VIN)

Notes on the sheet:
Max Voltage Input: 6VDC
Max Current Output: 600mA
500mA charging
Close jumpers for LoRa WAN compatibility
VDDANA
SAMD21G
Elias Santistevan
x01
POWER
LIPO CHARGER
RFM95W
RESET
HEADERS/QWIIC
USB
TEST POINTS
Antenna
RX/TX and STAT LEDs
Switch
