trollock/Solar_LoRa_GPS/Hardware/MCUs/Texas_Instruments_cc1310/swrc320a/Cadence/Allegro/StepOutConfiguration.txt

EXPORT_UNIT = Millimeter
EXPORT_PROTOCOL = 214
BARE_BOARD_ONLY = YES
HILIGHTED_PKG = NO
ALT_STEP = NO
MAPPED_PACKAGE = NO
UNMAPPED_PACKAGE = NO
EXTERNAL_COPPER = YES
MECH_PART = NO
MECH_DRILL = YES
PIN_DRILL = YES
VIA_DRILL = YES
ZIP_FILE = YES

SOURCE_ID = allegro_16.6S019
