trollock/Solar_LoRa_GPS/Hardware/MCUs/Texas_Instruments_cc1310/swrc320a/Cadence/Allegro/pdf_out_config.txt

page_setup/unit=Millimeter
page_setup/paper_size_width=210.000
page_setup/paper_size_height=297.000
page_setup/margin_left=12.700
page_setup/margin_right=12.700
page_setup/margin_top=12.700
page_setup/margin_bottom=12.700
page_setup/header_footer_text_size_width=1.219
page_setup/header_footer_text_size_height=1.219
page_setup/scale_factor=fit_page
page_setup/orientation=portrait
