trollock/Solar_LoRa_GPS/(commit log)

2019-11-04 added v3
    [GPS_radiologger_v2_energy_harvesting.brd, GPS_radiologger_v2_energy_harvesting.sch, GPS_radiologger_v3.brd, GPS_radiologger_v3.sch]
2019-12-12 moar edits
    revision 3 to main board layout, inclusion of TPL5110, possible future exchange for RV-3028
    [Adafruit Feather M0 RFMxx.brd, Adafruit Feather M0 RFMxx.sch, GPS_radiologger_v3.brd, GPS_radiologger_v4.brd, GPS_radiologger_v4.sch, SAMD21_Pro_RF.brd, SAMD21_Pro_RF.sch, SparkFun_TPL5110_Nano_Power_Switch.sch]
2020-06-16 recent changes / update since being idle
    [Component_Masses.xlsx, Duty_Cycle_Battery_Life_Estimates.xlsx, ESP32-TrackerREV2-Corrected-Stencil2.brd, ESP32-TrackerREV2-Corrected-Stencil2.sch, FR4_PCB_Mass_vs_Thickness_Estimates.xlsx, GPS_radiologger_v10.brd, GPS_radiologger_v10.sch, GPS_radiologger_v11.brd]
2020-06-17 rolling along with v14 / implementation of solar power
    [CMWX_LoRa_GPS_v14.brd, CMWX_LoRa_GPS_v14.sch, ESP32-TrackerREV3_PCBWAY.brd, ESP32-TrackerREV3_PCBWAY.sch, GPS_radiologger_v14.brd, GPS_radiologger_v14.sch]
2020-06-19 latest edits v14
    [CMWX_LoRa_GPS_v14.sch, CMWX_LoRa_GPS_v14_CAM.brd, CMWX_LoRa_GPS_v14_CAM.sch, Zigzag ISP connector.brd, Zigzag ISP connector.sch]
2020-07-22 recent general edits
    [CMWX_LoRa_GPS_v14_Test.brd, CMWX_LoRa_GPS_v14_Test.sch, GPS_radiologger_v15.brd, GPS_radiologger_v15.sch, GPS_radiologger_v16.brd, GPS_radiologger_v16.sch]
2020-09-10 recent board updates
    [GPS_radiologger_v1.brd, GPS_radiologger_v1.sch, GPS_radiologger_v10.brd, GPS_radiologger_v10.sch, GPS_radiologger_v11.brd, GPS_radiologger_v11.sch, GPS_radiologger_v12.brd, GPS_radiologger_v12.sch]
2020-11-18 recent updates
    recent updates
    [FR4_PCB_Mass_vs_Thickness_Estimates.xlsx, GPS_radiologger_v18_LoRa_only.brd, GPS_radiologger_v18_LoRa_only.sch, GPS_radiologger_v19.brd, GPS_radiologger_v19.sch, GPS_radiologger_v20.brd, GPS_radiologger_v20.sch, LoRa.v01h.brd]
2020-12-24 typical updates
    recent changes, updates to v19
    [GPS_radiologger_v19_LoRa_only.brd, GPS_radiologger_v19_LoRa_only.sch, Parts_Cost.xlsx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]
2020-12-30 recent updates
    added basic *.ino file for tag testing
    [duty_cycle_estimation_simple.xlsx]
2023-01-23 v27_updates
    recent updates with some hardware changes, switch from L70-M39B to LG77L Quectel GPS modules
    [2021-08-28-GPS-records.csv, 2021-08-29-GPS-records.csv, 2021-08-30-GPS-records.csv, 2021-09-01-GPS-records.csv, 2021-09-02-GPS-records.csv, 2021-09-03-GPS-records.csv, 2021-09-04-GPS-records.csv, 2021-09-05-GPS-records.csv]
